Kitjesen/orix/training/runtime/README.md

# SmallDog V67 / MoE-CTS 仿真接入

本目录固定采用 V67 外观、原机架和 12 关节、电池。V67 头部和耳朵在本轮作为固定组件。

## 当前资产与训练（2026-10-14）

当前运动资产为 `v67_sim_r3`：大腿位置范围包含零位，calf 最大绝对角度扩到 2.10 rad；默认站姿与高度沿用 r2。几何采样、真实 Isaac 站立/扩展动作、平地/多地形接触和 80 环境热启动测试已通过。参数来源为 `joint_motion_config.json`；当前范围、证据和启动记录见 [TRAINING_R3_20261014.md](TRAINING_R3_20261014.md)。r2 历史记录见 [JOINT_WINDOW_R2_20261013.md](JOINT_WINDOW_R2_20261013.md)。

FlatGait 600 次迭代和后续 RoughGait 1800 次追加迭代均已完成，最终模型 `model_2398.pt`。速度课程已解锁到 1.0 m/s，平均地形等级 3.64。独立测试：1.0 m/s 平地实际均速 0.922、16 环境 10 秒 0 次终止；80 环境多地形实际均速 0.892、7 次终止，全部在台阶组。结果与剩余问题见 [R3_RESULTS_20261014.md](R3_RESULTS_20261014.md)。下文早期批次记录为历史。

## 数据和假设

- 壳体及安装件来自 `design/v67_continuous_head_tail/assembly.json` 对应实际闭合网格，按记录的 PETG / 铝 / 钢密度计算体积、质量、质心、惯量；没有使用旧 V3 外壳惯量。
- 电池继续采用 1.6 kg 占位；头部电子件预留 0.2 kg，计算板预留 0.15 kg。两项电子质量未实测。
- 总质量估算 13.902960 kg；基础机械零件惯量保留原记录。
- 计算板占位从 z=126 mm 下移至 110 mm，避免穿出 V67 上盖。这是仿真布置提案，安装结构尚未设计。
- 用户在 2026-10-12 确认 calf 按总等效 2∶1 接入。RS02 模组输出轴之后的速比乘一次，不重复乘内部 7.75。
- 仿真名义条件 48 V。hip/thigh 力矩限幅 7 N·m；calf 为 14 N·m。速度上限分别 42.9351 / 21.4675 rad/s。DCMotor 线性饱和包络采用 17 / 34 N·m 截距，是保守近似，不是官方完整 T-N 曲线或热模型。
- 输出轴旋转惯量 hip/thigh 0.0042 kg·m²，calf 按速比平方折算为 0.0168 kg·m²。
- 初始 PD：hip/thigh Kp=40、Kd=0.8；calf Kp=60、Kd=1.5，均为关节端仿真整定值。
- 位置限位采用本轮基于模型采样并经过 Isaac 验证的仿真窗口，详见当前资产报告；不是实测硬止挡。动作目标裁剪到各区间中间 90% 的软窗口。
- 上盖、头部和耳朵使用分离凸包，侧板和腹部采用简单碰撞体；保留原腿部碰撞和四个独立足端。碰撞代理不能替代 CAD 干涉检验。

以上配置支持仿真开发，不是实机控制参数确认。

## 文件

- `joint_motion_config.json`：当前运动窗口、默认站姿、root 高度、软限位和动作缩放的来源。
- `build_asset.py`：从 V67 源文件、运动参数和已保存的外观预览重新生成质量、碰撞和完整资产。
- `assets/smalldog_v67/urdf/smalldog_v67.urdf`：新的仿真 URDF。
- `assets/smalldog_v67/config/model_contract.json`：质量明细、初始角度和假设。
- `overlay/`：合入 Go2 RL RobotLab 源码的 SmallDog 专用配置和验证脚本。

环境 ID：`RobotLab-SmallDog-V67-Flat-v0`。
算法：上游 `OnPolicyRunnerCTS` / `ActorCriticMoECTS`，8 专家，teacher 环境比例 75%。
首轮任务：低速平地；前后速度 -0.15～0.35 m/s、横移 ±0.10 m/s、转速 ±0.3 rad/s。

## 服务器命令

工程：`/root/autodl-tmp/workspace/smalldog_cts_moe`。
此服务器 Isaac 的无显示 GPU 启动使用现有 EGL Vulkan ICD：

```bash
cd /root/autodl-tmp/workspace/smalldog_cts_moe
export VK_ICD_FILENAMES=/root/autodl-tmp/vulkan/nvidia_egl_icd.json
./python.sh scripts/smalldog/check_import.py --headless --device cuda:0
./python.sh scripts/rsl_rl/train.py --task RobotLab-SmallDog-V67-Flat-v0 --headless --device cuda:0 --num_envs 128 --max_iterations 200
```

先检查 `validation/v67_import/report.json`，通过质量、关节、足端和静止支撑检查后启动训练。CPU 网络测试、URDF 静态检查和真实 Isaac rollout 是不同的证据。

## 本轮结果与 R2

- 真实 Isaac 导入和 5 秒静止支撑检查通过，报告在 `validation/isaac_import_report.json`。
- R1：128 环境、200 次迭代已完成，614400 个环境步；保存 `model_199.pt`。
- R1 学生策略测试：16 环境、10 秒、0.2 m/s 前进指令，0 次终止，平均速度约 -0.000388 m/s，平均绝对误差 0.200388 m/s。说明只学到了支撑，尚未学会跟随前进指令。
- R2：线速度奖励核 std 从 0.5 改为 0.2，角速度 std 从 0.5 改为 0.35，增加权重 0.25 的足端离地时间奖励（阈值 0.12 s）。机器人、限位和 2∶1 传动不变。
- `continue_v67_r2.sh` 从指定 R1 checkpoint 继续，512 环境、1800 次额外迭代。RSL-RL 恢复时计数从 199 开始，因此迭代编号可能重叠一轮。
- 尚未证明稳定行走。训练结果必须再次使用学生策略测试实际速度和姿态。
- 启用相机时 RTX 插件仍出现原生崩溃；无相机模式的物理仿真和训练已运行。没有提供虚构的 Isaac 渲染图。

## R2 完成与独立评估（2026-10-12）

- 北京时间约 15:44:57 保存最终模型 `model_1998.pt`，训练进程已退出。
- 512 个并行环境，从 R1 恢复后额外运行 1800 次迭代，22,118,400 个环境步，耗时 42 分 57 秒。
- 最终学生策略独立测试：16 个环境、10 秒、前进指令 0.2 m/s；第 2 秒后平均前进速度 -0.00016824 m/s，平均绝对速度误差 0.20016822 m/s。
- 测试终止次数 0，平均直立余弦 0.98998。能维持姿态，但尚未学会有效前进，不能判定训练成功。
- 本地保存：`training/v67_cts/checkpoints/model_1998.pt`、`training/v67_cts/validation/student_eval_r2.json`、`training/v67_cts/validation/v67_r2.log`。
- 后续应检查动作裁剪、足端抬起与接触、关节力矩及奖励贡献；目前这些只是待排查方向，尚未确定失败原因。未自动启动第三轮训练。

## R3：4096 环境续训（2026-10-12）

用户要求将并行环境增至 4096，已从 R2 `model_1998.pt` 启动 `v67_rs02_2to1_r3_4096`，追加 1800 次迭代，奖励、机器人资产及执行器参数沿用 R2。启动脚本：`overlay/continue_v67_r3_4096.sh`；远程日志：`validation/v67_r3_4096.log`。进程 PID 819348。启动检查已看到 iteration 2015/3798，约 55,852 环境步/秒，整卡显存约 19.5 GB（含其他任务），无启动失败。该记录仅证明已开始迭代，不证明已学会行走。

## R3 中期评估：model_3100.pt（2026-10-12 16:42 左右，北京时间）

- 对照本地渲染源与服务器训练 URDF，文件内容完全相同。
- 4096 环境续训仍在运行；16:41 日志为 iteration 3159/3798。
- 独立学生策略评估：16 环境，10 秒，前进指令 0.2 m/s。第 2 秒后平均前进速度 0.0943302 m/s，平均绝对速度误差 0.1056705 m/s，终止次数 0，平均直立余弦 0.9973658。
- 相比 R2 近零前进速度有进展，但该短时平地测试未证明稳定步态、足端无滑动、复杂地形或实机能力。
- 评估报告：validation/student_eval_r3_3100.json。

## R3 最终模型与 1.0 m/s 指令测试（2026-10-12）

- 4096 环境续训结束，最终 model_3797.pt，日志耗时 51:07；最终模型已下载至 checkpoints/。
- 使用最终学生策略，16 环境、平地、固定前进指令 1.0 m/s，10 秒。
- 第 2 秒后平均速度 0.0145102 m/s，平均绝对速度误差 0.9854898 m/s，累计终止重置 11 次，平均直立余弦 0.9816115。统计包含重置后的轨迹，不能把 11 次解释为 11 个不同环境跌倒，未细分原因。
- 1.0 m/s 超出训练命令上限 0.35 m/s；本次结果不支持 1 m/s 行走能力，也不能推出机器人硬件速度上限。
- 报告：validation/student_eval_r3_3797_vx1.json。evaluate.py 新增 --command-vx，默认仍为 0.2，仅更改评估入口。

## R4 多地形与速度课程已接入（2026-10-12）

正式任务 `RobotLab-SmallDog-V67-Rough-v0`，4096 环境，8 类地形，从最低等级开始；前进命令上限按表现从 0.35 增至 1.0 m/s。完整配置见 ROUGH_TRAINING.md。

当前运行：`2026-10-12_17-35-59_v67_rough_speed_r4`，由 R3 model_3797.pt 继续，追加 3000 次迭代。早期启动版本因首回合计时影响课程评分被主动停止，当前版本已排除该问题。验证报告 validation/rough_import_report.json；实际运行配置 validation/r4_config/。验证通过表示接入可运行，不表示已学会复杂地形或 1 m/s。

## R4 中期效果（2026-10-12 17:56 后）

17:56 训练日志 iteration 4177/6797，运行 20 分钟，速度课程上限仍为 0.35 m/s，平均地形等级 0.1296。

model_4100.pt 学生策略独立测试：80 环境，8 类第 0 级地形，固定前进命令 0.2 m/s，10 秒。平均前进速度 0.182663 m/s，平均绝对速度误差 0.071250 m/s，累计终止 0。平地 0.193479 m/s；stairs_down 配置场景 0.114690 m/s，其他场景详见 validation/student_eval_r4_4100_rough.json。

测试关闭观测噪声和域随机化；只证明低等级地形上的短时低速表现，不证明完整地形穿越、高等级障碍、标准步态或实机能力。平均速度接近指令不代表瞬时速度误差很小。

## R5 续训（2026-10-12）

从 R4 最终 model_6796.pt 继续 3000 次迭代，4096 环境，多地形和速度课程保持不变。补充 SMALLDOG_SPEED_GATE 日志，记录每批合格前进回合数、通过率、超时完成率及平均归一化速度误差，便于定位 0.35 m/s 停滞。已验证该函数在模拟失败/成功/提前终止数据下的升级条件及 1 m/s 封顶。合成测试不作为学习能力证据。

运行：`2026-10-12_20-59-41_v67_rough_speed_r5`；实际配置 validation/r5_config/；启动脚本 overlay/start_v67_rough_r5.sh。课程状态重新从 0.35 m/s 和地形第 0 级初始化，策略及优化器从最终模型恢复。R4 最终 checkpoint 已下载至 checkpoints/model_6796.pt。

R5 初始两批真实课程评分：128 回合中分别 28、22 个达标，通过率 21.875%、17.1875%，低于 70%；两批均仅 55/128 正常超时结束。说明当前续训样本确实未达升级条件，不能从总体平均速度误差推出课程达标。该数据来自 R5 初期，不可冒充 R4 历史通过率。证据 validation/r5_initial_speed_gate.json。

## 当前运动录像（2026-10-12，model_7500.pt）

从 R5 最新保存学生策略采集 10 秒实际 Isaac 平地物理轨迹，固定前进指令 0.3 m/s。16 环境测试无终止，平均 vx=0.223008 m/s、平均绝对误差=0.101747 m/s。录像固定使用环境 0，不挑选最佳回合；该环境第 2 秒后平均 vx≈0.255976 m/s，10 秒世界 XY 位移约 (2.3324,0.4699) m。

源记录 validation/motion_latest.json，每 2 个控制步采集全部 19 个实际刚体 link 世界位姿，25 fps。视频使用同一 URDF 外观网格回放这些位姿，无自编步态或轨迹平滑；它是实际物理轨迹回放，不是 Isaac RTX 相机直录。录制脚本 overlay/scripts/smalldog/record_motion.py。
