Kitjesen/orix/docs/model.md

# 当前模型参数

版本：`v67_sim_r5_headless`。以下为当前仿真资产配置，角度单位为 rad，长度为 m。

## 默认站姿和关节窗口

| 关节 | 默认角度 | 下限 | 上限 |
| --- | ---: | ---: | ---: |
| `fr_hip_joint` | 0.000000000 | -1.050000000 | 1.050000000 |
| `fr_thigh_joint` | -0.671553434 | -3.140796327 | 1.919203673 |
| `fr_calf_joint` | 1.100000000 | 0.400000000 | 2.100000000 |
| `fl_hip_joint` | 0.000000000 | -1.050000000 | 1.050000000 |
| `fl_thigh_joint` | 0.671553434 | -1.919203673 | 3.140796327 |
| `fl_calf_joint` | -1.100000000 | -2.100000000 | -0.400000000 |
| `rr_hip_joint` | 0.000000000 | -1.050000000 | 1.050000000 |
| `rr_thigh_joint` | -0.671553434 | -3.140796327 | 1.919203673 |
| `rr_calf_joint` | 1.100000000 | 0.400000000 | 2.100000000 |
| `rl_hip_joint` | 0.000000000 | -1.050000000 | 1.050000000 |
| `rl_thigh_joint` | 0.671553434 | -1.919203673 | 3.140796327 |
| `rl_calf_joint` | -1.100000000 | -2.100000000 | -0.400000000 |

用户确认的大腿范围 [-1.57, 3.49] rad 以大腿竖直向下为零位、向后摆为正方向。保留当前 URDF 零位和关节轴后，右腿使用 q_URDF = q_参考 − π/2，左腿使用 q_URDF = π/2 − q_参考；上表是换算后的实际 URDF 限位，不能直接把参考范围填到四个关节。`fr/fl/rr/rl` 分别表示右前、左前、右后、左后。

默认根高度为 **0.2674918209 m**，总质量估计 **13.333465 kg**。关节目标使用硬范围中间 90% 的软窗口，hip / thigh / calf 原始任务动作缩放为 0.15 / 0.20 / 0.20 rad；当前 FR-Net 恢复任务覆盖为 0.20 / 0.50 / 0.50。

## 执行器

| 关节 | 力矩限幅 | 速度限幅 | Kp | Kd | armature |
| --- | ---: | ---: | ---: | ---: | ---: |
| hip / thigh | 17 N·m | 42.93510 rad/s | 40 | 0.8 | 0.0042 kg·m² |
| calf | 17 N·m | 21.46755 rad/s | 60 | 1.5 | 0.0168 kg·m² |

calf 按总等效 2∶1 接入，不重复乘电机内部减速比。本次恢复任务的 DCMotor 输出上限、物理引擎限幅与饱和截距全部为 17 N·m；小腿的力矩上限不再乘 2。速度和惯量继续使用既有传动配置；这不是经实机验证的完整热模型。

## 外观与质量假设

- 2026-11-12 按用户要求移除整个头部、耳朵、头部支架、紧固件和装饰，头部碰撞体也已移除。
- 电池 1.6 kg、计算板 0.15 kg 为估计；头部电子件原有 0.2 kg 已随头部扣除。整机减少约 0.569495 kg，躯干重心和惯量同步重算。
- 裸主板包络为 220×120×2 mm，仿真布置中心 Z=110 mm；完整器件、接口、安装、线束和散热尚未定型。
- 碰撞使用原腿部碰撞、机身简单几何以及上壳凸包代理。
- 髋和大腿窗口按 2026-11-12 用户要求扩展，小腿保留原窗口；这些范围不等于已完成 CAD 干涉扫掠或实测机械止挡验证。
- README 图片采用默认角度作静态 FK；视觉足底离地与真实接触需在物理仿真中分别核对。

参数来源：[model_contract.json](../training/v67_cts/assets/smalldog_v67/config/model_contract.json) 与 [joint_motion_config.json](../training/v67_cts/joint_motion_config.json)。
