Kitjesen/orix/training/v67_cts/TRAINING_R3_20261014.md

# SmallDog V67：R3 扩展运动窗口与多地形续训

日期：2026-10-14（Asia/Shanghai）。资产版本 `v67_sim_r3`。

完成更新：1800 次追加训练已经正常结束，最终 `model_2398.pt`。固定命令平地和多地形测试见 [R3_RESULTS_20261014.md](R3_RESULTS_20261014.md)，台阶组仍有异常终止。本文件下面保留启动时的配置和验证记录。

用户授权开启新的训练。新一轮使用 V67 外壳、电池和 12 关节，扩展经过模型采样和 Isaac 检查的仿真运动窗口，恢复多地形课程，并从同一相位观测网络的 `model_599.pt` 续训。网页自由查看的 ±180°不是本轮训练范围。

## 新训练的运动范围

| 关节组 | URDF 位置范围 rad | 90% 动作目标软窗口 rad |
|---|---|---|
| 四腿 hip | [-0.30,+0.30] | [-0.27,+0.27] |
| FR/RR thigh | [-1.25,+0.15] | [-1.18,+0.08] |
| FL/RL thigh | [-0.15,+1.25] | [-0.08,+1.18] |
| FR/RR calf | [+0.40,+2.10] | [+0.485,+2.015] |
| FL/RL calf | [-2.10,-0.40] | [-2.015,-0.485] |

大腿总跨度从 r2 的 1.0 rad 扩到 1.4 rad（约 80.21°），并让 0 rad 落在动作软窗口内部。硬上界只扩到 0 会被中央 90% 软窗口再次排除，因此给零位另一侧留了 0.15 rad。

小腿总跨度从 r2 的 0.97 rad 扩到 1.70 rad（约 97.40°）。0.40 rad 下界保留，以避开此前采样发现的后腿完全内摆加完全折叠时脚端与机身干涉。

默认姿态仍为 hip=0，右 thigh=-0.6715534336、calf=+1.10，左腿反号。初始化 root 高度 0.2674918209 m，高度奖励目标 0.2561583500 m。动作缩放仍为 hip=0.15、thigh/calf=0.20 rad；执行器力矩、速度、PD、2:1 折算及 13.9029595979 kg 总质量沿用前一版。

这是实验仿真运动窗口。实体齿轮啮合、闭环连杆行程、机械止挡和编码器零位尚未校准，本轮没有声称完成硬件全行程认证。

## 启动前验证

### 运动几何

- 主网格四腿各 147 点，共 588 点：0 个碰撞样本。
- thigh=0 的 84 点专项：0 个碰撞样本。
- canonical thigh=-0.15 的 84 点专项：0 个碰撞样本。
- 同端左右腿 18 组、同侧前后腿 14 组代表组合：均无碰撞样本。
- 使用现有 URDF 包络，排除直接连接关节的预期重叠；这不是连续全空间碰撞认证。

证据：`validation/joint_window_r3_review/README.md`、`joint_window_r3_review.json`。

### Isaac 物理导入与受控动作

- 8 环境、5 秒零动作站立：0 次异常终止。
- 直接读取 PhysX 的 12 个位置上下限，确认使用新窗口和新版本 USD。
- 默认姿态下 24 个 raw action=±1 测试均不被目标裁剪。
- 4 个固定 base 环境分别检查四腿：大腿实测越过零位约 0.0284 rad；小腿绝对角度实测达到约 1.9951 rad，超过原 1.37 rad 上界。
- 受控轨迹在新动作软窗口内执行。该结果证明受控动作，不是学习策略的行走效果。

证据：`validation/joint_window_r3_static_report.json`、`joint_window_r3_expanded_report.json`。

### 平地与多地形接触数据

FlatGait 和 RoughGait 各 8 环境、120 步验证通过：地面接触点覆盖率 100%，零动作异常终止 0，policy/critic/single_obs 维度 470/277/47，观测有限。

RoughGait 首次检查发现接触过滤器指向 `/World/ground/terrain` 父 Xform。虽然能读取脚力，但过滤后的 contact points 全为 NaN，覆盖率为 0。已修成实际碰撞 Mesh `/World/ground/terrain/mesh` 并复测通过。FlatGait 保留其实际 CollisionPlane 路径。

Isaac 在该次 Python AssertionError 后返回了进程退出码 0，因此启动判定以报告文件存在且 `pass=true` 为准。初次失败日志保存在远程 `validation/r3_preflight_gait_rough_initial_filter_failure.log`。

证据：`validation/gait_import_r3_flat_report.json`、`gait_import_r3_rough_report.json`。

## 上一轮与热启动评估

R2 平地试训完成 600 次迭代，保存 `model_599.pt`，累计 58,982,400 环境步。

| 独立学生策略测试 | r2 资产、16 环境 | r3 资产、80 环境 |
|---|---:|---:|
| 指令 vx | 0.30 m/s | 0.30 m/s |
| 时长 | 10 s | 10 s |
| 异常终止 | 0 | 0 |
| 第 2 秒后平均 vx | 0.325981 m/s | 0.321081 m/s |
| 平均绝对 vx 误差 | 0.028092 m/s | 0.024361 m/s |
| 平均直立余弦 | 0.996301 | 0.996270 |
| 四脚 foot link 垂直运动范围 | 35.6～47.8 mm | 37.7～47.1 mm |

r3 热启动时两种单一对角支撑各占约 32.0%、36.0%，四脚接触约 23.1%。这些是短时平地测试，不代表多地形或实机能力。前 hip 的动作目标仍有约 21%～33% 裁剪，前 thigh 约 14%～15%，仍需在新训练中跟踪；四个 calf 的目标裁剪率均为 0。

证据：`validation/gait_r2_599_eval.json`、`gait_r3_warm_start_80_eval.json`。评估脚本 `overlay/scripts/smalldog/evaluate_gait.py` 使用相位任务，避免把旧 Flat-v0 的 450 维配置用于当前 470 维策略。

## 新训练启动

- 服务器：`connect.weste.seetacloud.com:33015`。
- 工程：`/root/autodl-tmp/workspace/smalldog_cts_moe`。
- 启动时间：2026-10-14 01:44:08 +08:00。
- PID：886107。
- 任务：`RobotLab-SmallDog-V67-RoughGait-v0`。
- 并行环境：4096。
- 网络：同一套 8 专家 MoE-CTS；teacher 75%、student 25%，32 维 latent，12 维动作。
- 从 `2026-10-13_20-54-56_v67_joint_window_r2_gait_pilot/model_599.pt` 恢复。
- 追加 1800 次迭代。远程 runner 的循环是 `start_it + num_learning_iterations`，所以从 599 开始，预计最后编号 2398。
- 运行名：`v67_joint_window_r3_rough_gait`。
- 日志：`validation/v67_joint_r3_rough_training.log`。
- 元数据：`validation/v67_joint_r3_rough_training_run.json`；最终启动检查状态以其中记录为准。
- 启动检查已观察到全局 iteration 615/2399（599 起累计 17 次新迭代），新运行累计 1,671,168 环境步，进程存活。日志地形等级 0、速度上限 0.35 m/s；GPU 占用约 11.4 GiB。该记录证明已实际开始训练，尚未对新 checkpoint 做独立多地形性能评估。

### 地形和命令

| 地形 | 比例 |
|---|---:|
| 平地 | 30% |
| 随机粗糙地面 | 15% |
| 上坡 / 下坡 | 各 10% |
| 上台阶 / 下台阶 | 各 10% |
| 离散障碍 | 10% |
| 波浪地形 | 5% |

初始地形等级为 0，按课程提高难度。初始前后速度 -0.15～+0.35 m/s，横移 ±0.10 m/s，转向 ±0.30 rad/s，10% 站立命令。表现满足课程门槛后，前进上限每次增加 0.10 m/s，最高 1.0 m/s。本次没有直接跳到 1.0 m/s。

## 保存与同步

旧 r2 URDF、契约、站姿、运动参数和验证报告已备份至 `validation/joint_window_r2_baseline/`，旧 checkpoint 保留。参数来源继续为 `joint_motion_config.json`，构建脚本同步生成 URDF、站姿和契约。USD 使用独立 `v67_sim_r3.usd`，避免复用旧限位。

手动 HTML 已同步到 r3。在训练范围模式下，大腿 0 rad 现在也能直接操作；自由几何模式 ±180°继续用于观察。制作和离线浏览器验证记录保存在 `joint_control/`。

本轮后续评估须检查各地形重置/速度误差、四足接触与净空、关节目标裁剪和力矩饱和。训练进程进入迭代只证明训练已开始，不能直接声称新策略已学会全部地形。
