Kitjesen/orix/design/v67_continuous_head_tail/comparison.html

# V67 · 连续背壳与加宽后脑

针对 V66 红圈位置的实体调整 · 同材质 / 同视角比较

原生 CAD 造型评审

## 01 / 本轮三视图

尾部横条并入背盖；后脑截面加宽，前肩过渡向机身中部延伸。头部保持固定可拆，脸部、耳轴、安装孔及电机位置保持。

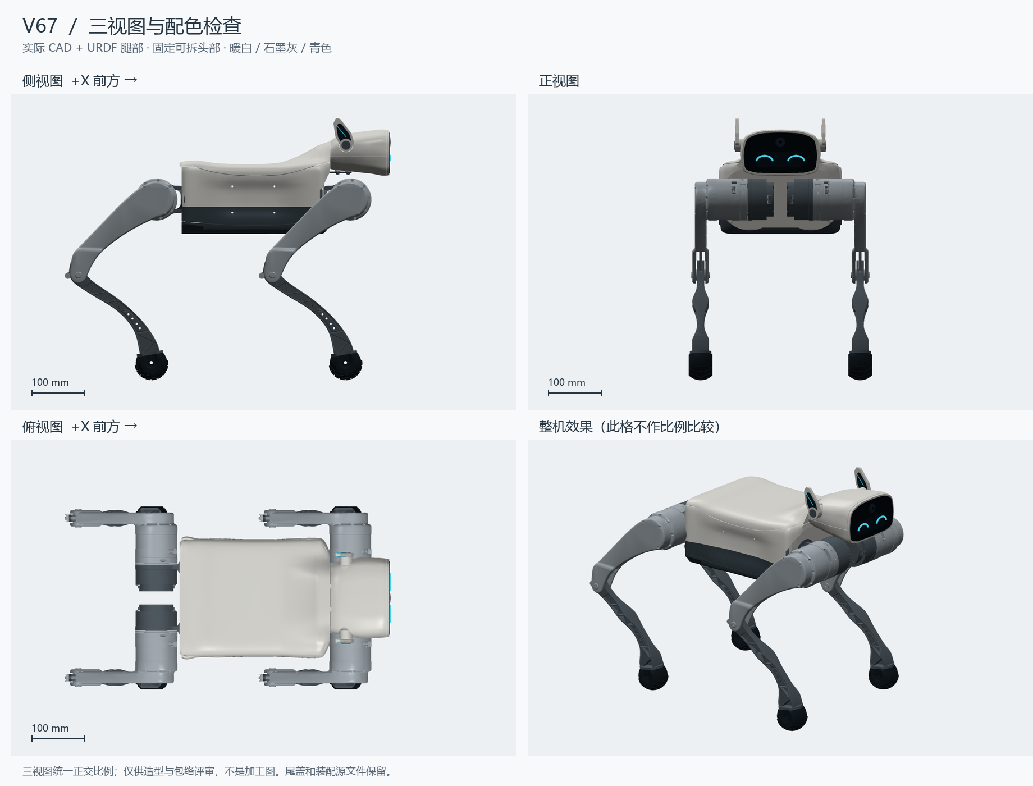
[picture p4: design/v67_continuous_head_tail/previews/00-three-views.png]


## 02 / 对比你圈出的断裂位置

V67 本轮 V66 上一轮

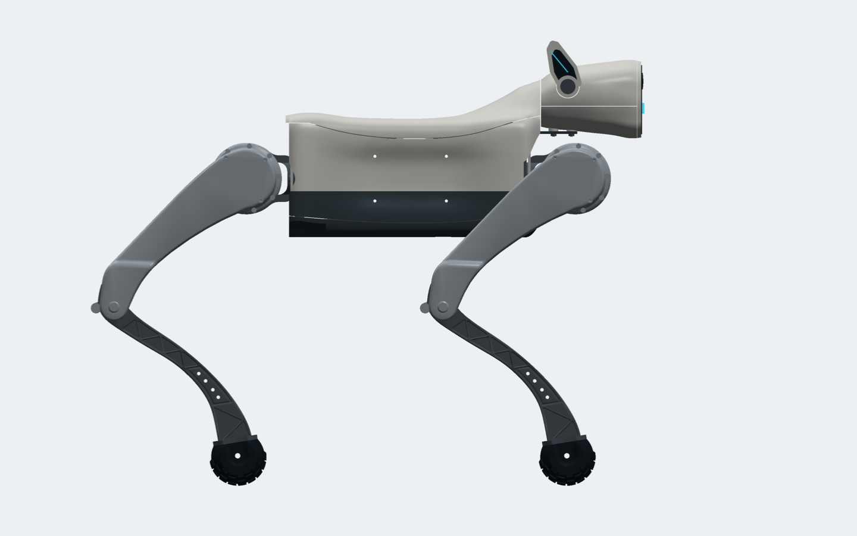
[picture p5: design/v67_continuous_head_tail/previews/02-side.png]


侧视：后端不再单独翘出横条，前肩抬升拉长

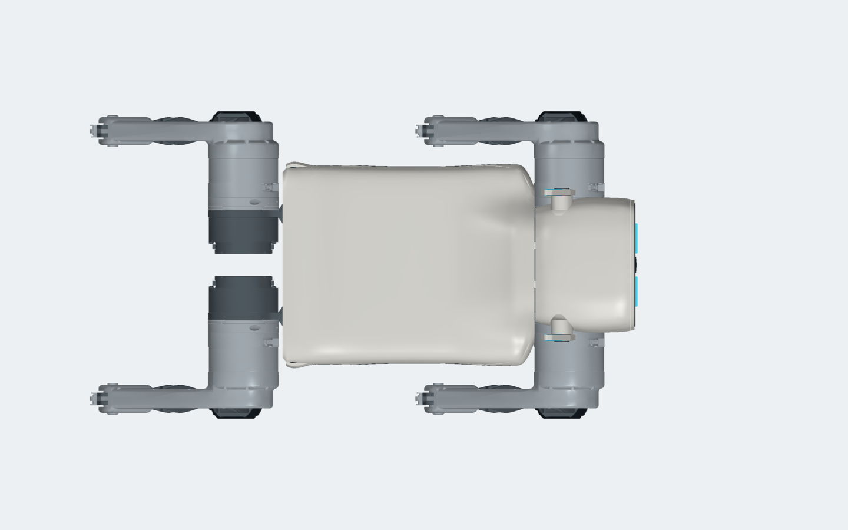
[picture p6: design/v67_continuous_head_tail/previews/02-top.png]


俯视：取消尾盖横向分缝，加宽后脑连接处

## 03 / 头身连接近景

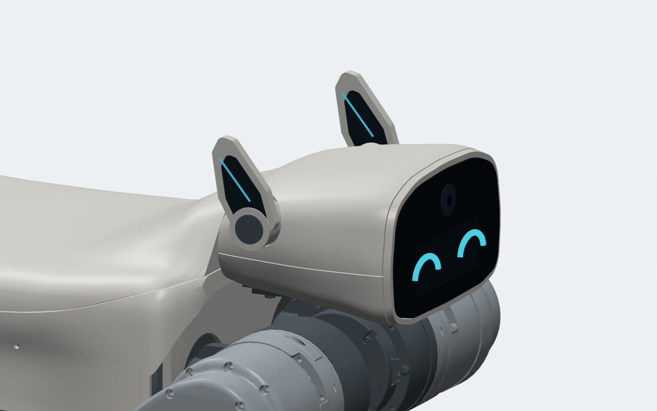
[picture p7: design/v67_continuous_head_tail/previews/03-head-neck.png]


后脑轮廓控制半宽从 48/42 mm 调整为 66/60 mm（上/下）。头部仍是独立零件；保留 1 mm 轴向拆装缝。这里追求外轮廓连续，但尚未取得严格的相切/曲率连续性认证。

## 04 / 尾部与整机

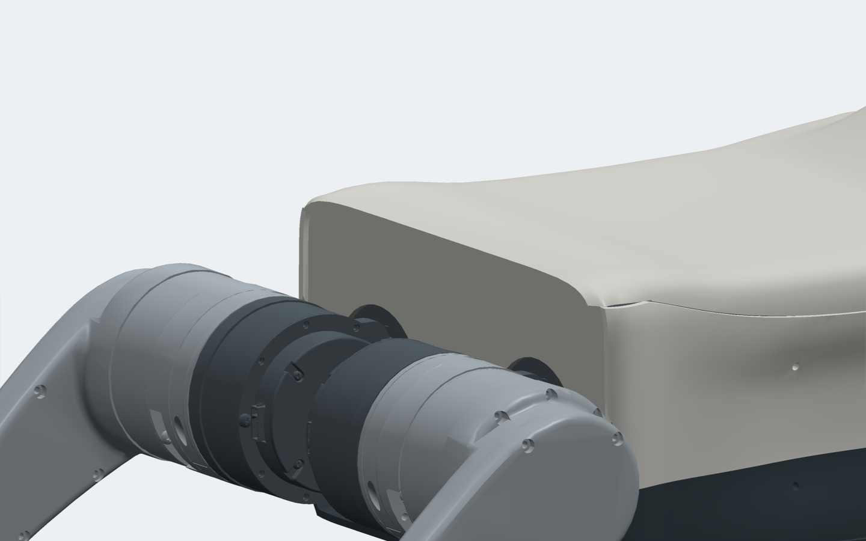
[picture p8: design/v67_continuous_head_tail/previews/04-tail-after.png]


尾部和上盖同体成形，后板仍可拆

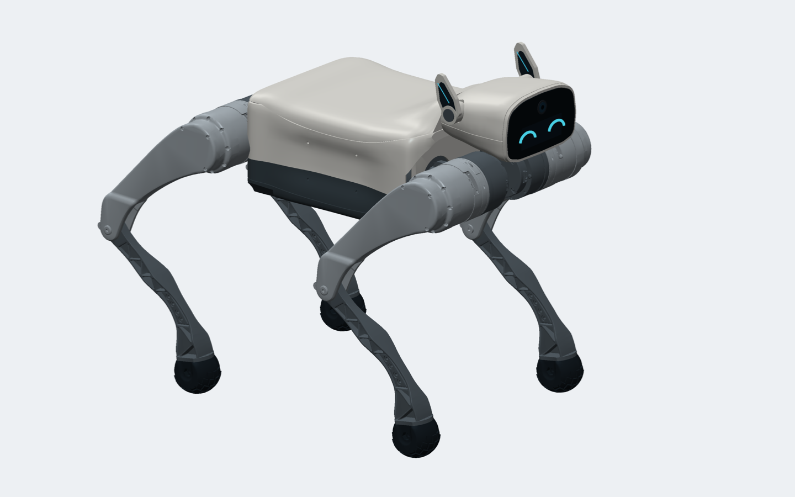
[picture p9: design/v67_continuous_head_tail/previews/01-assembled.png]


暖白 / 石墨 / 冷灰配色保持，便于判断形状变化

## 05 / 装配和过程

SolidWorks 装配 · STEP 装配 · 背壳曲面母体 · 头壳曲面母体 · 版本记录

网格及离散腿姿检查 · 安装处原生实体求交 · 完整 V66 页面

回看最初参考图

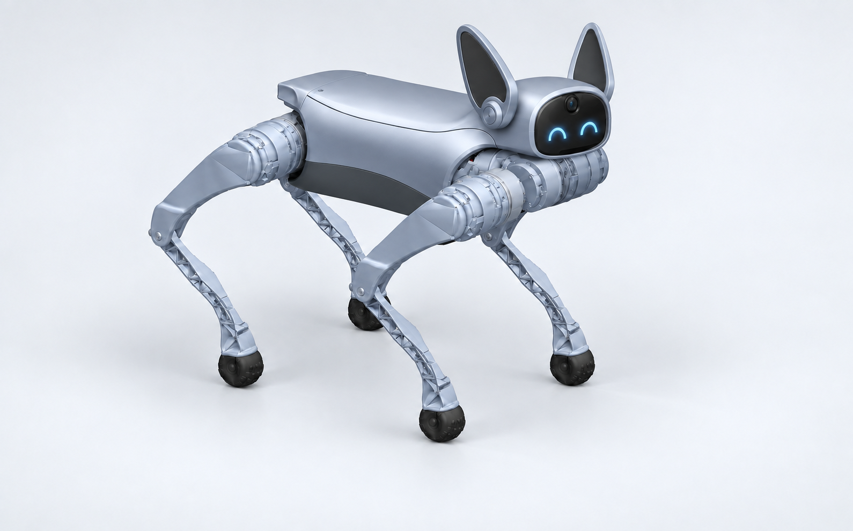
[picture p10: design/v67_continuous_head_tail/reference/user-reference.png]


这是可追溯的原生造型与试装版。局部头身接缝、上盖固定、密封、最小壁厚和完整电子器件包络仍需落实；离散检查不能替代连续运动或实物验证。原生装配包括机架、外壳、安装件；渲染腿部来自 URDF。本轮本地保存，未推送 GitHub。
