Kitjesen/orix/training/v67_cts/ROUGH_TRAINING.md

# SmallDog V67 / R4 多地形与速度课程

## 任务与网络

正式多地形入口：`RobotLab-SmallDog-V67-Rough-v0`。
启动脚本：`overlay/start_v67_rough_r4.sh`。
从 R3 `model_3797.pt` 恢复参数及优化器，4096 环境，追加 3000 次迭代。
算法仍为 MoE-CTS，学生编码器 8 专家，32 维潜变量；教师/学生环境比例 75%/25%。观测维度 policy=450、single_obs=45、critic=275。
现有 17 项奖励、机器人资产、关节限位、动作缩放和执行器保持原配置。

## 地形

8 行难度、20 列，单块 6×6 m，从第 0 级开始。基础机身高度按局部地面计算。地形生成配置上限不等于机器人已能通过的障碍高度。

| 类型 | 权重 | 生成参数范围 |
|---|---:|---|
| 平地 | 30% | 平面 |
| 随机粗糙 | 15% | noise_range 0.005～0.025 m |
| 上坡 | 10% | 坡度比 0～0.22，最大约 12.4° |
| 下坡 | 10% | 同上 |
| 上台阶 | 10% | 高度 0.01～0.10 m，踏面 0.25 m |
| 下台阶 | 10% | 同上 |
| 离散障碍 | 10% | 高 0.01～0.10 m，宽 0.3～0.8 m，20 个 |
| 波浪 | 5% | 幅度参数 0.01～0.08 m，3 个波 |

使用兼容 UniformVelocityCommand 的 Isaac Lab 距离课程：回合结束时距环境原点超过 3 m 升级；小于命令平面速度×15 s×0.5 且不满足升级时降级。第一次初始化重置跳过评分，避免把未初始化世界坐标当作运动距离。最高等级通过后的分配遵循 Isaac Lab TerrainImporter 的既有逻辑。

## 速度课程

初始 vx=[-0.15,0.35] m/s，vy=±0.1 m/s，yaw=±0.3 rad/s。站立比例 10%。每条命令保持完整 15 秒回合。

升级使用符合条件的前进回合：vx ≥ 当前上限×0.6，|vy|<0.06，|yaw|<0.15。
训练器会随机设置首回合计时，因此首次 750 个控制步（15 秒）不计入速度升级评分，避免不完整启动回合造成低误差假象。

累计 128 个符合条件的回合后，至少 70% 同时满足正常超时结束、平均平面速度误差小于 max(0.08 m/s, vx×0.25)，才将前进上限增加 0.1 m/s；最大 1.0 m/s。
不达标保持原上限，重新累计。Curriculum/forward_speed 日志记录实际命令上限。

这是按表现解锁速度，不保证本轮一定升到 1 m/s。负向、横向、偏航范围当前固定。课程累计状态没有写入模型 checkpoint；重启该任务会从 0.35 m/s 和最低初始地形等级重新开始。

## 验证说明

check_rough.py 使用 80 个环境覆盖 20 列，载入已有学生策略运行 800 个控制步（16 秒），检查有限观测、状态、地形射线和重置；该检查不等于已经学会多地形运动。
另用合成回合结果检查速度失败保持、成功递增、1 m/s 封顶及提前终止不升级，合成测试不作为学习效果证据。
