Kitjesen/orix/training/v67_cts/TRAINING_R6_PLUS10000_20261015.md

# R6：0～10 级多地形与追加 10000 轮

记录时间：2026-10-15；以下运行快照核验于北京时间 20:40:15。

## 本次修正

早期 SmallDog 自定义地形配置使用 `num_rows=8`，因此有效地形索引为 0～7。这是配置选择，不是算法、机器人或课程的能力上限。本次续训最初沿用了该设置，未与用户要求同步，现已在独立 R6 任务中修正。

服务器已安装的 Isaac Lab 标准 rough 模板使用 10 行，其索引实际为 0～9。用户要求最高编号为 10，因此本次明确使用 **11 行、有效索引 0～10**，而不是把 10 行误称为 0～10。

R6 同步了以下内容：

- 生成器：11 行 × 20 列，保留 8 类地形。
- 训练初始分布：4096 环境在 0～10 全范围随机初始化。
- 地形课程：使用实际生成器的行数计算有效索引及升级、降级。
- 训练完成后的独立评估：220 环境，对每一列分配全部 11 个等级。
- checkpoint：保存、恢复每个环境的地形等级和列、速度命令范围及速度课程计数。
- 前进速度课程：从 1.0 m/s 开始，按合格回合表现每次增加 0.1 m/s，本阶段上限 1.5 m/s。
- 步频：保留原 0.3～1.0 m/s 对应 1.5～2.5 Hz 的设置，R6 在 1.0～1.5 m/s 继续增加至 3.0 Hz。

原任务和历史训练记录保留；正式续训入口现在使用 `RobotLab-SmallDog-V67-RoughR6-v0`。

## 等级与物理难度

等级数量控制难度分档，不单独决定台阶高度或坡度。增加行数不会自动扩大各类地形的物理尺寸范围。R6 沿用下列配置范围：

| 地形 | 配置范围 |
| --- | --- |
| flat | 平地 |
| rough | 起伏噪声 0.005～0.025 m |
| slope_up / slope_down | 坡度参数 0～0.22 |
| stairs_up / stairs_down | 台阶高度 0.01～0.10 m，踏面宽度 0.25 m |
| obstacles | 障碍高度 0.01～0.10 m |
| wave | 波形振幅 0.01～0.08 m |

上述是生成器配置范围，不是逐行实测几何尺寸，也不是机器人已通过的能力范围。

日志中的 `Curriculum/terrain_levels` 是环境等级的平均值。旧 R5 的 3.8919 不是上限。当前 Isaac Lab 课程在超过最高有效等级后会将该环境随机分配回有效等级，因此平均值也不会必然单调上升至最高等级。

## 恢复边界

源 `model_12796.pt` 的 `infos=None`，没有逐环境地形状态，不能精确恢复旧运行平均等级 3.8919 对应的环境分布。本次恢复策略及 teacher/student 优化器，在新的 11 行地形中全范围混合起步；`terrain_state_restored=false` 已写入运行清单。

新训练初始等级均值为 4.9541，最低 0、最高 10。这是初始化分布，不表示机器人已经学会第 5 级。后续 checkpoint 已实际保存地形与速度课程状态。

## 实际运行

| 项目 | 值 |
| --- | --- |
| 任务 | `RobotLab-SmallDog-V67-RoughR6-v0` |
| 运行目录后缀 | `2026-10-15_20-22-45_v67_r6_terrain_speed_1p5_plus10000` |
| 工程 | `/root/autodl-tmp/workspace/smalldog_cts_moe` |
| 资产 | `v67_sim_r3`，V67 外壳、电池、12 个运动关节 |
| 算法 | 原 8 专家 MoE-CTS，teacher/student 环境比例 75%/25% |
| 并行环境 | 4096 |
| 源 checkpoint | `2026-10-15_13-05-49_v67_r5_sampling_cache/model_12796.pt` |
| 新增迭代 | 12797～22796，共 10000 次更新 |
| 预期最终 checkpoint | `model_22796.pt` |
| 包装进程 PID | 969264 |
| 训练进程 PID | 969696 |
| 快照状态 | running / training |
| 快照最新迭代 | 13092，已新增 296 次，剩余 9704 次 |
| 快照地形平均等级 | 5.7349 |
| 快照前进速度命令上限 | 1.5 m/s |
| 最近 20 轮平均耗时 | 3.4415 s/轮 |

快照只是上述时间的进展，不能作为之后时刻的实时状态。R5 采样索引缓存修正继续生效；没有再次改动 URDF、运动限位或电机参数。

## 已完成的验证

本次检查针对：地形最高等级未接通、逐列等级遗漏、恢复时地形与速度课程丢失、提速后步频不同步，以及原策略/优化器无法继续训练。

1. 10 项张量及课程状态测试通过；修改文件的 Ruff E4/E7/E9/F 检查通过。
2. 真实 Isaac Lab 预检查使用 220 环境，0～10 每级各 20 个环境，覆盖 20 列的全部 11 级。
3. 加载源 checkpoint 的策略与两个优化器，运行 120 个物理控制步；观测、动作、奖励均为有限值。该检查出现 3 次环境终止，不用作高难地形通过率证明。
4. 保存后故意改变地形和速度课程状态，再重载，逐环境等级、列、命令范围及课程计数恢复一致。
5. 正式训练已保存 `model_12800.pt`，实际读取确认含 4096 个环境的地形状态，地形尺寸 `[11,20]`，并包含两个优化器状态。

预检查过程发现 Isaac 推理张量在普通上下文中重置的异常，已将课程恢复和环境重置放入 `torch.inference_mode()`；通过预检查后才启动正式 4096 环境训练。早期失败尝试没有完成正式续训更新。

## 完成后的评估

包装脚本在最终 checkpoint 保存后，依次使用学生策略测试 0.3、0.6、1.0、1.5 m/s，使用 220 个环境分层覆盖全部 11 级及 20 列地形。结果将分别写入 `validation/r6_final_0p3.json`、`r6_final_0p6.json`、`r6_final_1p0.json`、`r6_final_1p5.json`。

当前仅证明训练与课程接通并开始继续优化；尚未证明 1.5 m/s 或第 10 级地形上的稳定通过能力。

## 证据与入口

- [运行状态快照](validation/r6_training_status_latest.json)
- [预检查结果](validation/r6_preflight.json)
- [实际 checkpoint 状态读取](validation/r6_checkpoint_state_check.json)
- [实际导出的环境配置](validation/r6_config/env.yaml)
- [R6 配置](overlay/source/robot_lab/robot_lab/tasks/smalldog/terrain_r6_cfg.py)
- [课程状态保存和恢复](overlay/source/robot_lab/robot_lab/tasks/smalldog/terrain_state.py)
- [顺序启动与评估脚本](overlay/scripts/smalldog/run_terrain_r6.py)
- [训练入口](overlay/scripts/smalldog/train_terrain_r6.py)
- [已安装 Isaac Lab 标准 rough 模板副本](validation/upstream_standard_rough.py)

服务器运行状态文件为 `validation/r6_training_state.json`，训练日志为 `validation/r6_training.log`，包装日志为 `validation/r6_driver.log`。旧 R5 状态文件保留其完成状态。
