Kitjesen/orix/design/v67_continuous_head_tail/previews/02-front.png

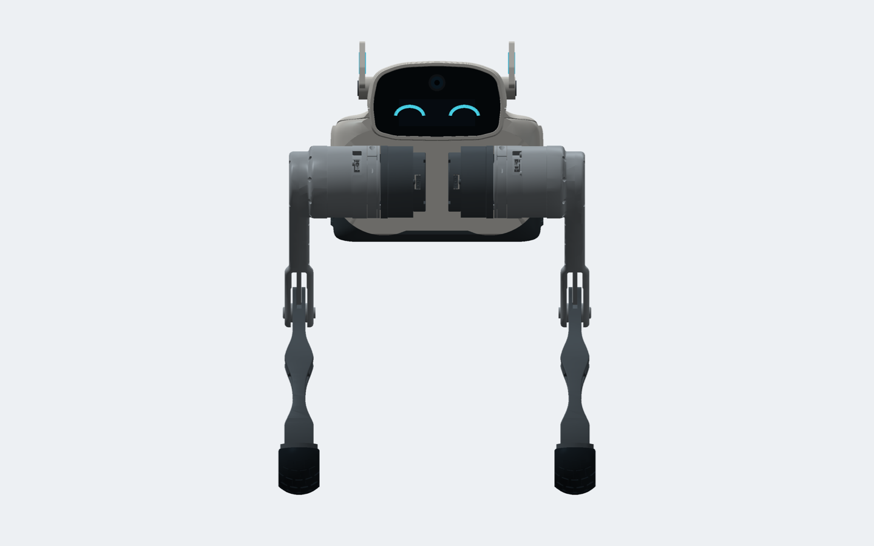
design/v67_continuous_head_tail/previews/02-front.png
