Kitjesen/orix/design/v67_continuous_head_tail/previews/03-rear.png

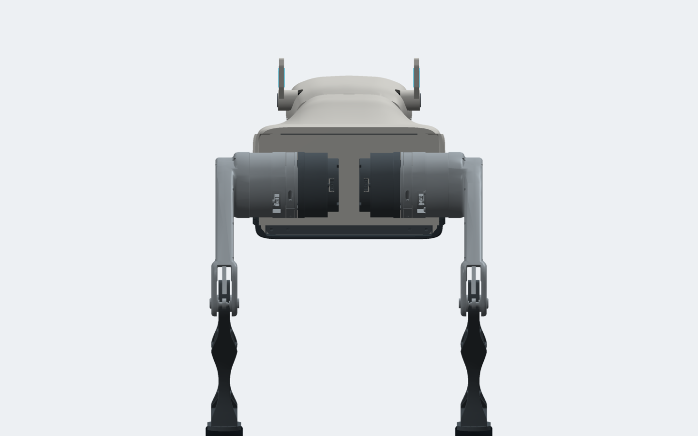
design/v67_continuous_head_tail/previews/03-rear.png
