Kitjesen/orix/docs/images/appearance.png

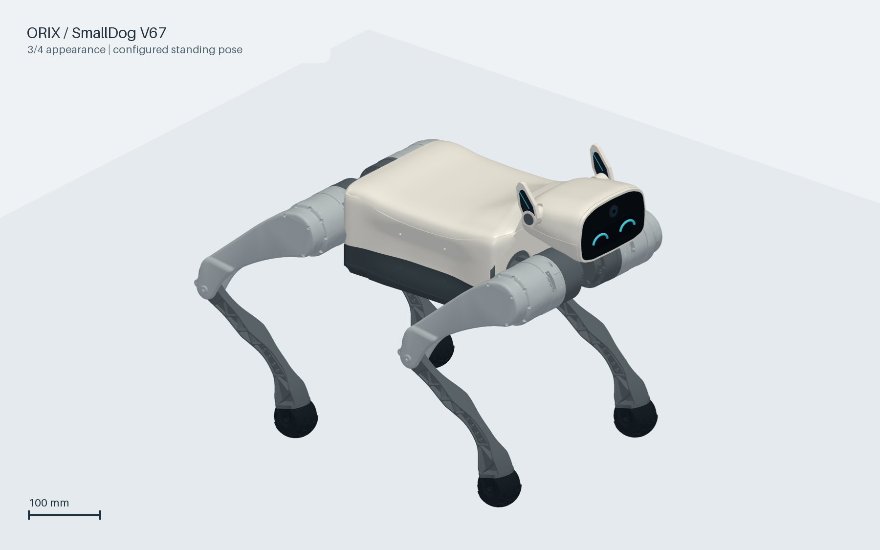
docs/images/appearance.png
