Kitjesen/orix/docs/images/front.png

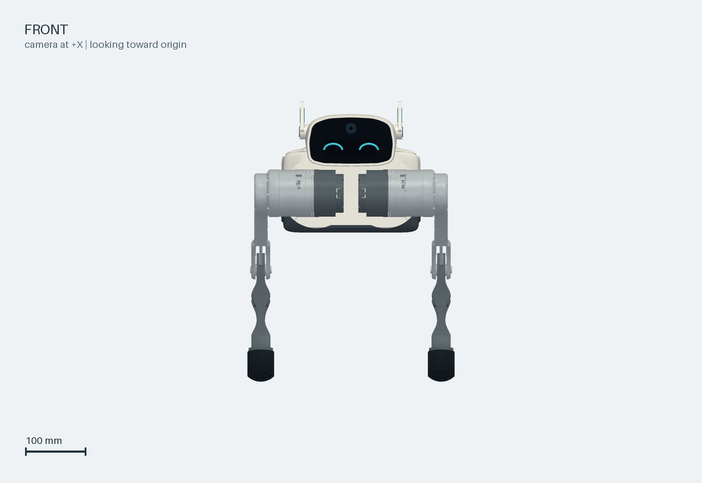
docs/images/front.png
