Kitjesen/orix/docs/images/side.png

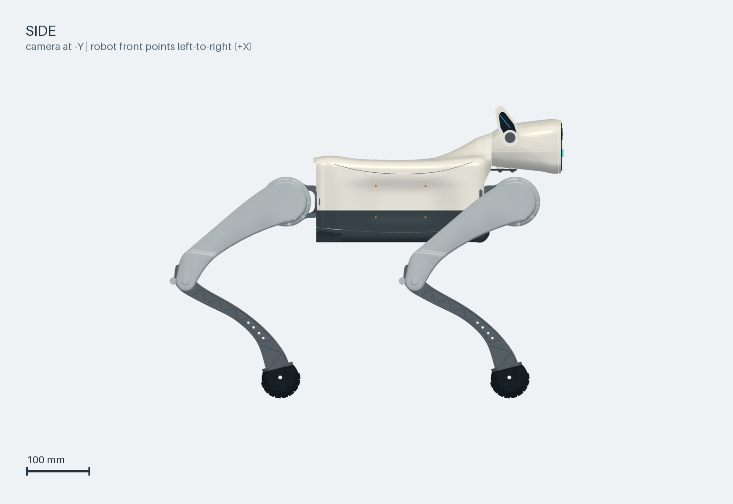
docs/images/side.png
