Kitjesen/orix/docs/images/three_views.png

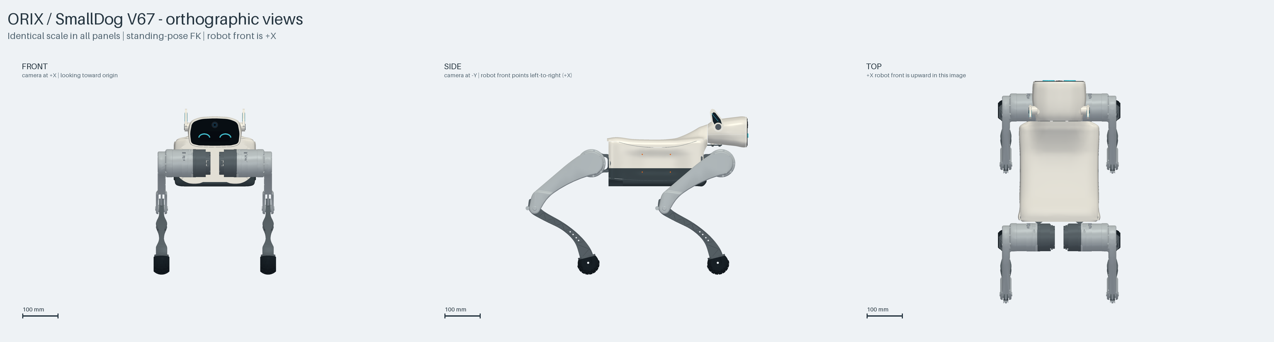
docs/images/three_views.png
