Kitjesen/orix/docs/images/top.png

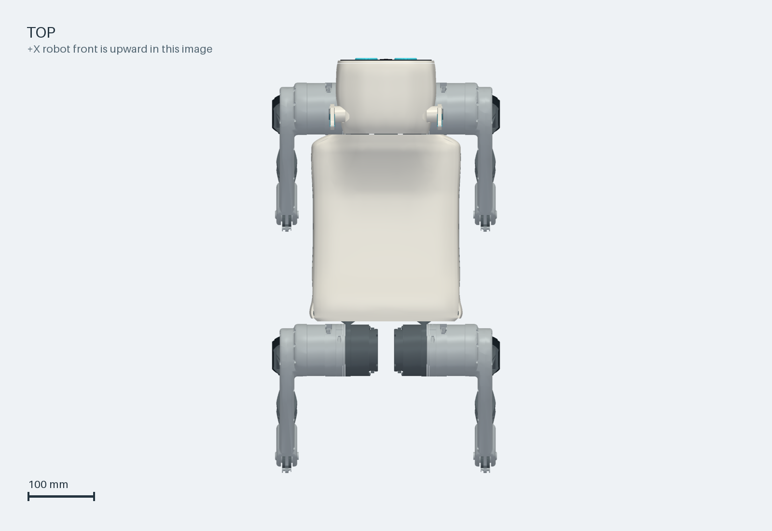
docs/images/top.png
