Kitjesen/orix/design/v67_continuous_head_tail/cad/mount_R_front_upper.step

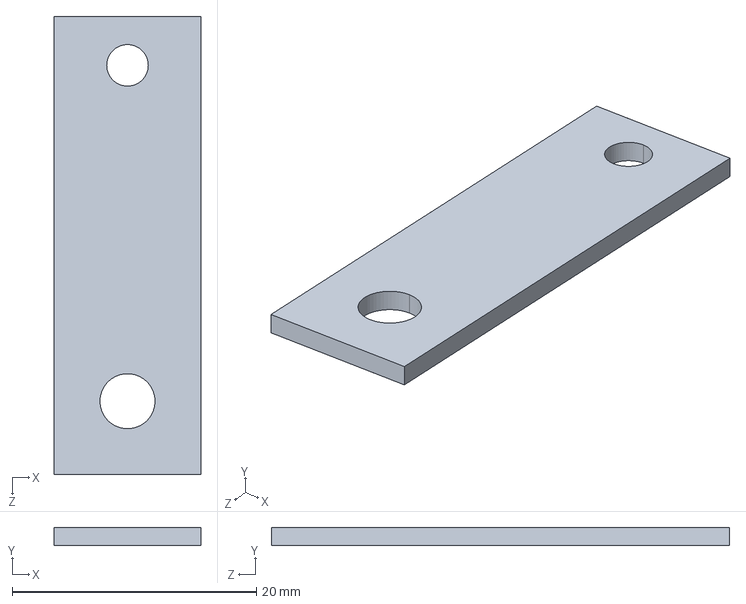
[picture p18: CAD file, 2026-10-15]
design/v67_continuous_head_tail/cad/mount_R_front_upper.step
12.0 x 1.50 x 37.5 mm
