Kitjesen/orix/design/v67_continuous_head_tail/process/upper_split.SLDPRT

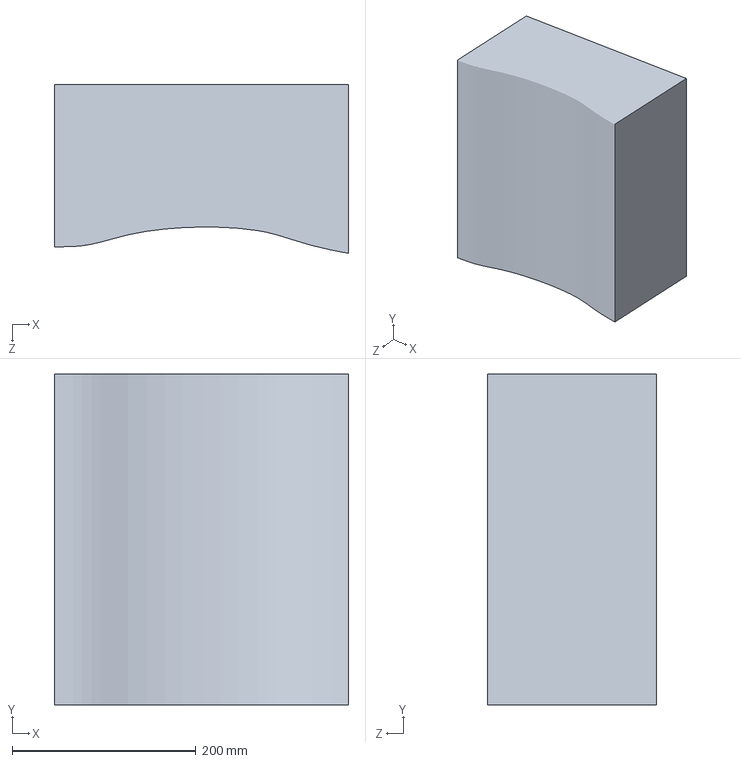
[picture p19: CAD file, 2026-10-15]
design/v67_continuous_head_tail/process/upper_split.SLDPRT
320.0 x 360.0 x 183.6 mm
