Kitjesen/orix/training/v67_cts/assets/smalldog_v67/meshes/collision_ear_right.stl

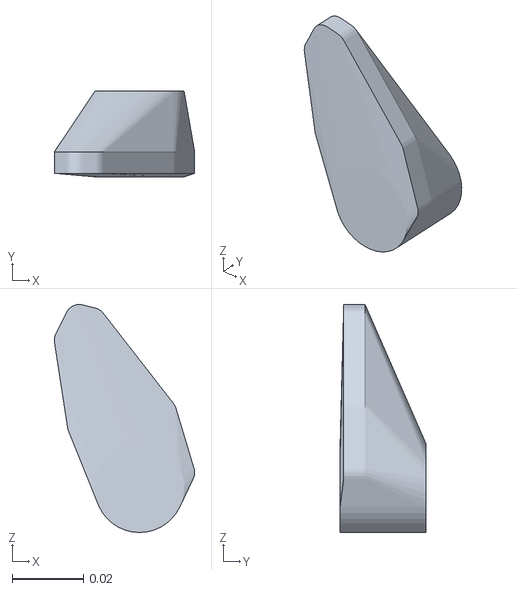
[picture p20: CAD file, 2026-10-15]
training/v67_cts/assets/smalldog_v67/meshes/collision_ear_right.stl
0.0393 x 0.024 x 0.0638
