Kitjesen/orix/training/v67_cts/assets/smalldog_v67/meshes/v67_visual_preview/body_upper.stl

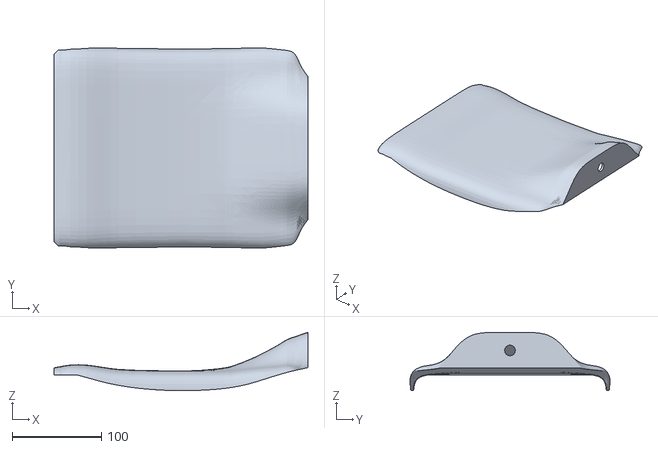
[picture p21: CAD file, 2026-10-15]
training/v67_cts/assets/smalldog_v67/meshes/v67_visual_preview/body_upper.stl
285.0 x 224.6 x 65.4
