Kitjesen/orix/design/v67_continuous_head_tail/meshes/ear_right.stl

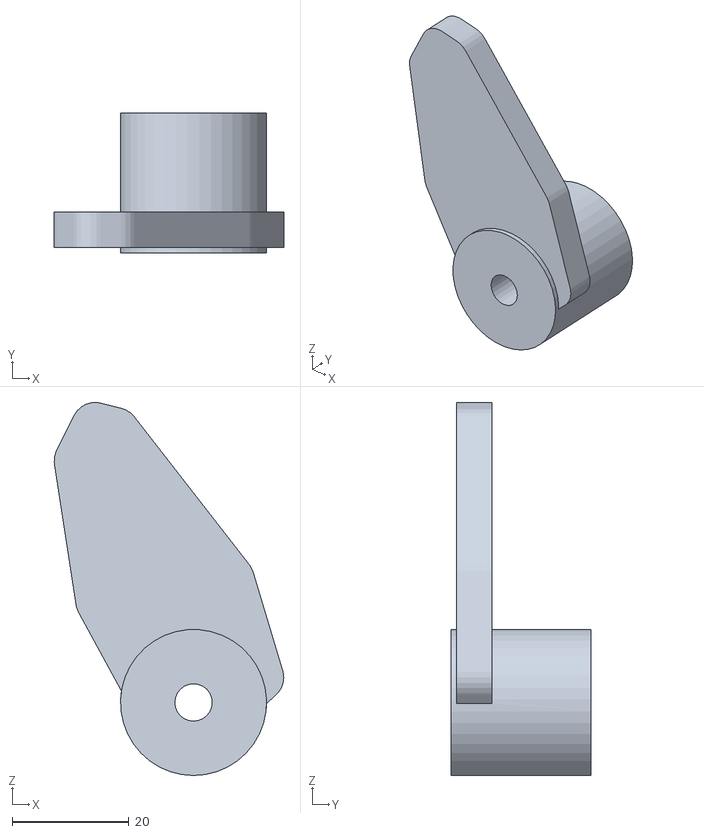
[picture p22: CAD file, 2026-10-15]
design/v67_continuous_head_tail/meshes/ear_right.stl
39.3 x 24.0 x 63.8
