Kitjesen/orix/design/v67_continuous_head_tail/process/head_editable_master.SLDPRT

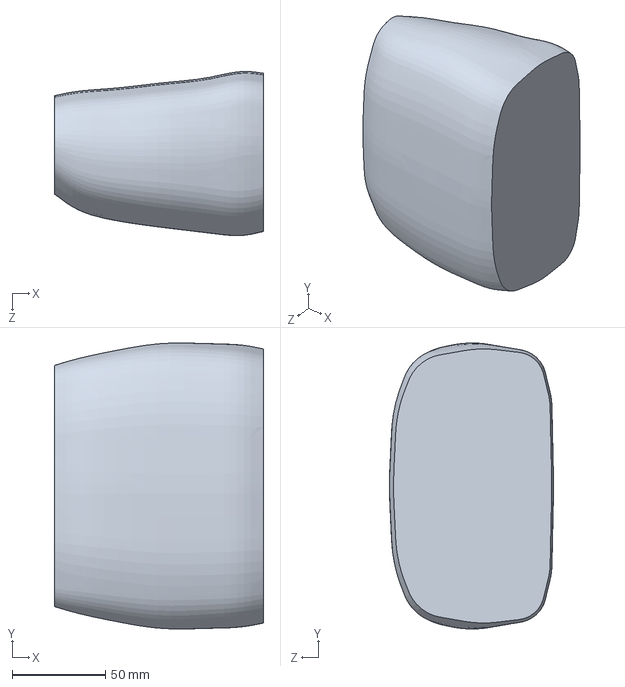
[picture p23: CAD file, 2026-10-15]
design/v67_continuous_head_tail/process/head_editable_master.SLDPRT
112.0 x 153.2 x 87.9 mm
