Kitjesen/orix/training/v67_cts/assets/smalldog_v67/meshes/fr_calf_Link.STL

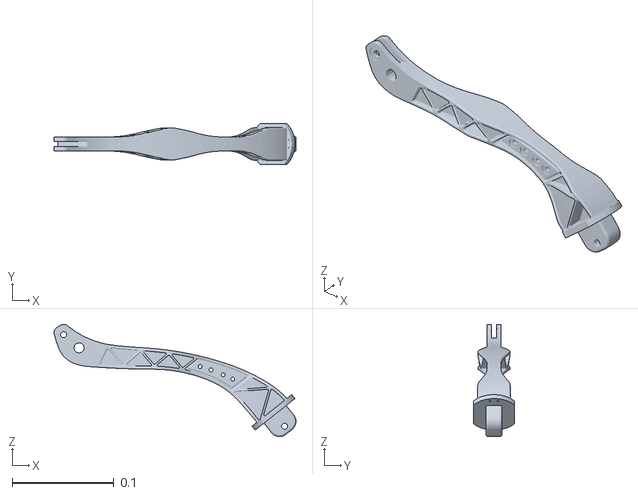
[picture p24: CAD file, 2026-10-15]
training/v67_cts/assets/smalldog_v67/meshes/fr_calf_Link.STL
0.238 x 0.0408 x 0.11
