Kitjesen/orix/training/v67_cts/assets/smalldog_v67/meshes/v67_visual_preview/body_right_paint_lower.stl

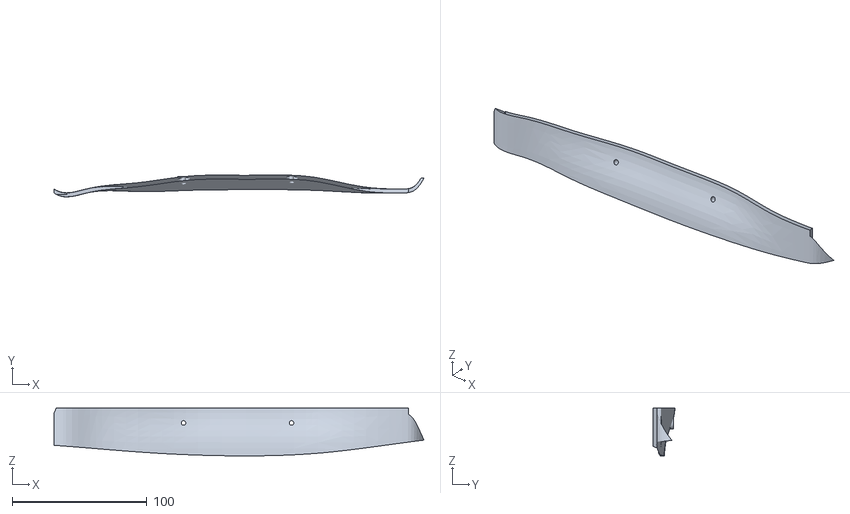
[picture p25: CAD file, 2026-10-15]
training/v67_cts/assets/smalldog_v67/meshes/v67_visual_preview/body_right_paint_lower.stl
274.1 x 16.3 x 35.4
