Kitjesen/orix/design/v67_continuous_head_tail/process/body_editable_master.SLDPRT

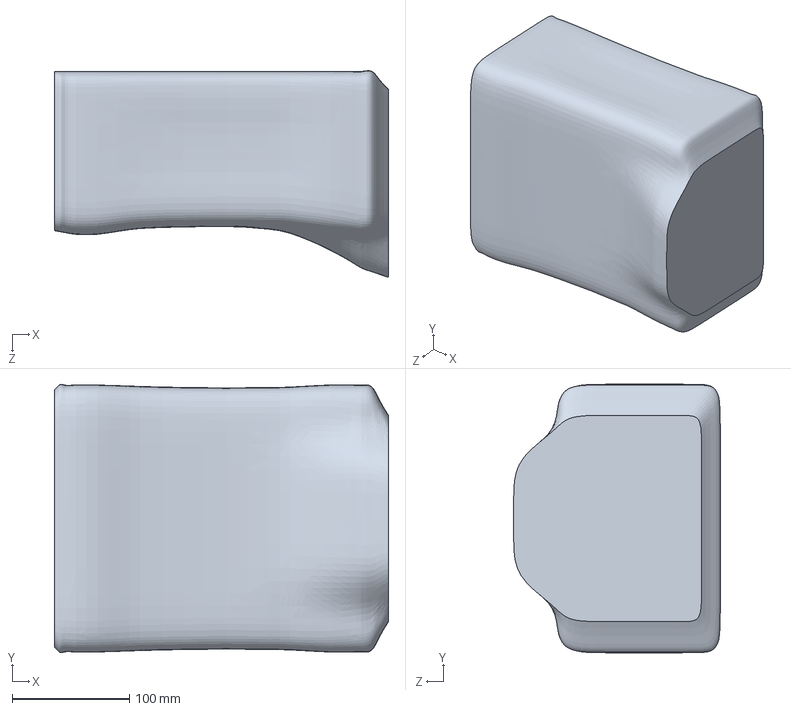
[picture p26: CAD file, 2026-10-15]
design/v67_continuous_head_tail/process/body_editable_master.SLDPRT
285.0 x 229.1 x 176.3 mm
