Kitjesen/orix/training/v67_cts/assets/smalldog_v67/meshes/battery_guide_trial.STL

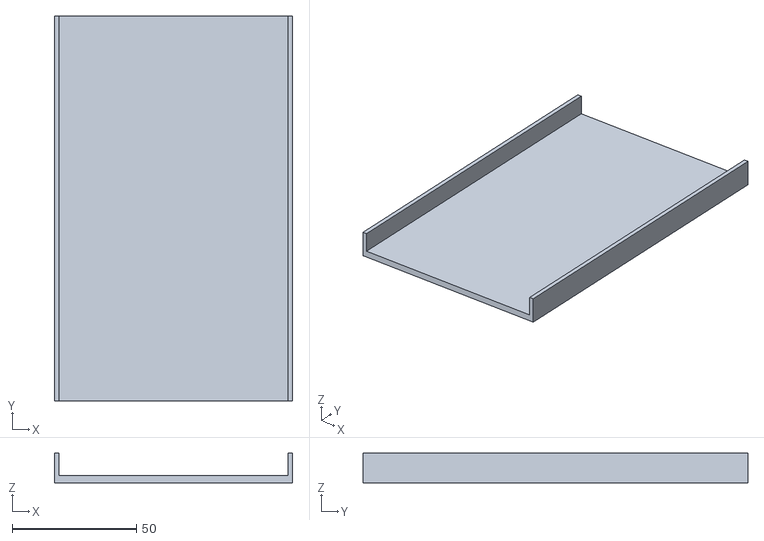
[picture p27: CAD file, 2026-10-15]
training/v67_cts/assets/smalldog_v67/meshes/battery_guide_trial.STL
96.0 x 155.0 x 12.0
