Kitjesen/orix/training/v67_cts/assets/smalldog_v67/meshes/v67_visual_preview/head_face.stl

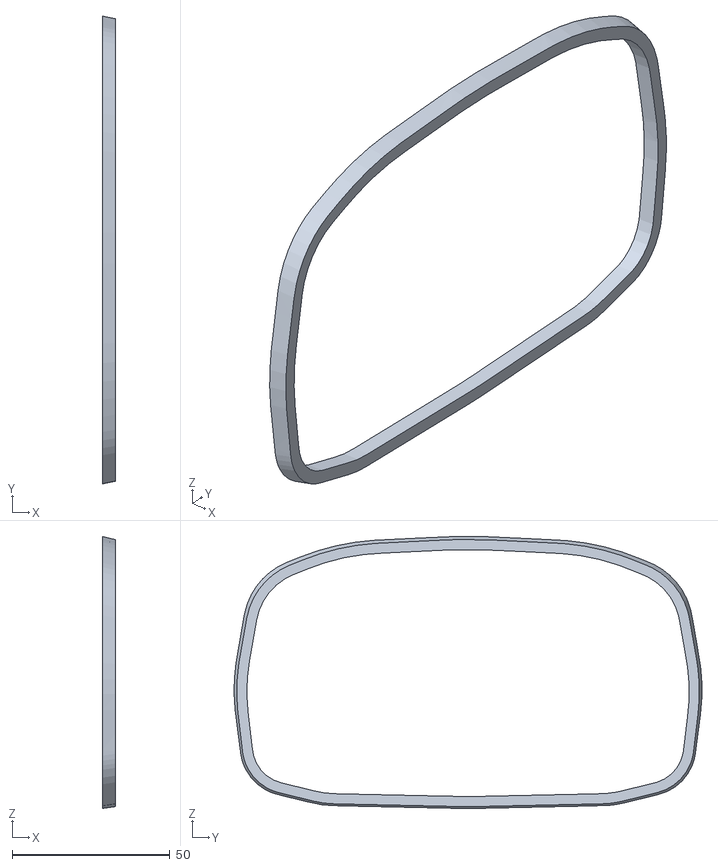
[picture p28: CAD file, 2026-10-15]
training/v67_cts/assets/smalldog_v67/meshes/v67_visual_preview/head_face.stl
4.20 x 148.5 x 86.3
