Kitjesen/orix/design/v67_continuous_head_tail/cad/head_frame_bridge.step

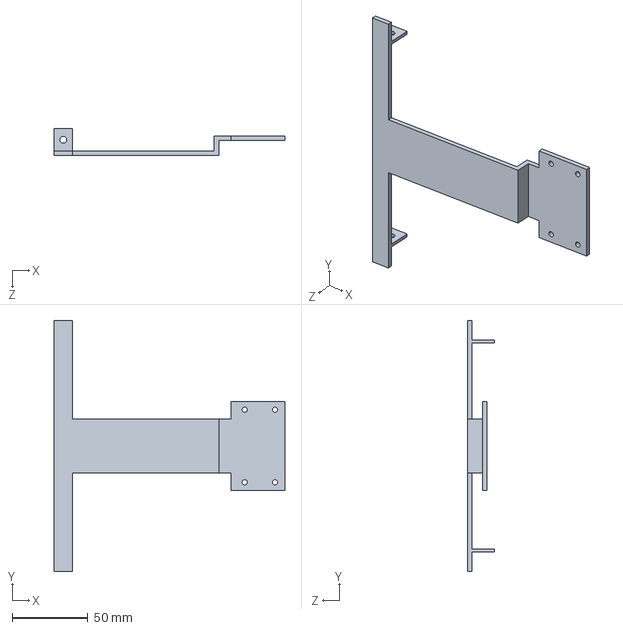
[picture p29: CAD file, 2026-10-15]
design/v67_continuous_head_tail/cad/head_frame_bridge.step
152.5 x 166.0 x 18.0 mm
