Kitjesen/orix/design/v67_continuous_head_tail/meshes/mount_L_rear_upper.stl

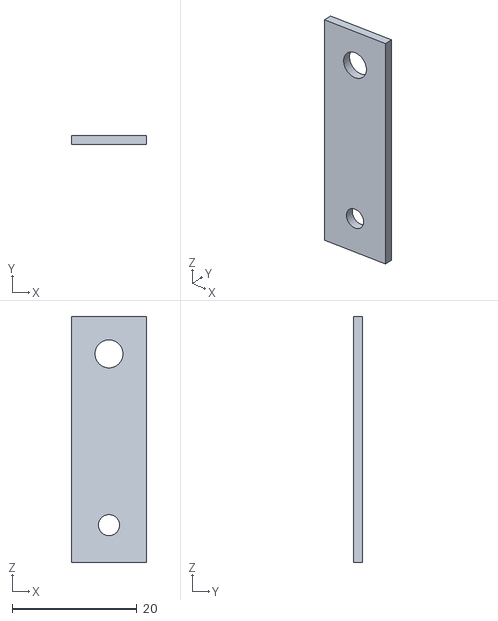
[picture p30: CAD file, 2026-10-15]
design/v67_continuous_head_tail/meshes/mount_L_rear_upper.stl
12.0 x 1.50 x 39.5
