Kitjesen/orix/design/v67_continuous_head_tail/process/head_outer.stl

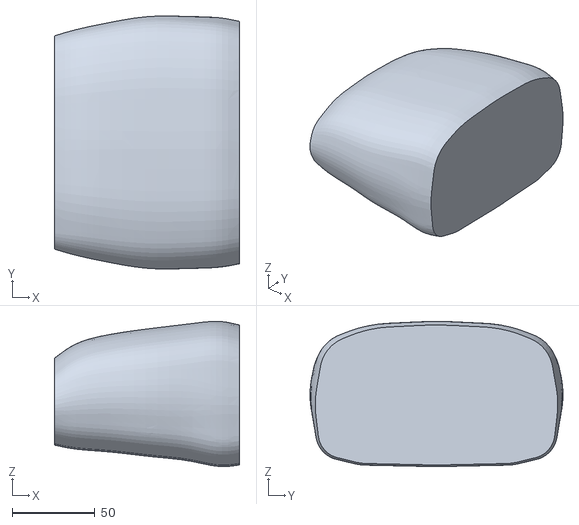
[picture p31: CAD file, 2026-10-15]
design/v67_continuous_head_tail/process/head_outer.stl
112.0 x 153.2 x 87.9
