Kitjesen/orix/training/v67_cts/assets/smalldog_v67/meshes/collision_head.stl

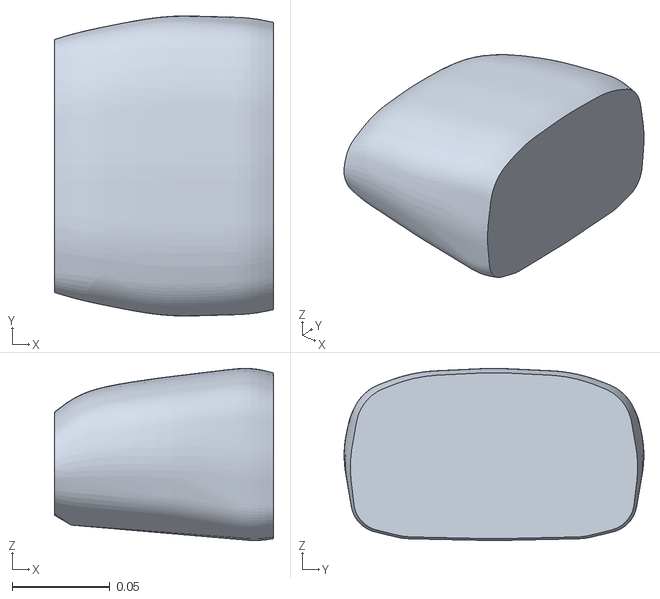
[picture p32: CAD file, 2026-10-15]
training/v67_cts/assets/smalldog_v67/meshes/collision_head.stl
0.112 x 0.153 x 0.0879
