Kitjesen/orix/design/v67_continuous_head_tail/cad/mount_L_rear_lower.step

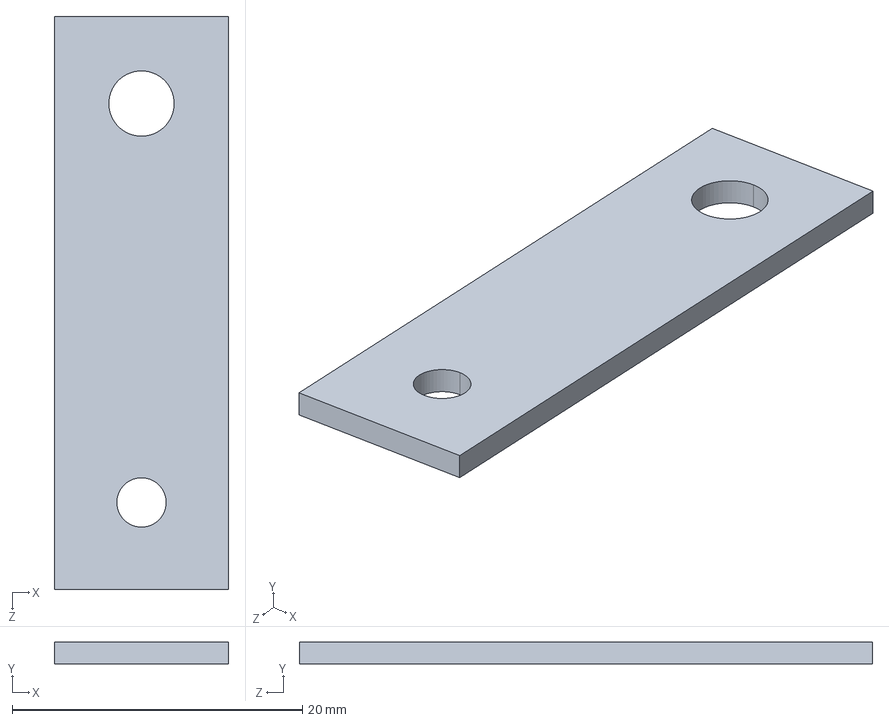
[picture p33: CAD file, 2026-10-15]
design/v67_continuous_head_tail/cad/mount_L_rear_lower.step
12.0 x 1.50 x 39.5 mm
