Kitjesen/orix/training/v67_cts/assets/smalldog_v67/meshes/fl_hip_Link.STL

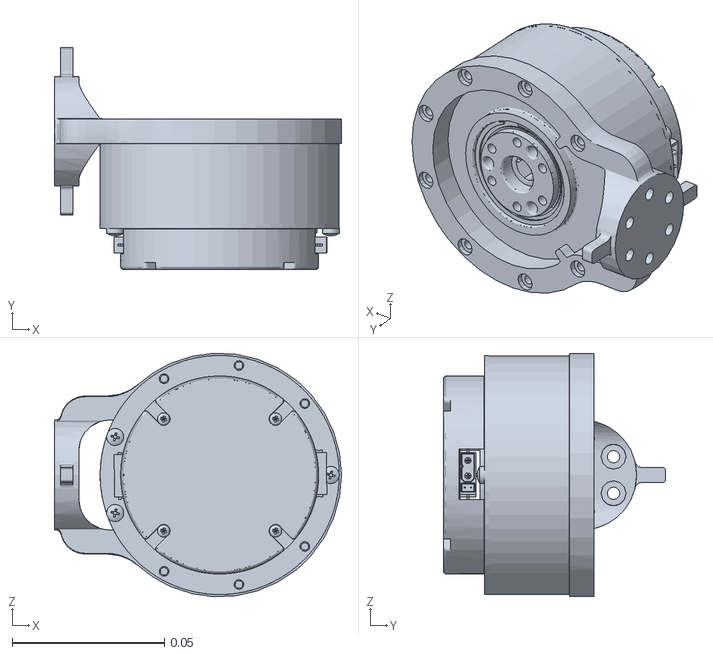
[picture p34: CAD file, 2026-10-15]
training/v67_cts/assets/smalldog_v67/meshes/fl_hip_Link.STL
0.0942 x 0.073 x 0.0799
