Kitjesen/orix/training/v67_cts/assets/smalldog_v67/meshes/v67_visual_preview/graphic_39.stl

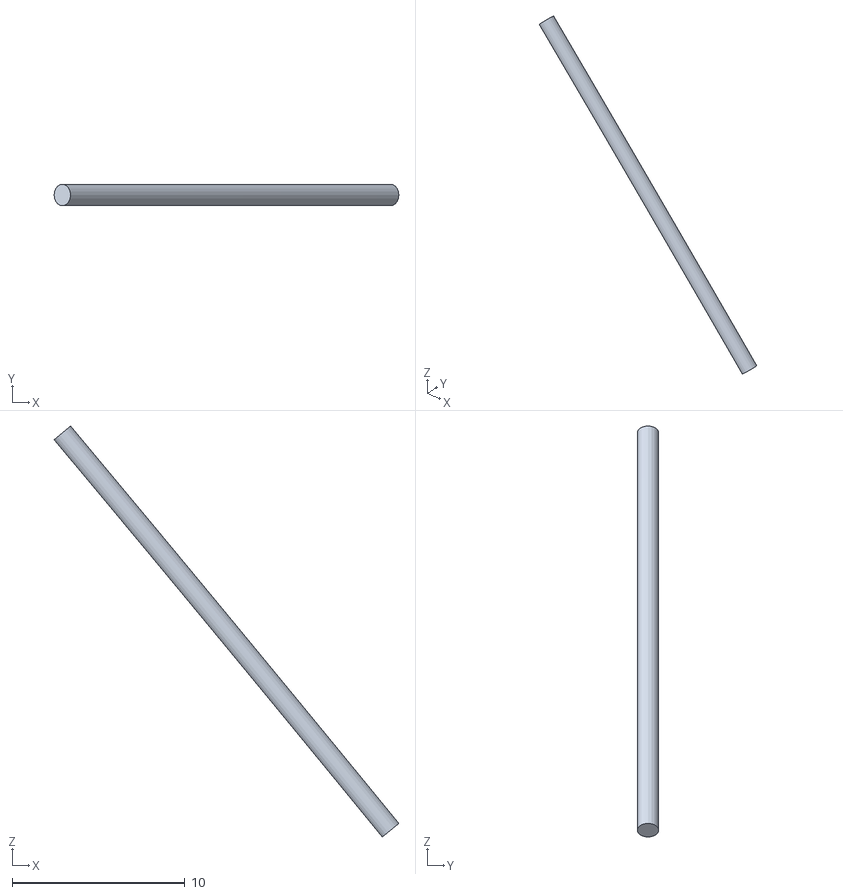
[picture p35: CAD file, 2026-10-15]
training/v67_cts/assets/smalldog_v67/meshes/v67_visual_preview/graphic_39.stl
20.0 x 1.24 x 23.8
