Kitjesen/orix/design/v67_continuous_head_tail/cad/head_upper.step

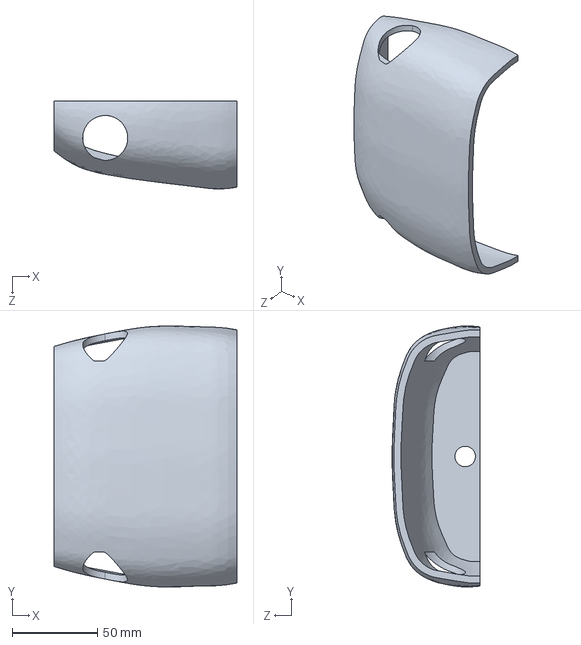
[picture p36: CAD file, 2026-10-15]
design/v67_continuous_head_tail/cad/head_upper.step
107.3 x 153.2 x 51.7 mm
