Kitjesen/orix/training/v67_cts/assets/smalldog_v67/meshes/rr_foot_Link.STL

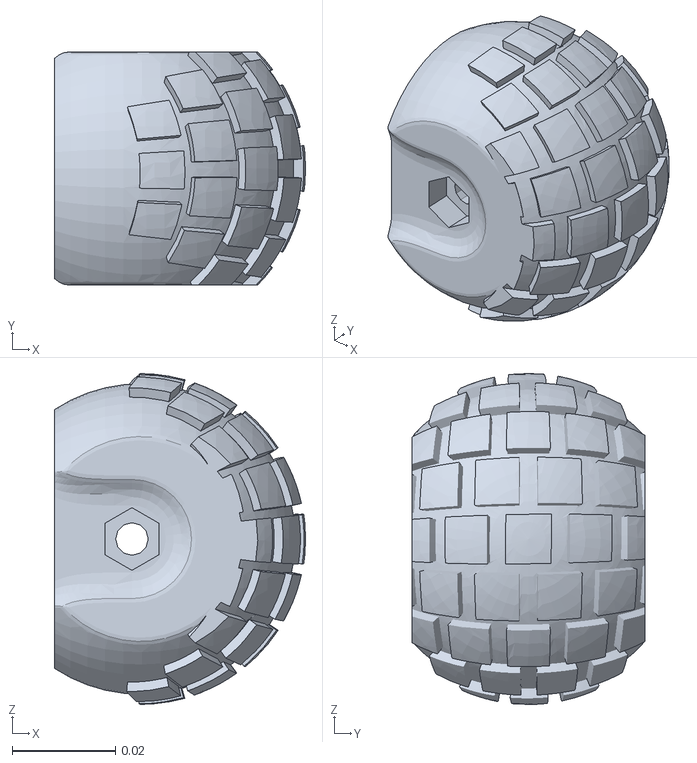
[picture p37: CAD file, 2026-10-15]
training/v67_cts/assets/smalldog_v67/meshes/rr_foot_Link.STL
0.0486 x 0.045 x 0.064
