Kitjesen/orix/training/v67_cts/assets/smalldog_v67/meshes/v67_visual_preview/graphic_45.stl

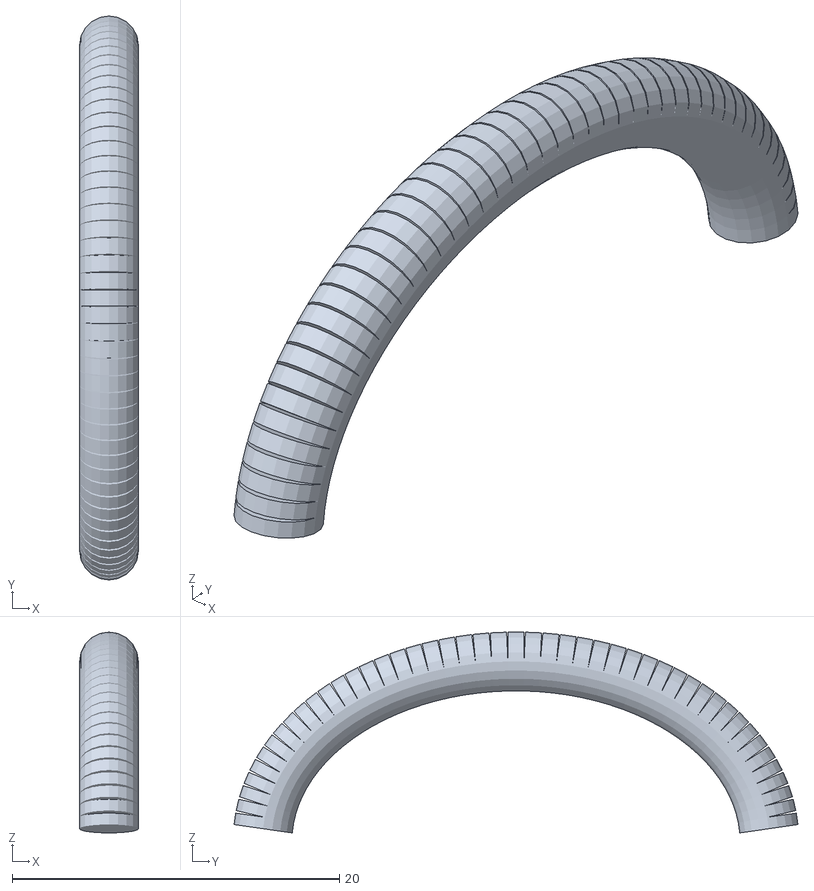
[picture p38: CAD file, 2026-10-15]
training/v67_cts/assets/smalldog_v67/meshes/v67_visual_preview/graphic_45.stl
3.60 x 34.5 x 12.3
