Kitjesen/orix/design/v67_continuous_head_tail/cad/body_front_panel.step

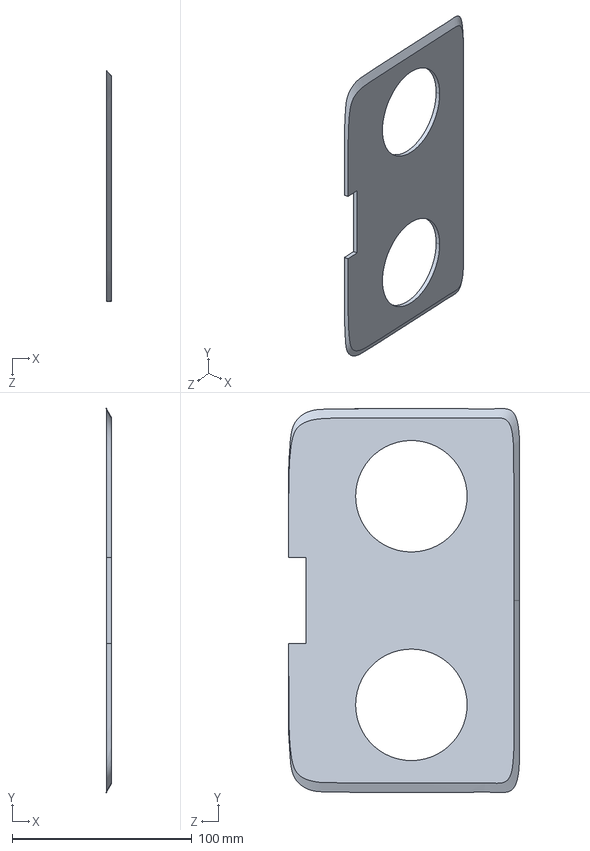
[picture p39: CAD file, 2026-10-15]
design/v67_continuous_head_tail/cad/body_front_panel.step
3.00 x 213.5 x 128.7 mm
