Kitjesen/orix/design/v67_continuous_head_tail/meshes/camera_glass.stl

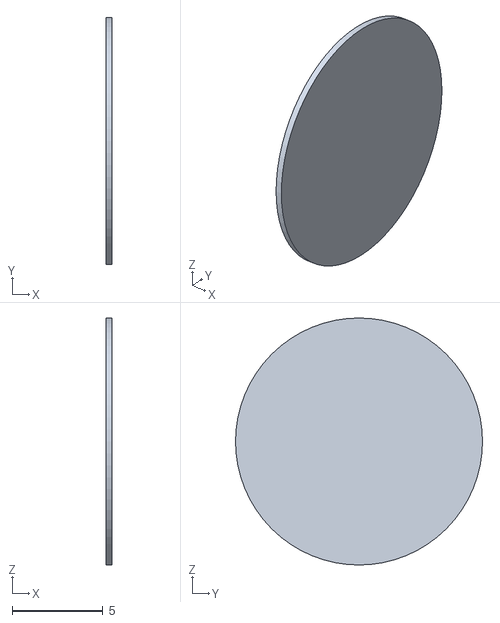
[picture p40: CAD file, 2026-10-15]
design/v67_continuous_head_tail/meshes/camera_glass.stl
0.35 x 13.6 x 13.6
