Kitjesen/orix/training/v67_cts/assets/smalldog_v67/meshes/v67_visual_preview/graphic_41.stl

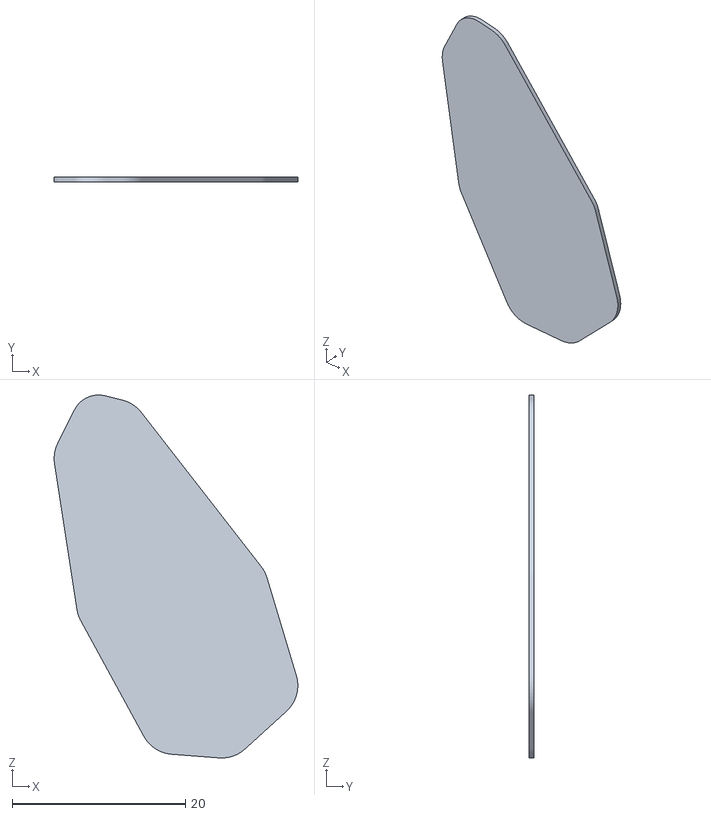
[picture p41: CAD file, 2026-10-15]
training/v67_cts/assets/smalldog_v67/meshes/v67_visual_preview/graphic_41.stl
28.1 x 0.6 x 41.8
