Kitjesen/orix/design/v67_continuous_head_tail/cad/SD-V67_continuous_head_tail.step

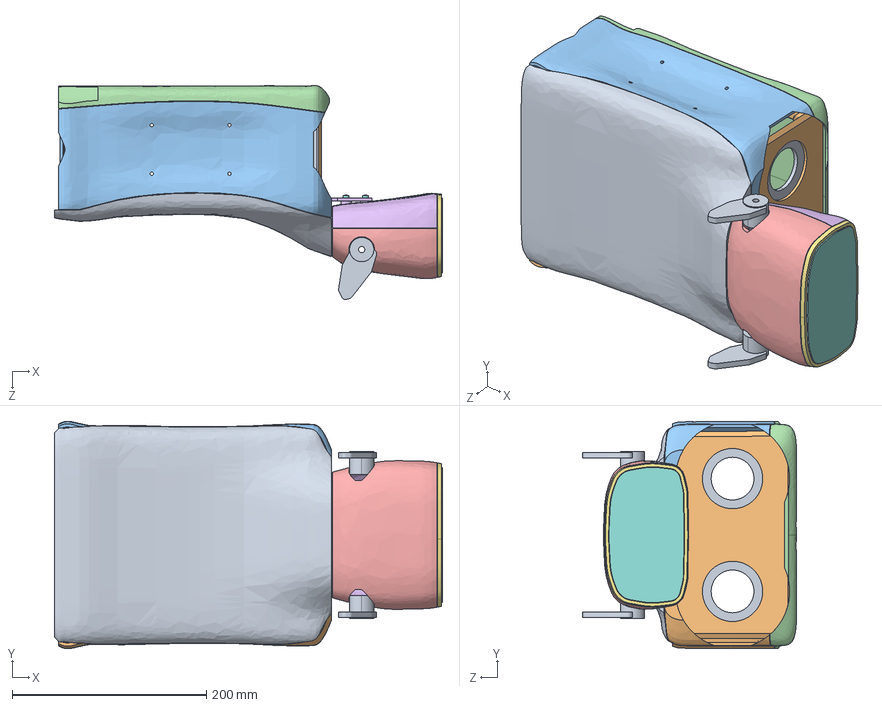
[picture p42: CAD file, 2026-10-15]
design/v67_continuous_head_tail/cad/SD-V67_continuous_head_tail.step
399.1 x 233.8 x 220.1 mm
body_upper
body_right
body_left
body_lower
head_upper
head_lower
head_face
black_visor
ear_right
ear_left
body_front_panel
body_rear_panel
mount_L_rear_lower
mount_L_rear_upper
mount_L_front_lower
mount_L_front_upper
mount_R_rear_lower
mount_R_rear_upper
mount_R_front_lower
mount_R_front_upper
head_frame_bridge
head_screw_M3x20_1
head_nut_M3_envelope_1
head_screw_M3x20_2
head_nut_M3_envelope_2
head_screw_M3x20_3
head_nut_M3_envelope_3
head_screw_M3x20_4
head_nut_M3_envelope_4
frame_reference
