Kitjesen/orix/design/v67_continuous_head_tail/meshes/head_lower.stl

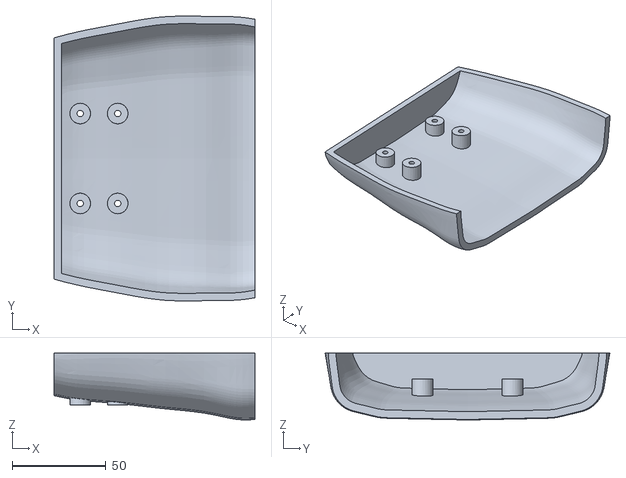
[picture p43: CAD file, 2026-10-15]
design/v67_continuous_head_tail/meshes/head_lower.stl
107.3 x 152.1 x 35.7
