Kitjesen/orix/design/v67_continuous_head_tail/meshes/body_rear_panel.stl

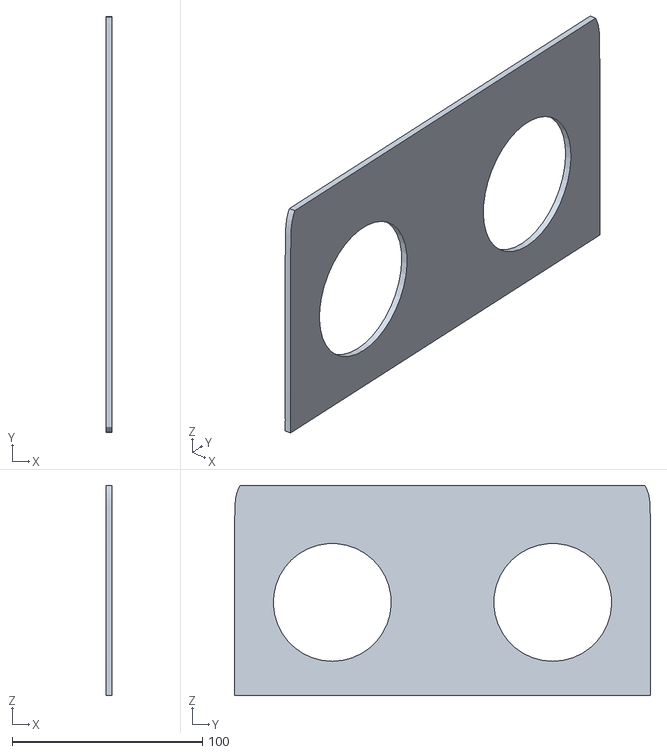
[picture p44: CAD file, 2026-10-15]
design/v67_continuous_head_tail/meshes/body_rear_panel.stl
3.00 x 219.0 x 110.5
