Kitjesen/orix/training/v67_cts/assets/smalldog_v67/meshes/fr_thigh_Link.STL

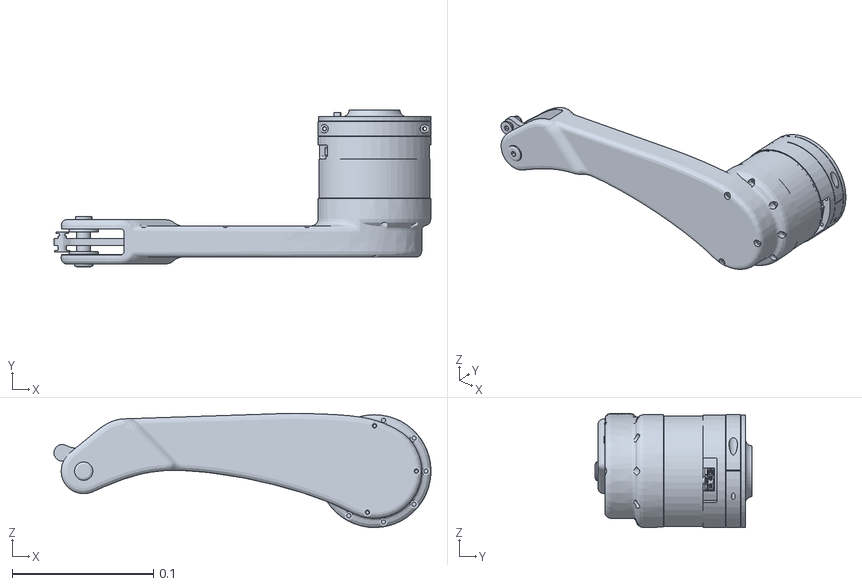
[picture p45: CAD file, 2026-10-15]
training/v67_cts/assets/smalldog_v67/meshes/fr_thigh_Link.STL
0.267 x 0.111 x 0.0809
