Kitjesen/orix/design/v67_continuous_head_tail/cad/body_left.step

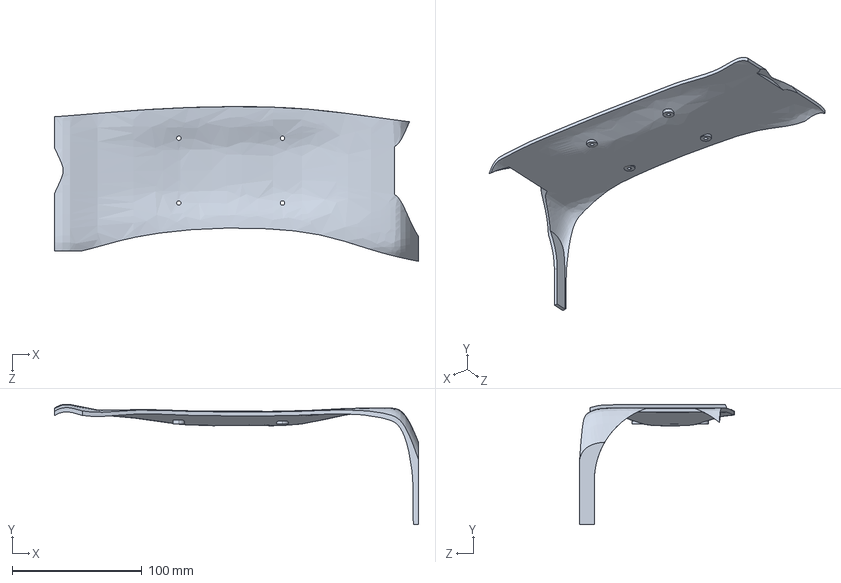
[picture p46: CAD file, 2026-10-15]
design/v67_continuous_head_tail/cad/body_left.step
281.0 x 92.8 x 119.5 mm
