Kitjesen/orix/design/v67_continuous_head_tail/cad/body_upper.step

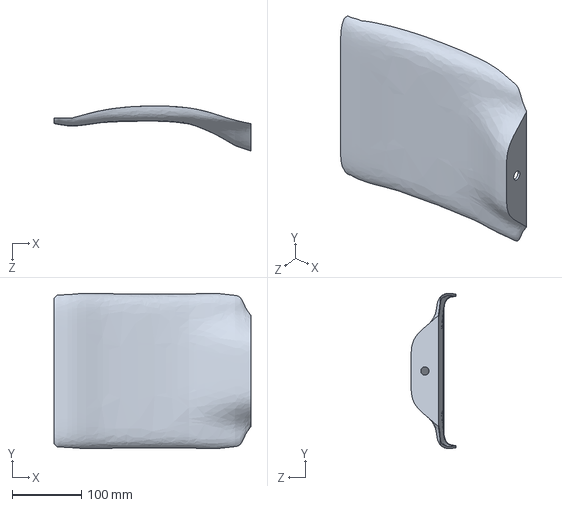
[picture p47: CAD file, 2026-10-15]
design/v67_continuous_head_tail/cad/body_upper.step
285.0 x 224.6 x 65.4 mm
