Kitjesen/orix/design/v67_continuous_head_tail/cad/frame_reference.SLDPRT

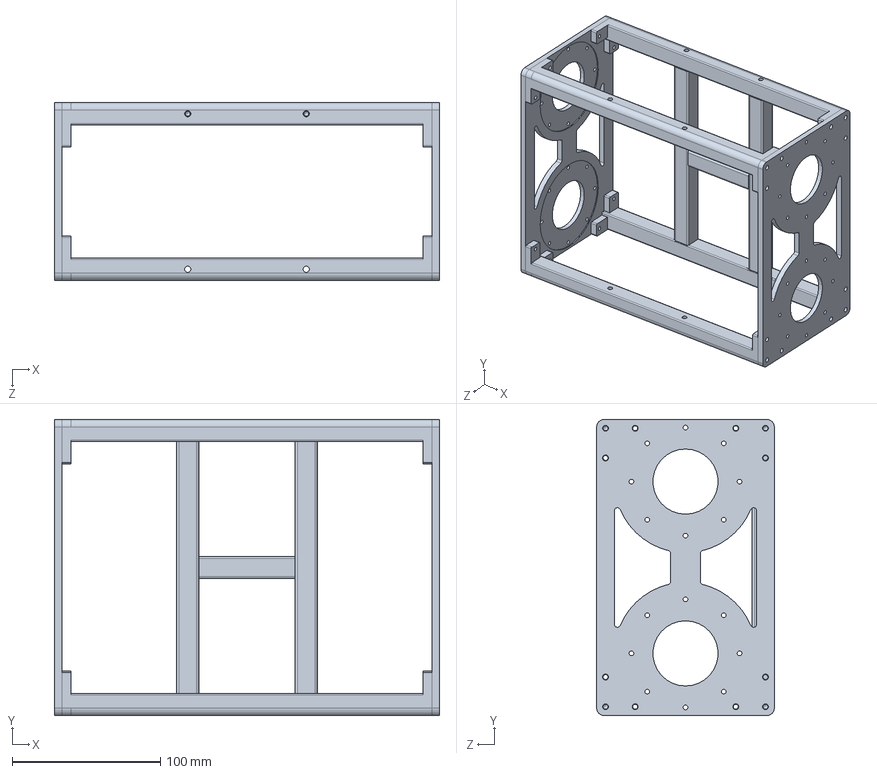
[picture p48: CAD file, 2026-10-15]
design/v67_continuous_head_tail/cad/frame_reference.SLDPRT
260.0 x 200.0 x 120.0 mm
