Kitjesen/orix/design/v67_continuous_head_tail/meshes/black_visor.stl

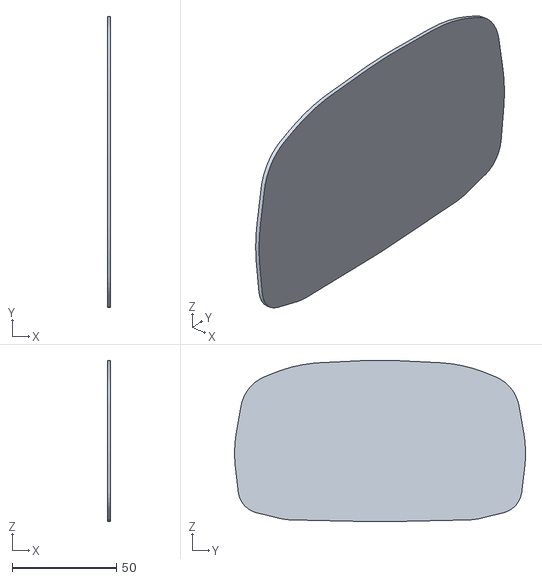
[picture p49: CAD file, 2026-10-15]
design/v67_continuous_head_tail/meshes/black_visor.stl
1.50 x 139.3 x 77.3
