Kitjesen/orix/design/v67_continuous_head_tail/cad/body_lower.step

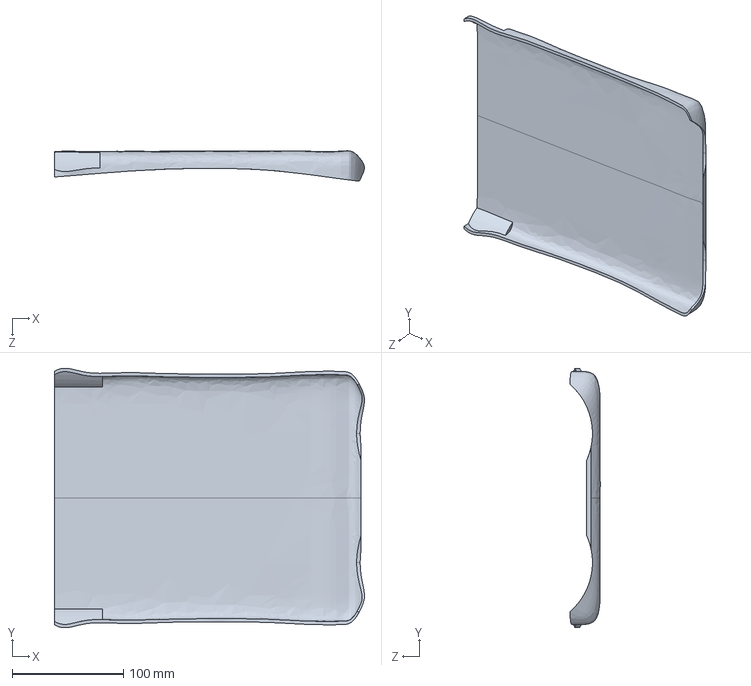
[picture p50: CAD file, 2026-10-15]
design/v67_continuous_head_tail/cad/body_lower.step
279.0 x 233.6 x 27.5 mm
