Kitjesen/orix/training/v67_cts/assets/smalldog_v67/meshes/base_link.STL

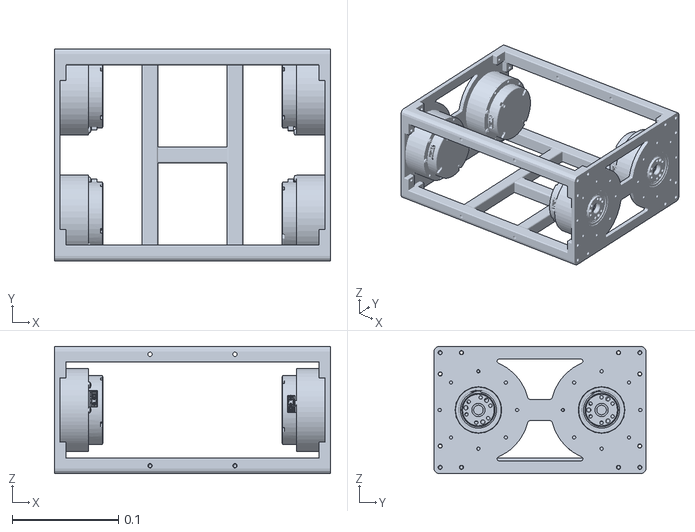
[picture p51: CAD file, 2026-10-15]
training/v67_cts/assets/smalldog_v67/meshes/base_link.STL
0.26 x 0.2 x 0.12
