Kitjesen/orix/design/v67_continuous_head_tail/meshes/camera_bezel.stl

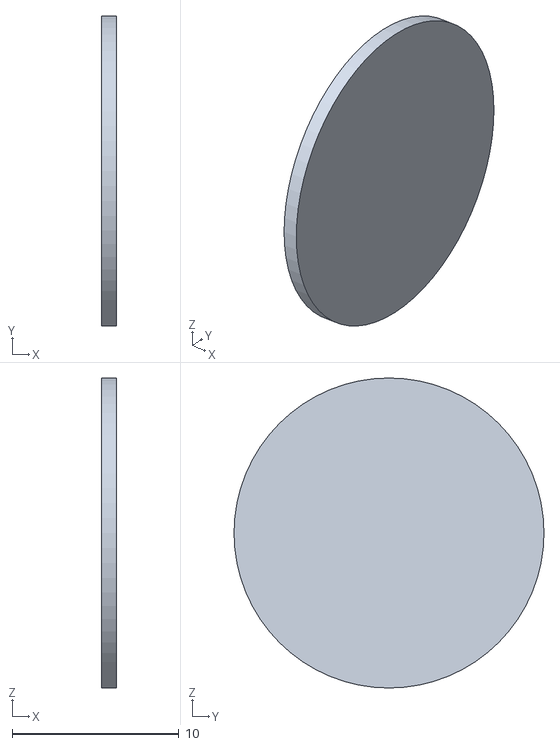
[picture p52: CAD file, 2026-10-15]
design/v67_continuous_head_tail/meshes/camera_bezel.stl
0.9 x 18.6 x 18.6
