Kitjesen/orix/training/v67_cts/assets/smalldog_v67/meshes/collision_upper.stl

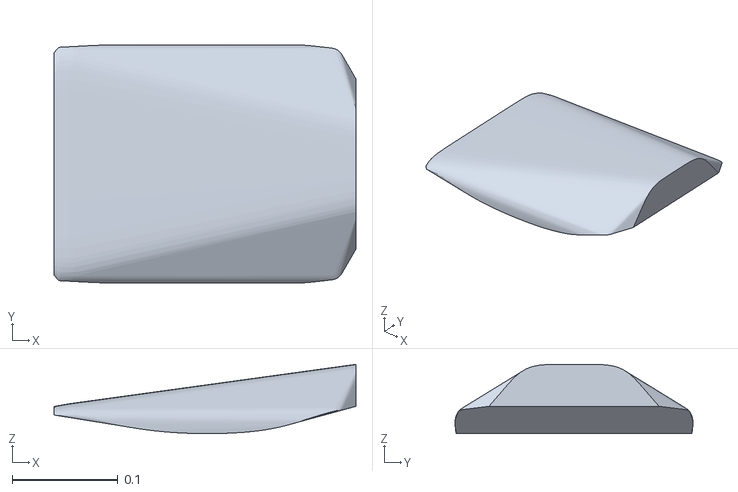
[picture p53: CAD file, 2026-10-15]
training/v67_cts/assets/smalldog_v67/meshes/collision_upper.stl
0.285 x 0.225 x 0.0654
