Kitjesen/orix/training/v67_cts/assets/smalldog_v67/meshes/v67_visual_preview/camera_pupil.stl

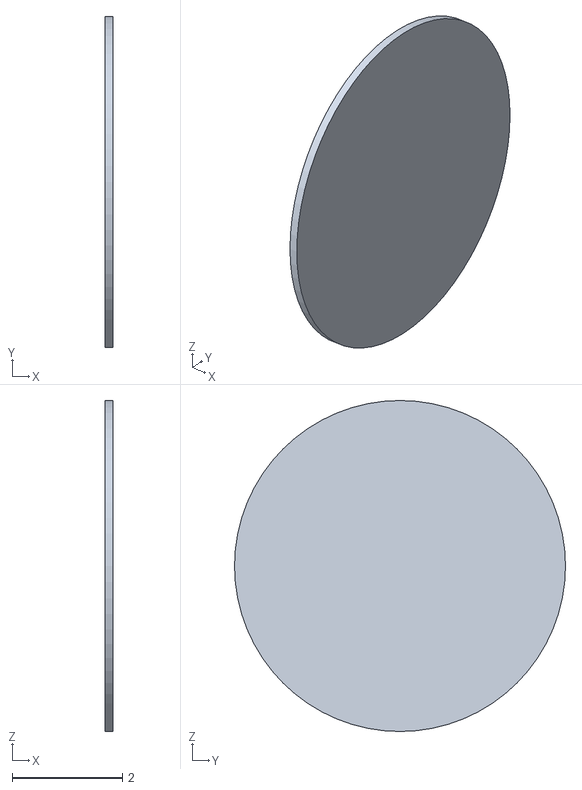
[picture p54: CAD file, 2026-10-15]
training/v67_cts/assets/smalldog_v67/meshes/v67_visual_preview/camera_pupil.stl
0.15 x 6.00 x 6.00
