Kitjesen/orix/training/v67_cts/assets/smalldog_v67/meshes/v67_visual_preview/ear_hub_cap_left.stl

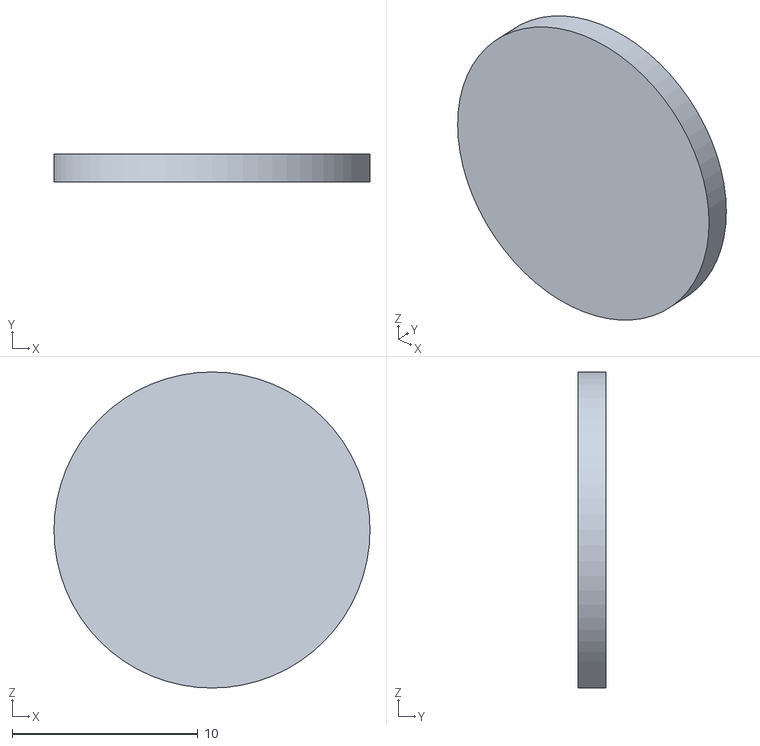
[picture p55: CAD file, 2026-10-15]
training/v67_cts/assets/smalldog_v67/meshes/v67_visual_preview/ear_hub_cap_left.stl
17.0 x 1.50 x 17.0
