Kitjesen/orix/training/v67_cts/assets/smalldog_v67/meshes/v67_visual_preview/graphic_46.stl

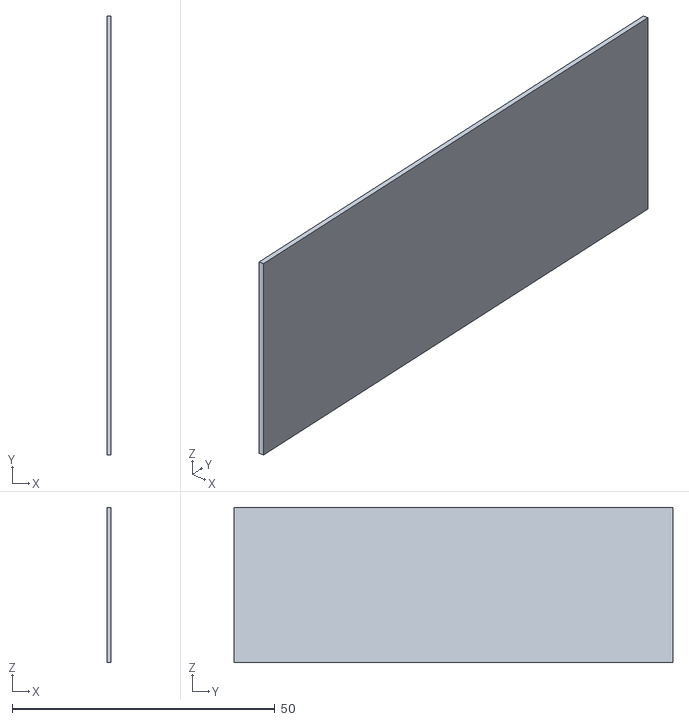
[picture p56: CAD file, 2026-10-15]
training/v67_cts/assets/smalldog_v67/meshes/v67_visual_preview/graphic_46.stl
0.75 x 83.6 x 29.6
