Kitjesen/orix/training/v67_cts/assets/smalldog_v67/meshes/v67_visual_preview/body_left_paint_upper.stl

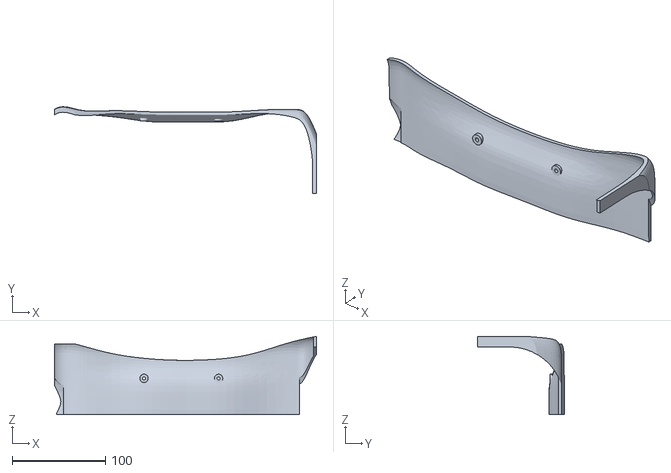
[picture p57: CAD file, 2026-10-15]
training/v67_cts/assets/smalldog_v67/meshes/v67_visual_preview/body_left_paint_upper.stl
281.0 x 92.9 x 84.1
