Kitjesen/orix/(list of files, cad)

Other CAD files:
design/v67_continuous_head_tail/meshes/mount_R_rear_upper.stl
training/v67_cts/assets/smalldog_v67/meshes/rl_calf_Link.STL
training/v67_cts/assets/smalldog_v67/meshes/v67_visual_preview/mount_R_rear_lower.stl
design/v67_continuous_head_tail/cad/mount_L_front_lower.step
design/v67_continuous_head_tail/meshes/ear_left.stl
design/v67_continuous_head_tail/meshes/mount_L_rear_lower.stl
training/v67_cts/assets/smalldog_v67/meshes/fr_foot_Link.STL
training/v67_cts/assets/smalldog_v67/meshes/fl_foot_Link.STL
design/v67_continuous_head_tail/cad/head_lower.step
design/v67_continuous_head_tail/meshes/mount_L_front_upper.stl
training/v67_cts/assets/smalldog_v67/meshes/rr_hip_Link.STL
training/v67_cts/assets/smalldog_v67/meshes/v67_visual_preview/mount_R_front_lower.stl
training/v67_cts/assets/smalldog_v67/meshes/rl_hip_Link.STL
design/v67_continuous_head_tail/meshes/body_right.stl
training/v67_cts/assets/smalldog_v67/meshes/rr_thigh_Link.STL
training/v67_cts/assets/smalldog_v67/meshes/v67_visual_preview/graphic_40.stl
design/v67_continuous_head_tail/cad/mount_R_rear_lower.step
training/v67_cts/assets/smalldog_v67/meshes/rl_thigh_Link.STL
training/v67_cts/assets/smalldog_v67/meshes/v67_visual_preview/graphic_36.stl
design/v67_continuous_head_tail/meshes/body_left.stl
training/v67_cts/assets/smalldog_v67/meshes/rr_calf_Link.STL
training/v67_cts/assets/smalldog_v67/meshes/v67_visual_preview/graphic_43.stl
design/v67_continuous_head_tail/cad/mount_L_rear_upper.step
training/v67_cts/assets/smalldog_v67/meshes/v67_visual_preview/body_left_paint_lower.stl
design/v67_continuous_head_tail/cad/ear_right.step
training/v67_cts/assets/smalldog_v67/meshes/collision_ear_left.stl
training/v67_cts/assets/smalldog_v67/meshes/v67_visual_preview/mount_L_front_upper.stl
training/v67_cts/assets/smalldog_v67/meshes/rl_foot_Link.STL
training/v67_cts/assets/smalldog_v67/meshes/v67_visual_preview/graphic_42.stl
design/v67_continuous_head_tail/cad/body_right.step
design/v67_continuous_head_tail/meshes/body_lower.stl
training/v67_cts/assets/smalldog_v67/meshes/fl_thigh_Link.STL
training/v67_cts/assets/smalldog_v67/meshes/v67_visual_preview/mount_L_front_lower.stl
design/v67_continuous_head_tail/cad/black_visor.step
design/v67_continuous_head_tail/meshes/mount_L_front_lower.stl
training/v67_cts/assets/smalldog_v67/meshes/fl_calf_Link.STL
design/v67_continuous_head_tail/cad/head_face.step
training/v67_cts/assets/smalldog_v67/meshes/fr_hip_Link.STL
training/v67_cts/assets/smalldog_v67/meshes/v67_visual_preview/ear_left.stl
design/v67_continuous_head_tail/cad/mount_R_rear_upper.step
design/v67_continuous_head_tail/meshes/mount_R_front_lower.stl
design/v67_continuous_head_tail/cad/mount_R_front_lower.step
design/v67_continuous_head_tail/meshes/head_upper.stl
design/v67_continuous_head_tail/cad/ear_left.step
design/v67_continuous_head_tail/meshes/mount_R_front_upper.stl
design/v67_continuous_head_tail/cad/mount_L_front_upper.step
training/v67_cts/assets/smalldog_v67/meshes/v67_visual_preview/ear_hub_cap_right.stl
design/v67_continuous_head_tail/cad/body_rear_panel.step
design/v67_continuous_head_tail/meshes/body_front_panel.stl
training/v67_cts/assets/smalldog_v67/meshes/v67_visual_preview/mount_R_rear_upper.stl
design/v67_continuous_head_tail/meshes/head_frame_bridge.stl
training/v67_cts/assets/smalldog_v67/meshes/v67_visual_preview/mount_L_rear_lower.stl
design/v67_continuous_head_tail/meshes/mount_R_rear_lower.stl
training/v67_cts/assets/smalldog_v67/meshes/v67_visual_preview/head_upper.stl
training/v67_cts/assets/smalldog_v67/meshes/v67_visual_preview/body_front_panel.stl
design/v67_continuous_head_tail/meshes/ear_hub_cap_right.stl
training/v67_cts/assets/smalldog_v67/meshes/v67_visual_preview/graphic_38.stl
training/v67_cts/assets/smalldog_v67/meshes/v67_visual_preview/body_lower.stl
training/v67_cts/assets/smalldog_v67/meshes/v67_visual_preview/head_frame_bridge.stl
training/v67_cts/assets/smalldog_v67/meshes/v67_visual_preview/body_right_paint_upper.stl
training/v67_cts/assets/smalldog_v67/meshes/v67_visual_preview/mount_R_front_upper.stl
training/v67_cts/assets/smalldog_v67/meshes/v67_visual_preview/graphic_37.stl
training/v67_cts/assets/smalldog_v67/meshes/v67_visual_preview/graphic_44.stl
design/v67_continuous_head_tail/cad/SD-V67_continuous_head_tail.SLDASM
design/v67_continuous_head_tail/cad/black_visor.SLDPRT
design/v67_continuous_head_tail/cad/body_front_panel.SLDPRT
design/v67_continuous_head_tail/cad/body_left.SLDPRT
design/v67_continuous_head_tail/cad/body_lower.SLDPRT
design/v67_continuous_head_tail/cad/body_rear_panel.SLDPRT
design/v67_continuous_head_tail/cad/body_right.SLDPRT
design/v67_continuous_head_tail/cad/body_upper.SLDPRT
design/v67_continuous_head_tail/cad/ear_left.SLDPRT
design/v67_continuous_head_tail/cad/ear_right.SLDPRT
design/v67_continuous_head_tail/cad/head_face.SLDPRT
design/v67_continuous_head_tail/cad/head_frame_bridge.SLDPRT
design/v67_continuous_head_tail/cad/head_lower.SLDPRT
design/v67_continuous_head_tail/cad/head_nut_M3_envelope_1.SLDPRT
design/v67_continuous_head_tail/cad/head_nut_M3_envelope_1.step
design/v67_continuous_head_tail/cad/head_nut_M3_envelope_2.SLDPRT
design/v67_continuous_head_tail/cad/head_nut_M3_envelope_2.step
design/v67_continuous_head_tail/cad/head_nut_M3_envelope_3.SLDPRT
design/v67_continuous_head_tail/cad/head_nut_M3_envelope_3.step
design/v67_continuous_head_tail/cad/head_nut_M3_envelope_4.SLDPRT
design/v67_continuous_head_tail/cad/head_nut_M3_envelope_4.step
design/v67_continuous_head_tail/cad/head_screw_M3x20_1.SLDPRT
design/v67_continuous_head_tail/cad/head_screw_M3x20_1.step
design/v67_continuous_head_tail/cad/head_screw_M3x20_2.SLDPRT
design/v67_continuous_head_tail/cad/head_screw_M3x20_2.step
design/v67_continuous_head_tail/cad/head_screw_M3x20_3.SLDPRT
design/v67_continuous_head_tail/cad/head_screw_M3x20_3.step
design/v67_continuous_head_tail/cad/head_screw_M3x20_4.SLDPRT
design/v67_continuous_head_tail/cad/head_screw_M3x20_4.step
design/v67_continuous_head_tail/cad/head_upper.SLDPRT
design/v67_continuous_head_tail/cad/mount_L_front_lower.SLDPRT
design/v67_continuous_head_tail/cad/mount_L_front_upper.SLDPRT
design/v67_continuous_head_tail/cad/mount_L_rear_lower.SLDPRT
design/v67_continuous_head_tail/cad/mount_L_rear_upper.SLDPRT
design/v67_continuous_head_tail/cad/mount_R_front_lower.SLDPRT
design/v67_continuous_head_tail/cad/mount_R_front_upper.SLDPRT
design/v67_continuous_head_tail/cad/mount_R_rear_lower.SLDPRT
design/v67_continuous_head_tail/cad/mount_R_rear_upper.SLDPRT
design/v67_continuous_head_tail/meshes/head_nut_M3_envelope_1.stl
design/v67_continuous_head_tail/meshes/head_nut_M3_envelope_2.stl
design/v67_continuous_head_tail/meshes/head_nut_M3_envelope_3.stl
design/v67_continuous_head_tail/meshes/head_nut_M3_envelope_4.stl
design/v67_continuous_head_tail/meshes/head_screw_M3x20_1.stl
design/v67_continuous_head_tail/meshes/head_screw_M3x20_2.stl
design/v67_continuous_head_tail/meshes/head_screw_M3x20_3.stl
design/v67_continuous_head_tail/meshes/head_screw_M3x20_4.stl
training/v67_cts/assets/smalldog_v67/meshes/v67_visual_preview/head_nut_M3_envelope_1.stl
training/v67_cts/assets/smalldog_v67/meshes/v67_visual_preview/head_nut_M3_envelope_2.stl
training/v67_cts/assets/smalldog_v67/meshes/v67_visual_preview/head_nut_M3_envelope_3.stl
training/v67_cts/assets/smalldog_v67/meshes/v67_visual_preview/head_nut_M3_envelope_4.stl
training/v67_cts/assets/smalldog_v67/meshes/v67_visual_preview/head_screw_M3x20_1.stl
training/v67_cts/assets/smalldog_v67/meshes/v67_visual_preview/head_screw_M3x20_2.stl
training/v67_cts/assets/smalldog_v67/meshes/v67_visual_preview/head_screw_M3x20_3.stl
training/v67_cts/assets/smalldog_v67/meshes/v67_visual_preview/head_screw_M3x20_4.stl
