Kitjesen/orix/training/v67_cts/R5_TERRAIN_RESULTS_20261015.md

# SmallDog R5 多地形训练完成记录

核验时间：2026-10-15 19:09，北京时间。

## 完成状态

- 最终模型 `model_12796.pt`，全局迭代编号 12796。
- 性能修复后从 model_10100 恢复，追加 2697 次学习更新，训练日志累计 02:27:25。
- 驱动于北京时间 15:36:23 完成三个速度的独立评估后退出，当前状态 complete，无训练进程继续运行。
- 4096 环境，RoughRefinedGait 八类地形，8 专家 MoE-CTS。
- 训练最终平均 terrain level 3.8919，速度课程上限 1.0 m/s。
- 最后 20 轮平均每轮 3.1965 秒，采样 3.0146 秒、网络更新 0.1829 秒。
- 1.5 / 2.0 m/s 提速为已确认的后续安排，尚未启动该阶段。

## 独立学生策略评估

每档 80 环境、10 秒，初始地形等级 0～3，八类地形；速度与姿态统计排除前 2 秒。三个测试均无终止，因此姿态统计包含全部 80 环境。

| 命令 m/s | 实测均速 m/s | 平均绝对速度误差 m/s | 终止次数 | 俯仰 RMS ° |
|---:|---:|---:|---:|---:|
| 0.3 | 0.29602 | 0.01387 | 0 | 1.475 |
| 0.6 | 0.58837 | 0.02204 | 0 | 2.015 |
| 1.0 | 0.99140 | 0.03332 | 0 | 1.726 |

这组短时采样不代表最高地形等级全部通过。训练日志中 3.8919 是并行环境的平均等级，不是独立评估的初始等级。

1.0 m/s 下上台阶组均速 0.96616 m/s、平均绝对误差 0.06672 m/s，为当前速度跟踪较弱的地形组。俯仰 RMS 1.726°、横滚 RMS 1.355°，存在较大瞬时角度。目标裁剪最高约 0.79%；thigh 扭矩限幅比例最高约 23.1%，提速前需要继续评估执行器余量。

## 性能修正原因

`gait_mdp._foot_ids()` 原来在两个奖励中每步重复读取 ContactSensor.body_names；该属性会读取整批 prim_paths。相同 4096 环境、24 步 cProfile 中，该查询共 192 次、耗时 10.752 秒。缓存静态脚部索引后，24 步从 14.234 秒降至 3.417 秒，接触数据与受影响奖励逐值完全一致。正式训练末段仍保持约 3.20 秒/轮，说明优化持续生效。

证据：`validation/r5_sampling_cache_training_status.json`、`validation/r5_sampling_cache_comparison.json`、`validation/r5_terrain_final_0p3.json`、`validation/r5_terrain_final_0p6.json`、`validation/r5_terrain_final_1p0.json`。
