Kitjesen/orix/training/v67_cts/source_assets/smalldog_v67_visual_preview.urdf

<?xml version='1.0' encoding='utf-8'?>
<robot name="smalldog_v67_visual_preview_NOT_TRAINING_READY">
  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
  <link name="base_link">
    <inertial>
      <origin xyz="-1.387778780781446e-16 -3.943925121600545e-16 0.05566961806950656" rpy="0 0 0" />
      <mass value="2.917753487891567" />
      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
    </inertial>
    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
  </link>
  <link name="battery_guide_link">
    <inertial>
      <origin xyz="0 0 0.0191666666667" rpy="0 0 0" />
      <mass value="0.0637794" />
      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
    </inertial>
    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
  </link>
  <joint name="battery_guide_mount_trial" type="fixed">
    <origin xyz="0 0 0" rpy="0 0 0" />
    <parent link="base_link" />
    <child link="battery_guide_link" />
  </joint>
  <link name="battery_pack_trial_link">
    <inertial>
      <origin xyz="0 0 0" rpy="0 0 0" />
      <mass value="1.6" />
      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
    </inertial>
    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
  </link>
  <joint name="battery_pack_mount_trial" type="fixed">
    <origin xyz="0 0 0.057" rpy="0 0 0" />
    <parent link="base_link" />
    <child link="battery_pack_trial_link" />
  </joint>
  <link name="fr_hip_Link">
    <inertial>
      <origin xyz="0.05183718184706129 0.01981398347800543 -2.861355660680695e-09" rpy="0 0 0" />
      <mass value="0.4651299408768717" />
      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
    </inertial>
    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
  </link>
  <joint name="fr_hip_joint" type="revolute">
    <origin xyz="0.13 -0.058 0.06" rpy="0 0 0" />
    <parent link="base_link" />
    <child link="fr_hip_Link" />
    <axis xyz="-1 0 0" />
    <limit lower="-0.524" upper="0.524" effort="0" velocity="0" />
  </joint>
  <link name="fr_thigh_Link">
    <inertial>
      <origin xyz="-0.02922473945967433 -0.05615068558734709 0.003274210928084048" rpy="0 0 0" />
      <mass value="1.127515571031291" />
      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
    </inertial>
    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
  </link>
  <joint name="fr_thigh_joint" type="revolute">
    <origin xyz="0.054221 0 0" rpy="0 0 0" />
    <parent link="fr_hip_Link" />
    <child link="fr_thigh_Link" />
    <axis xyz="0 1 0" />
    <limit lower="-0.86" upper="0.09" effort="0" velocity="0" />
  </joint>
  <link name="fr_calf_Link">
    <inertial>
      <origin xyz="0.1147775506624876 -3.925585585984326e-06 -0.03026169673877835" rpy="0 0 0" />
      <mass value="0.2302904588983836" />
      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
    </inertial>
    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
  </link>
  <joint name="fr_calf_joint" type="revolute">
    <origin xyz="-0.20622 -0.09345 0" rpy="0 0 0" />
    <parent link="fr_thigh_Link" />
    <child link="fr_calf_Link" />
    <axis xyz="0 1 0" />
    <limit lower="0" upper="1.37" effort="0" velocity="0" />
  </joint>
  <link name="fr_foot_Link">
    <inertial>
      <origin xyz="0.02256745139073893 -1.675570542258864e-05 -4.459926176973023e-05" rpy="0 0 0" />
      <mass value="0.09867470155176498" />
      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
    </inertial>
    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
  </link>
  <joint name="fr_foot_joint" type="fixed">
    <origin xyz="0.193 0 -0.065485" rpy="0 0.89994 0" />
    <parent link="fr_calf_Link" />
    <child link="fr_foot_Link" />
    <axis xyz="0 0 0" />
  </joint>
  <link name="fl_hip_Link">
    <inertial>
      <origin xyz="0.05183718184706129 -0.01981398347800539 2.861355693959747e-09" rpy="0 0 0" />
      <mass value="0.4651299408768717" />
      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
    </inertial>
    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
  </link>
  <joint name="fl_hip_joint" type="revolute">
    <origin xyz="0.13 0.058 0.06" rpy="0 0 0" />
    <parent link="base_link" />
    <child link="fl_hip_Link" />
    <axis xyz="-1 0 0" />
    <limit lower="-0.524" upper="0.524" effort="0" velocity="0" />
  </joint>
  <link name="fl_thigh_Link">
    <inertial>
      <origin xyz="-0.02922475406877481 0.0561506352532667 0.003274187516260913" rpy="0 0 0" />
      <mass value="1.127513998286581" />
      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
    </inertial>
    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
  </link>
  <joint name="fl_thigh_joint" type="revolute">
    <origin xyz="0.054221 0 0" rpy="0 0 0" />
    <parent link="fl_hip_Link" />
    <child link="fl_thigh_Link" />
    <axis xyz="0 -1 0" />
    <limit lower="-0.09" upper="0.86" effort="0" velocity="0" />
  </joint>
  <link name="fl_calf_Link">
    <inertial>
      <origin xyz="0.1147775508571532 -3.925585585873304e-06 -0.03026169600044362" rpy="0 0 0" />
      <mass value="0.2302904588983836" />
      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
    </inertial>
    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
  </link>
  <joint name="fl_calf_joint" type="revolute">
    <origin xyz="-0.20622 0.09345 0" rpy="0 0 0" />
    <parent link="fl_thigh_Link" />
    <child link="fl_calf_Link" />
    <axis xyz="0 -1 0" />
    <limit lower="-1.37" upper="0" effort="0" velocity="0" />
  </joint>
  <link name="fl_foot_Link">
    <inertial>
      <origin xyz="0.022567451390739 -1.675570542264415e-05 -4.459926176979961e-05" rpy="0 0 0" />
      <mass value="0.09867470155176498" />
      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
    </inertial>
    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
  </link>
  <joint name="fl_foot_joint" type="fixed">
    <origin xyz="0.193 0 -0.065485" rpy="0 0.89994 0" />
    <parent link="fl_calf_Link" />
    <child link="fl_foot_Link" />
    <axis xyz="0 0 0" />
  </joint>
  <link name="rr_hip_Link">
    <inertial>
      <origin xyz="-0.05183718184706126 0.0198139834780054 2.861355633907928e-09" rpy="0 0 0" />
      <mass value="0.4651299408768717" />
      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
    </inertial>
    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
  </link>
  <joint name="rr_hip_joint" type="revolute">
    <origin xyz="-0.13 -0.058 0.06" rpy="0 0 0" />
    <parent link="base_link" />
    <child link="rr_hip_Link" />
    <axis xyz="1 0 0" />
    <limit lower="-0.524" upper="0.524" effort="0" velocity="0" />
  </joint>
  <link name="rr_thigh_Link">
    <inertial>
      <origin xyz="-0.02922473936667003 -0.05615068558734702 0.003274211758214837" rpy="0 0 0" />
      <mass value="1.127515571031291" />
      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
    </inertial>
    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
  </link>
  <joint name="rr_thigh_joint" type="revolute">
    <origin xyz="-0.054221 0 0" rpy="0 0 0" />
    <parent link="rr_hip_Link" />
    <child link="rr_thigh_Link" />
    <axis xyz="0 1 0" />
    <limit lower="-0.86" upper="0.09" effort="0" velocity="0" />
  </joint>
  <link name="rr_calf_Link">
    <inertial>
      <origin xyz="0.1147775498029019 -3.925585586012081e-06 -0.03026169999904235" rpy="0 0 0" />
      <mass value="0.2302904588983837" />
      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
    </inertial>
    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
  </link>
  <joint name="rr_calf_joint" type="revolute">
    <origin xyz="-0.20622 -0.09345 0" rpy="0 0 0" />
    <parent link="rr_thigh_Link" />
    <child link="rr_calf_Link" />
    <axis xyz="0 1 0" />
    <limit lower="0" upper="1.37" effort="0" velocity="0" />
  </joint>
  <link name="rr_foot_Link">
    <inertial>
      <origin xyz="0.02256745139073885 -1.675570542616911e-05 -4.293009799316572e-05" rpy="0 0 0" />
      <mass value="0.09867470155176496" />
      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
    </inertial>
    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
  </link>
  <joint name="rr_foot_joint" type="fixed">
    <origin xyz="0.193 0 -0.065485" rpy="0 0.89994 0" />
    <parent link="rr_calf_Link" />
    <child link="rr_foot_Link" />
    <axis xyz="0 0 0" />
  </joint>
  <link name="rl_hip_Link">
    <inertial>
      <origin xyz="-0.05183718184706126 -0.01981398347800539 -2.861355642360205e-09" rpy="0 0 0" />
      <mass value="0.4651299408768716" />
      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
    </inertial>
    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
  </link>
  <joint name="rl_hip_joint" type="revolute">
    <origin xyz="-0.13 0.058 0.06" rpy="0 0 0" />
    <parent link="base_link" />
    <child link="rl_hip_Link" />
    <axis xyz="1 0 0" />
    <limit lower="-0.524" upper="0.524" effort="0" velocity="0" />
  </joint>
  <link name="rl_thigh_Link">
    <inertial>
      <origin xyz="-0.02922475395578633 0.05615063525326673 0.003274188524770802" rpy="0 0 0" />
      <mass value="1.127513998286581" />
      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
    </inertial>
    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
  </link>
  <joint name="rl_thigh_joint" type="revolute">
    <origin xyz="-0.054221 0 0" rpy="0 0 0" />
    <parent link="rl_hip_Link" />
    <child link="rl_thigh_Link" />
    <axis xyz="0 -1 0" />
    <limit lower="-0.09" upper="0.86" effort="0" velocity="0" />
  </joint>
  <link name="rl_calf_Link">
    <inertial>
      <origin xyz="0.1147775498128596 -3.925585585901059e-06 -0.0302616999612763" rpy="0 0 0" />
      <mass value="0.2302904588983836" />
      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
    </inertial>
    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
  </link>
  <joint name="rl_calf_joint" type="revolute">
    <origin xyz="-0.20622 0.09345 0" rpy="0 0 0" />
    <parent link="rl_thigh_Link" />
    <child link="rl_calf_Link" />
    <axis xyz="0 -1 0" />
    <limit lower="-1.37" upper="0" effort="0" velocity="0" />
  </joint>
  <link name="rl_foot_Link">
    <inertial>
      <origin xyz="0.02256745139073885 -1.675570542541971e-05 -4.293009799344327e-05" rpy="0 0 0" />
      <mass value="0.09867470155176497" />
      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
    </inertial>
    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
  </link>
  <joint name="rl_foot_joint" type="fixed">
    <origin xyz="0.193 0 -0.065485" rpy="0 0.89994 0" />
    <parent link="rl_calf_Link" />
    <child link="rl_foot_Link" />
    <axis xyz="0 0 0" />
  </joint>
  <link name="body_shell_upper_link">
    <inertial>
      <origin xyz="0.019925892591 -4.35140521151e-14 0.144447024498" rpy="0 0 0" />
      <mass value="0.347286856541" />
      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
    </inertial>
  </link>
  <joint name="body_shell_upper_link_fixed" type="fixed">
    <parent link="base_link" />
    <child link="body_shell_upper_link" />
    <origin xyz="0 0 0" rpy="0 0 0" />
  </joint>
  <link name="body_shell_lower_link">
    <inertial>
      <origin xyz="0.000591589719742 -2.07840154337e-14 0.000979163955163" rpy="0 0 0" />
      <mass value="0.294044361791" />
      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
    </inertial>
  </link>
  <joint name="body_shell_lower_link_fixed" type="fixed">
    <parent link="base_link" />
    <child link="body_shell_lower_link" />
    <origin xyz="0 0 0" rpy="0 0 0" />
  </joint>
  <link name="body_shell_right_link">
    <inertial>
      <origin xyz="3.50436709784e-18 -0.109923101824 0.0639697829604" rpy="0 0 0" />
      <mass value="0.112505305213" />
      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
    </inertial>
  </link>
  <joint name="body_shell_right_link_fixed" type="fixed">
    <parent link="base_link" />
    <child link="body_shell_right_link" />
    <origin xyz="0 0 0" rpy="0 0 0" />
  </joint>
  <link name="body_shell_left_link">
    <inertial>
      <origin xyz="0 0.109923101824 0.0639697829604" rpy="0 0 0" />
      <mass value="0.112505305213" />
      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
    </inertial>
  </link>
  <joint name="body_shell_left_link_fixed" type="fixed">
    <parent link="base_link" />
    <child link="body_shell_left_link" />
    <origin xyz="0 0 0" rpy="0 0 0" />
  </joint>
  <link name="mount_R_carrier_frame">
    <inertial>
      <origin xyz="-5.63789854363e-18 -0.1035 0.0599999998915" rpy="0 0 0" />
      <mass value="0.0743353494806" />
      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
    </inertial>
  </link>
  <joint name="mount_R_carrier_frame_fixed" type="fixed">
    <parent link="base_link" />
    <child link="mount_R_carrier_frame" />
    <origin xyz="0 0 0" rpy="0 0 0" />
  </joint>
  <link name="mount_R_rear_upper_bracket">
    <inertial>
      <origin xyz="-0.0400000000125 -0.0949216728847 0.120296506707" rpy="0 0 0" />
      <mass value="0.00362502481646" />
      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
    </inertial>
  </link>
  <joint name="mount_R_rear_upper_bracket_fixed" type="fixed">
    <parent link="base_link" />
    <child link="mount_R_rear_upper_bracket" />
    <origin xyz="0 0 0" rpy="0 0 0" />
  </joint>
  <link name="mount_R_rear_upper_spacer">
    <inertial>
      <origin xyz="-0.04 -0.085 0.131" rpy="0 0 0" />
      <mass value="0.00122266580847" />
      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
    </inertial>
  </link>
  <joint name="mount_R_rear_upper_spacer_fixed" type="fixed">
    <parent link="base_link" />
    <child link="mount_R_rear_upper_spacer" />
    <origin xyz="0 0 0" rpy="0 0 0" />
  </joint>
  <link name="mount_R_rear_lower_bracket">
    <inertial>
      <origin xyz="-0.0400000000128 -0.0947732628941 0.000354003788286" rpy="0 0 0" />
      <mass value="0.0035386248465" />
      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
    </inertial>
  </link>
  <joint name="mount_R_rear_lower_bracket_fixed" type="fixed">
    <parent link="base_link" />
    <child link="mount_R_rear_lower_bracket" />
    <origin xyz="0 0 0" rpy="0 0 0" />
  </joint>
  <link name="mount_R_front_upper_bracket">
    <inertial>
      <origin xyz="0.0400000000125 -0.0949216728847 0.120296506707" rpy="0 0 0" />
      <mass value="0.00362502481646" />
      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
    </inertial>
  </link>
  <joint name="mount_R_front_upper_bracket_fixed" type="fixed">
    <parent link="base_link" />
    <child link="mount_R_front_upper_bracket" />
    <origin xyz="0 0 0" rpy="0 0 0" />
  </joint>
  <link name="mount_R_front_upper_spacer">
    <inertial>
      <origin xyz="0.04 -0.085 0.131" rpy="0 0 0" />
      <mass value="0.00122266580847" />
      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
    </inertial>
  </link>
  <joint name="mount_R_front_upper_spacer_fixed" type="fixed">
    <parent link="base_link" />
    <child link="mount_R_front_upper_spacer" />
    <origin xyz="0 0 0" rpy="0 0 0" />
  </joint>
  <link name="mount_R_front_lower_bracket">
    <inertial>
      <origin xyz="0.0400000000128 -0.0947732628941 0.000354003788286" rpy="0 0 0" />
      <mass value="0.0035386248465" />
      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
    </inertial>
  </link>
  <joint name="mount_R_front_lower_bracket_fixed" type="fixed">
    <parent link="base_link" />
    <child link="mount_R_front_lower_bracket" />
    <origin xyz="0 0 0" rpy="0 0 0" />
  </joint>
  <link name="mount_L_carrier_frame">
    <inertial>
      <origin xyz="-5.63789854363e-18 0.1035 0.0599999998915" rpy="0 0 0" />
      <mass value="0.0743353494806" />
      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
    </inertial>
  </link>
  <joint name="mount_L_carrier_frame_fixed" type="fixed">
    <parent link="base_link" />
    <child link="mount_L_carrier_frame" />
    <origin xyz="0 0 0" rpy="0 0 0" />
  </joint>
  <link name="mount_L_rear_upper_bracket">
    <inertial>
      <origin xyz="-0.0400000000125 0.0949216728847 0.120296506707" rpy="0 0 0" />
      <mass value="0.00362502481646" />
      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
    </inertial>
  </link>
  <joint name="mount_L_rear_upper_bracket_fixed" type="fixed">
    <parent link="base_link" />
    <child link="mount_L_rear_upper_bracket" />
    <origin xyz="0 0 0" rpy="0 0 0" />
  </joint>
  <link name="mount_L_rear_upper_spacer">
    <inertial>
      <origin xyz="-0.04 0.085 0.131" rpy="0 0 0" />
      <mass value="0.00122266580847" />
      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
    </inertial>
  </link>
  <joint name="mount_L_rear_upper_spacer_fixed" type="fixed">
    <parent link="base_link" />
    <child link="mount_L_rear_upper_spacer" />
    <origin xyz="0 0 0" rpy="0 0 0" />
  </joint>
  <link name="mount_L_rear_lower_bracket">
    <inertial>
      <origin xyz="-0.0400000000128 0.0947732628941 0.000354003788286" rpy="0 0 0" />
      <mass value="0.0035386248465" />
      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
    </inertial>
  </link>
  <joint name="mount_L_rear_lower_bracket_fixed" type="fixed">
    <parent link="base_link" />
    <child link="mount_L_rear_lower_bracket" />
    <origin xyz="0 0 0" rpy="0 0 0" />
  </joint>
  <link name="mount_L_front_upper_bracket">
    <inertial>
      <origin xyz="0.0400000000125 0.0949216728847 0.120296506707" rpy="0 0 0" />
      <mass value="0.00362502481646" />
      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
    </inertial>
  </link>
  <joint name="mount_L_front_upper_bracket_fixed" type="fixed">
    <parent link="base_link" />
    <child link="mount_L_front_upper_bracket" />
    <origin xyz="0 0 0" rpy="0 0 0" />
  </joint>
  <link name="mount_L_front_upper_spacer">
    <inertial>
      <origin xyz="0.04 0.085 0.131" rpy="0 0 0" />
      <mass value="0.00122266580847" />
      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
    </inertial>
  </link>
  <joint name="mount_L_front_upper_spacer_fixed" type="fixed">
    <parent link="base_link" />
    <child link="mount_L_front_upper_spacer" />
    <origin xyz="0 0 0" rpy="0 0 0" />
  </joint>
  <link name="mount_L_front_lower_bracket">
    <inertial>
      <origin xyz="0.0400000000128 0.0947732628941 0.000354003788286" rpy="0 0 0" />
      <mass value="0.0035386248465" />
      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
    </inertial>
  </link>
  <joint name="mount_L_front_lower_bracket_fixed" type="fixed">
    <parent link="base_link" />
    <child link="mount_L_front_lower_bracket" />
    <origin xyz="0 0 0" rpy="0 0 0" />
  </joint>
  <link name="mount_R_rear_upper_pad">
    <inertial>
      <origin xyz="-0.04 -0.085 0.1414" rpy="0 0 0" />
      <mass value="0.000598182454207" />
      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
    </inertial>
  </link>
  <joint name="mount_R_rear_upper_pad_fixed" type="fixed">
    <parent link="base_link" />
    <child link="mount_R_rear_upper_pad" />
    <origin xyz="0 0 0" rpy="0 0 0" />
  </joint>
  <link name="mount_R_rear_upper_cap_pad">
    <inertial>
      <origin xyz="-0.04 -0.085 0.147949996948" rpy="0 0 0" />
      <mass value="0.00019783633873" />
      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
    </inertial>
  </link>
  <joint name="mount_R_rear_upper_cap_pad_fixed" type="fixed">
    <parent link="base_link" />
    <child link="mount_R_rear_upper_cap_pad" />
    <origin xyz="0 0 0" rpy="0 0 0" />
  </joint>
  <link name="mount_R_rear_lower_pad">
    <inertial>
      <origin xyz="-0.04 -0.085 -0.00590000009537" rpy="0 0 0" />
      <mass value="0.000224318392093" />
      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
    </inertial>
  </link>
  <joint name="mount_R_rear_lower_pad_fixed" type="fixed">
    <parent link="base_link" />
    <child link="mount_R_rear_lower_pad" />
    <origin xyz="0 0 0" rpy="0 0 0" />
  </joint>
  <link name="mount_R_rear_lower_cap_pad">
    <inertial>
      <origin xyz="-0.04 -0.085 -0.0109499998093" rpy="0 0 0" />
      <mass value="0.00019783633873" />
      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
    </inertial>
  </link>
  <joint name="mount_R_rear_lower_cap_pad_fixed" type="fixed">
    <parent link="base_link" />
    <child link="mount_R_rear_lower_cap_pad" />
    <origin xyz="0 0 0" rpy="0 0 0" />
  </joint>
  <link name="mount_R_front_upper_pad">
    <inertial>
      <origin xyz="0.04 -0.085 0.1414" rpy="0 0 0" />
      <mass value="0.000598182454207" />
      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
    </inertial>
  </link>
  <joint name="mount_R_front_upper_pad_fixed" type="fixed">
    <parent link="base_link" />
    <child link="mount_R_front_upper_pad" />
    <origin xyz="0 0 0" rpy="0 0 0" />
  </joint>
  <link name="mount_R_front_upper_cap_pad">
    <inertial>
      <origin xyz="0.04 -0.085 0.147949996948" rpy="0 0 0" />
      <mass value="0.00019783633873" />
      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
    </inertial>
  </link>
  <joint name="mount_R_front_upper_cap_pad_fixed" type="fixed">
    <parent link="base_link" />
    <child link="mount_R_front_upper_cap_pad" />
    <origin xyz="0 0 0" rpy="0 0 0" />
  </joint>
  <link name="mount_R_front_lower_pad">
    <inertial>
      <origin xyz="0.04 -0.085 -0.00590000009537" rpy="0 0 0" />
      <mass value="0.000224318392093" />
      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
    </inertial>
  </link>
  <joint name="mount_R_front_lower_pad_fixed" type="fixed">
    <parent link="base_link" />
    <child link="mount_R_front_lower_pad" />
    <origin xyz="0 0 0" rpy="0 0 0" />
  </joint>
  <link name="mount_R_front_lower_cap_pad">
    <inertial>
      <origin xyz="0.04 -0.085 -0.0109499998093" rpy="0 0 0" />
      <mass value="0.00019783633873" />
      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
    </inertial>
  </link>
  <joint name="mount_R_front_lower_cap_pad_fixed" type="fixed">
    <parent link="base_link" />
    <child link="mount_R_front_lower_cap_pad" />
    <origin xyz="0 0 0" rpy="0 0 0" />
  </joint>
  <link name="mount_R_door_support_-65_35">
    <inertial>
      <origin xyz="-0.0650000000709 -0.10675 0.03500000002" rpy="0 0 0" />
      <mass value="0.000182779124439" />
      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
    </inertial>
  </link>
  <joint name="mount_R_door_support_-65_35_fixed" type="fixed">
    <parent link="base_link" />
    <child link="mount_R_door_support_-65_35" />
    <origin xyz="0 0 0" rpy="0 0 0" />
  </joint>
  <link name="mount_R_door_support_-65_85">
    <inertial>
      <origin xyz="-0.0650000000709 -0.10675 0.085" rpy="0 0 0" />
      <mass value="0.000182779164939" />
      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
    </inertial>
  </link>
  <joint name="mount_R_door_support_-65_85_fixed" type="fixed">
    <parent link="base_link" />
    <child link="mount_R_door_support_-65_85" />
    <origin xyz="0 0 0" rpy="0 0 0" />
  </joint>
  <link name="mount_R_door_support_65_35">
    <inertial>
      <origin xyz="0.0650000000709 -0.10675 0.03500000002" rpy="0 0 0" />
      <mass value="0.000182779124439" />
      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
    </inertial>
  </link>
  <joint name="mount_R_door_support_65_35_fixed" type="fixed">
    <parent link="base_link" />
    <child link="mount_R_door_support_65_35" />
    <origin xyz="0 0 0" rpy="0 0 0" />
  </joint>
  <link name="mount_R_door_support_65_85">
    <inertial>
      <origin xyz="0.0650000000709 -0.10675 0.085" rpy="0 0 0" />
      <mass value="0.000182779164939" />
      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
    </inertial>
  </link>
  <joint name="mount_R_door_support_65_85_fixed" type="fixed">
    <parent link="base_link" />
    <child link="mount_R_door_support_65_85" />
    <origin xyz="0 0 0" rpy="0 0 0" />
  </joint>
  <link name="mount_L_rear_upper_pad">
    <inertial>
      <origin xyz="-0.04 0.085 0.1414" rpy="0 0 0" />
      <mass value="0.000598182454207" />
      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
    </inertial>
  </link>
  <joint name="mount_L_rear_upper_pad_fixed" type="fixed">
    <parent link="base_link" />
    <child link="mount_L_rear_upper_pad" />
    <origin xyz="0 0 0" rpy="0 0 0" />
  </joint>
  <link name="mount_L_rear_upper_cap_pad">
    <inertial>
      <origin xyz="-0.04 0.085 0.147949996948" rpy="0 0 0" />
      <mass value="0.00019783633873" />
      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
    </inertial>
  </link>
  <joint name="mount_L_rear_upper_cap_pad_fixed" type="fixed">
    <parent link="base_link" />
    <child link="mount_L_rear_upper_cap_pad" />
    <origin xyz="0 0 0" rpy="0 0 0" />
  </joint>
  <link name="mount_L_rear_lower_pad">
    <inertial>
      <origin xyz="-0.04 0.085 -0.00590000009537" rpy="0 0 0" />
      <mass value="0.000224318392093" />
      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
    </inertial>
  </link>
  <joint name="mount_L_rear_lower_pad_fixed" type="fixed">
    <parent link="base_link" />
    <child link="mount_L_rear_lower_pad" />
    <origin xyz="0 0 0" rpy="0 0 0" />
  </joint>
  <link name="mount_L_rear_lower_cap_pad">
    <inertial>
      <origin xyz="-0.04 0.085 -0.0109499998093" rpy="0 0 0" />
      <mass value="0.00019783633873" />
      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
    </inertial>
  </link>
  <joint name="mount_L_rear_lower_cap_pad_fixed" type="fixed">
    <parent link="base_link" />
    <child link="mount_L_rear_lower_cap_pad" />
    <origin xyz="0 0 0" rpy="0 0 0" />
  </joint>
  <link name="mount_L_front_upper_pad">
    <inertial>
      <origin xyz="0.04 0.085 0.1414" rpy="0 0 0" />
      <mass value="0.000598182454207" />
      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
    </inertial>
  </link>
  <joint name="mount_L_front_upper_pad_fixed" type="fixed">
    <parent link="base_link" />
    <child link="mount_L_front_upper_pad" />
    <origin xyz="0 0 0" rpy="0 0 0" />
  </joint>
  <link name="mount_L_front_upper_cap_pad">
    <inertial>
      <origin xyz="0.04 0.085 0.147949996948" rpy="0 0 0" />
      <mass value="0.00019783633873" />
      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
    </inertial>
  </link>
  <joint name="mount_L_front_upper_cap_pad_fixed" type="fixed">
    <parent link="base_link" />
    <child link="mount_L_front_upper_cap_pad" />
    <origin xyz="0 0 0" rpy="0 0 0" />
  </joint>
  <link name="mount_L_front_lower_pad">
    <inertial>
      <origin xyz="0.04 0.085 -0.00590000009537" rpy="0 0 0" />
      <mass value="0.000224318392093" />
      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
    </inertial>
  </link>
  <joint name="mount_L_front_lower_pad_fixed" type="fixed">
    <parent link="base_link" />
    <child link="mount_L_front_lower_pad" />
    <origin xyz="0 0 0" rpy="0 0 0" />
  </joint>
  <link name="mount_L_front_lower_cap_pad">
    <inertial>
      <origin xyz="0.04 0.085 -0.0109499998093" rpy="0 0 0" />
      <mass value="0.00019783633873" />
      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
    </inertial>
  </link>
  <joint name="mount_L_front_lower_cap_pad_fixed" type="fixed">
    <parent link="base_link" />
    <child link="mount_L_front_lower_cap_pad" />
    <origin xyz="0 0 0" rpy="0 0 0" />
  </joint>
  <link name="mount_L_door_support_-65_35">
    <inertial>
      <origin xyz="-0.0650000000709 0.10675 0.03500000002" rpy="0 0 0" />
      <mass value="0.000182779124439" />
      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
    </inertial>
  </link>
  <joint name="mount_L_door_support_-65_35_fixed" type="fixed">
    <parent link="base_link" />
    <child link="mount_L_door_support_-65_35" />
    <origin xyz="0 0 0" rpy="0 0 0" />
  </joint>
  <link name="mount_L_door_support_-65_85">
    <inertial>
      <origin xyz="-0.0650000000709 0.10675 0.085" rpy="0 0 0" />
      <mass value="0.000182779164939" />
      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
    </inertial>
  </link>
  <joint name="mount_L_door_support_-65_85_fixed" type="fixed">
    <parent link="base_link" />
    <child link="mount_L_door_support_-65_85" />
    <origin xyz="0 0 0" rpy="0 0 0" />
  </joint>
  <link name="mount_L_door_support_65_35">
    <inertial>
      <origin xyz="0.0650000000709 0.10675 0.03500000002" rpy="0 0 0" />
      <mass value="0.000182779124439" />
      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
    </inertial>
  </link>
  <joint name="mount_L_door_support_65_35_fixed" type="fixed">
    <parent link="base_link" />
    <child link="mount_L_door_support_65_35" />
    <origin xyz="0 0 0" rpy="0 0 0" />
  </joint>
  <link name="mount_L_door_support_65_85">
    <inertial>
      <origin xyz="0.0650000000709 0.10675 0.085" rpy="0 0 0" />
      <mass value="0.000182779164939" />
      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
    </inertial>
  </link>
  <joint name="mount_L_door_support_65_85_fixed" type="fixed">
    <parent link="base_link" />
    <child link="mount_L_door_support_65_85" />
    <origin xyz="0 0 0" rpy="0 0 0" />
  </joint>
  <link name="mount_camera_load_bridge">
    <inertial>
      <origin xyz="0.0512033811255 2.01711159013e-10 0.138938134195" rpy="0 0 0" />
      <mass value="0.128845197051" />
      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
    </inertial>
  </link>
  <joint name="mount_camera_load_bridge_fixed" type="fixed">
    <parent link="base_link" />
    <child link="mount_camera_load_bridge" />
    <origin xyz="0 0 0" rpy="0 0 0" />
  </joint>
  <link name="mount_camera_riser_x150_y-45">
    <inertial>
      <origin xyz="0.15 -0.045 0.16075" rpy="0 0 0" />
      <mass value="0.000916999009843" />
      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
    </inertial>
  </link>
  <joint name="mount_camera_riser_x150_y-45_fixed" type="fixed">
    <parent link="base_link" />
    <child link="mount_camera_riser_x150_y-45" />
    <origin xyz="0 0 0" rpy="0 0 0" />
  </joint>
  <link name="mount_camera_riser_x150_y+45">
    <inertial>
      <origin xyz="0.15 0.045 0.16075" rpy="0 0 0" />
      <mass value="0.000916999009843" />
      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
    </inertial>
  </link>
  <joint name="mount_camera_riser_x150_y+45_fixed" type="fixed">
    <parent link="base_link" />
    <child link="mount_camera_riser_x150_y+45" />
    <origin xyz="0 0 0" rpy="0 0 0" />
  </joint>
  <link name="mount_camera_riser_x186_y-45">
    <inertial>
      <origin xyz="0.186 -0.045 0.16075" rpy="0 0 0" />
      <mass value="0.000916999009843" />
      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
    </inertial>
  </link>
  <joint name="mount_camera_riser_x186_y-45_fixed" type="fixed">
    <parent link="base_link" />
    <child link="mount_camera_riser_x186_y-45" />
    <origin xyz="0 0 0" rpy="0 0 0" />
  </joint>
  <link name="mount_camera_riser_x186_y+45">
    <inertial>
      <origin xyz="0.186 0.045 0.16075" rpy="0 0 0" />
      <mass value="0.000916999009843" />
      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
    </inertial>
  </link>
  <joint name="mount_camera_riser_x186_y+45_fixed" type="fixed">
    <parent link="base_link" />
    <child link="mount_camera_riser_x186_y+45" />
    <origin xyz="0 0 0" rpy="0 0 0" />
  </joint>
  <link name="mount_camera_mount_plate">
    <inertial>
      <origin xyz="0.173022600207 -2.70167059635e-13 0.17" rpy="0 0 0" />
      <mass value="0.0649759572831" />
      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
    </inertial>
  </link>
  <joint name="mount_camera_mount_plate_fixed" type="fixed">
    <parent link="base_link" />
    <child link="mount_camera_mount_plate" />
    <origin xyz="0 0 0" rpy="0 0 0" />
  </joint>
  <link name="mount_camera_inner_pad_x150_y-45">
    <inertial>
      <origin xyz="0.15 -0.045 0.164650001526" rpy="0 0 0" />
      <mass value="3.73867843019e-05" />
      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
    </inertial>
  </link>
  <joint name="mount_camera_inner_pad_x150_y-45_fixed" type="fixed">
    <parent link="base_link" />
    <child link="mount_camera_inner_pad_x150_y-45" />
    <origin xyz="0 0 0" rpy="0 0 0" />
  </joint>
  <link name="mount_camera_outer_washer_x150_y-45">
    <inertial>
      <origin xyz="0.15 -0.045 0.16825" rpy="0 0 0" />
      <mass value="5.71181172035e-05" />
      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
    </inertial>
  </link>
  <joint name="mount_camera_outer_washer_x150_y-45_fixed" type="fixed">
    <parent link="base_link" />
    <child link="mount_camera_outer_washer_x150_y-45" />
    <origin xyz="0 0 0" rpy="0 0 0" />
  </joint>
  <link name="mount_camera_inner_pad_x150_y+45">
    <inertial>
      <origin xyz="0.15 0.045 0.164650001526" rpy="0 0 0" />
      <mass value="3.73867843019e-05" />
      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
    </inertial>
  </link>
  <joint name="mount_camera_inner_pad_x150_y+45_fixed" type="fixed">
    <parent link="base_link" />
    <child link="mount_camera_inner_pad_x150_y+45" />
    <origin xyz="0 0 0" rpy="0 0 0" />
  </joint>
  <link name="mount_camera_outer_washer_x150_y+45">
    <inertial>
      <origin xyz="0.15 0.045 0.16825" rpy="0 0 0" />
      <mass value="5.71181172035e-05" />
      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
    </inertial>
  </link>
  <joint name="mount_camera_outer_washer_x150_y+45_fixed" type="fixed">
    <parent link="base_link" />
    <child link="mount_camera_outer_washer_x150_y+45" />
    <origin xyz="0 0 0" rpy="0 0 0" />
  </joint>
  <link name="mount_camera_inner_pad_x186_y-45">
    <inertial>
      <origin xyz="0.186 -0.045 0.164650001526" rpy="0 0 0" />
      <mass value="3.73867843019e-05" />
      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
    </inertial>
  </link>
  <joint name="mount_camera_inner_pad_x186_y-45_fixed" type="fixed">
    <parent link="base_link" />
    <child link="mount_camera_inner_pad_x186_y-45" />
    <origin xyz="0 0 0" rpy="0 0 0" />
  </joint>
  <link name="mount_camera_outer_washer_x186_y-45">
    <inertial>
      <origin xyz="0.186 -0.045 0.16825" rpy="0 0 0" />
      <mass value="5.71181172035e-05" />
      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
    </inertial>
  </link>
  <joint name="mount_camera_outer_washer_x186_y-45_fixed" type="fixed">
    <parent link="base_link" />
    <child link="mount_camera_outer_washer_x186_y-45" />
    <origin xyz="0 0 0" rpy="0 0 0" />
  </joint>
  <link name="mount_camera_inner_pad_x186_y+45">
    <inertial>
      <origin xyz="0.186 0.045 0.164650001526" rpy="0 0 0" />
      <mass value="3.73867843019e-05" />
      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
    </inertial>
  </link>
  <joint name="mount_camera_inner_pad_x186_y+45_fixed" type="fixed">
    <parent link="base_link" />
    <child link="mount_camera_inner_pad_x186_y+45" />
    <origin xyz="0 0 0" rpy="0 0 0" />
  </joint>
  <link name="mount_camera_outer_washer_x186_y+45">
    <inertial>
      <origin xyz="0.186 0.045 0.16825" rpy="0 0 0" />
      <mass value="5.71181172035e-05" />
      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
    </inertial>
  </link>
  <joint name="mount_camera_outer_washer_x186_y+45_fixed" type="fixed">
    <parent link="base_link" />
    <child link="mount_camera_outer_washer_x186_y+45" />
    <origin xyz="0 0 0" rpy="0 0 0" />
  </joint>
  <link name="mount_camera_cable_grommet">
    <inertial>
      <origin xyz="0.136 0 0.1685" rpy="0 0 0" />
      <mass value="8.28048690327e-05" />
      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
    </inertial>
  </link>
  <joint name="mount_camera_cable_grommet_fixed" type="fixed">
    <parent link="base_link" />
    <child link="mount_camera_cable_grommet" />
    <origin xyz="0 0 0" rpy="0 0 0" />
  </joint>
  <link name="mount_camera_placeholder">
    <inertial>
      <origin xyz="0.173058844819 -2.87038429063e-19 0.189" rpy="0 0 0" />
      <mass value="0.2" />
      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
    </inertial>
  </link>
  <joint name="mount_camera_placeholder_fixed" type="fixed">
    <parent link="base_link" />
    <child link="mount_camera_placeholder" />
    <origin xyz="0 0 0" rpy="0 0 0" />
  </joint>
  <link name="mount_fastener_mass_allowance">
    <inertial>
      <origin xyz="0.02 0 0.065" rpy="0 0 0" />
      <mass value="0.08" />
      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
    </inertial>
  </link>
  <joint name="mount_fastener_mass_allowance_fixed" type="fixed">
    <parent link="base_link" />
    <child link="mount_fastener_mass_allowance" />
    <origin xyz="0 0 0" rpy="0 0 0" />
  </joint>
</robot>
