Kitjesen/orix/training/recovery_headless/params/env.yaml

viewer:
  eye: !!python/tuple
  - 7.5
  - 7.5
  - 7.5
  lookat: !!python/tuple
  - 0.0
  - 0.0
  - 0.0
  cam_prim_path: /OmniverseKit_Persp
  resolution: !!python/tuple
  - 1280
  - 720
  origin_type: world
  env_index: 0
  asset_name: null
  body_name: null
sim:
  physics_prim_path: /physicsScene
  device: cuda:0
  dt: 0.005
  render_interval: 4
  gravity: !!python/tuple
  - 0.0
  - 0.0
  - -9.81
  enable_scene_query_support: false
  use_fabric: true
  physx:
    solver_type: 1
    min_position_iteration_count: 1
    max_position_iteration_count: 255
    min_velocity_iteration_count: 0
    max_velocity_iteration_count: 255
    enable_ccd: false
    enable_stabilization: false
    enable_enhanced_determinism: false
    bounce_threshold_velocity: 0.5
    friction_offset_threshold: 0.04
    friction_correlation_distance: 0.025
    gpu_max_rigid_contact_count: 8388608
    gpu_max_rigid_patch_count: 327680
    gpu_found_lost_pairs_capacity: 2097152
    gpu_found_lost_aggregate_pairs_capacity: 33554432
    gpu_total_aggregate_pairs_capacity: 2097152
    gpu_collision_stack_size: 67108864
    gpu_heap_capacity: 67108864
    gpu_temp_buffer_capacity: 16777216
    gpu_max_num_partitions: 8
    gpu_max_soft_body_contacts: 1048576
    gpu_max_particle_contacts: 1048576
  physics_material:
    func: isaaclab.sim.spawners.materials.physics_materials:spawn_rigid_body_material
    static_friction: 1.0
    dynamic_friction: 1.0
    restitution: 1.0
    friction_combine_mode: multiply
    restitution_combine_mode: multiply
    compliant_contact_stiffness: 0.0
    compliant_contact_damping: 0.0
  render:
    enable_translucency: null
    enable_reflections: null
    enable_global_illumination: null
    antialiasing_mode: null
    enable_dlssg: null
    enable_dl_denoiser: null
    dlss_mode: null
    enable_direct_lighting: null
    samples_per_pixel: null
    enable_shadows: null
    enable_ambient_occlusion: null
    carb_settings: null
    rendering_mode: null
  create_stage_in_memory: false
ui_window_class_type: isaaclab.envs.ui.manager_based_rl_env_window:ManagerBasedRLEnvWindow
seed: 42
decimation: 4
scene:
  num_envs: 2048
  env_spacing: 3.0
  lazy_sensor_update: true
  replicate_physics: true
  filter_collisions: true
  clone_in_fabric: false
  robot:
    class_type: isaaclab.assets.articulation.articulation:Articulation
    prim_path: /World/envs/env_.*/Robot
    spawn:
      asset_path: training/v67_cts/assets/smalldog_v67/urdf/smalldog_v67.urdf
      usd_dir: training/v67_cts/assets/smalldog_v67/usd
      usd_file_name: v67_sim_r5_headless.usd
      force_usd_conversion: false
      make_instanceable: true
      fix_base: false
      root_link_name: null
      link_density: 0.0
      merge_fixed_joints: false
      convert_mimic_joints_to_normal_joints: false
      joint_drive:
        drive_type: force
        target_type: position
        gains:
          stiffness: 0
          damping: 0
      collider_type: convex_hull
      self_collision: true
      replace_cylinders_with_capsules: false
      collision_from_visuals: false
      func: isaaclab.sim.spawners.from_files.from_files:spawn_from_urdf
      visible: true
      semantic_tags: null
      copy_from_source: true
      mass_props: null
      deformable_props: null
      rigid_props:
        rigid_body_enabled: null
        kinematic_enabled: null
        disable_gravity: false
        linear_damping: 0
        angular_damping: 0
        max_linear_velocity: null
        max_angular_velocity: null
        max_depenetration_velocity: 1.0
        max_contact_impulse: null
        enable_gyroscopic_forces: null
        retain_accelerations: false
        solver_position_iteration_count: null
        solver_velocity_iteration_count: null
        sleep_threshold: null
        stabilization_threshold: null
      collision_props: null
      activate_contact_sensors: true
      scale: null
      articulation_props:
        articulation_enabled: null
        enabled_self_collisions: true
        solver_position_iteration_count: 8
        solver_velocity_iteration_count: 4
        sleep_threshold: null
        stabilization_threshold: null
        fix_root_link: null
      fixed_tendons_props: null
      spatial_tendons_props: null
      joint_drive_props: null
      visual_material_path: material
      visual_material: null
    init_state:
      pos: !!python/tuple
      - 0
      - 0
      - 0.2674918208774965
      rot: !!python/tuple
      - 1.0
      - 0.0
      - 0.0
      - 0.0
      lin_vel: !!python/tuple
      - 0.0
      - 0.0
      - 0.0
      ang_vel: !!python/tuple
      - 0.0
      - 0.0
      - 0.0
      joint_pos:
        fr_hip_joint: 0.0
        fr_thigh_joint: -0.6715534335840251
        fr_calf_joint: 1.1
        fl_hip_joint: 0.0
        fl_thigh_joint: 0.6715534335840251
        fl_calf_joint: -1.1
        rr_hip_joint: 0.0
        rr_thigh_joint: -0.6715534335840251
        rr_calf_joint: 1.1
        rl_hip_joint: 0.0
        rl_thigh_joint: 0.6715534335840251
        rl_calf_joint: -1.1
      joint_vel:
        .*: 0.0
    collision_group: 0
    debug_vis: false
    articulation_root_prim_path: null
    soft_joint_pos_limit_factor: 0.9
    actuators:
      hip_thigh_rs02:
        class_type: isaaclab.actuators.actuator_pd:DCMotor
        joint_names_expr:
        - .*_(hip|thigh)_joint
        effort_limit: 17.0
        velocity_limit: 42.9350995991
        effort_limit_sim: 17.0
        velocity_limit_sim: 42.9350995991
        stiffness: 40.0
        damping: 0.8
        armature: 0.0042
        friction: 0.0
        dynamic_friction: null
        viscous_friction: null
        saturation_effort: 17.0
      calf_rs02_2to1:
        class_type: isaaclab.actuators.actuator_pd:DCMotor
        joint_names_expr:
        - .*_calf_joint
        effort_limit: 17.0
        velocity_limit: 21.4675497995
        effort_limit_sim: 17.0
        velocity_limit_sim: 21.4675497995
        stiffness: 60.0
        damping: 1.5
        armature: 0.0168
        friction: 0.0
        dynamic_friction: null
        viscous_friction: null
        saturation_effort: 17.0
    actuator_value_resolution_debug_print: false
  terrain:
    class_type: isaaclab.terrains.terrain_importer:TerrainImporter
    collision_group: -1
    prim_path: /World/ground
    num_envs: 2048
    terrain_type: plane
    terrain_generator: null
    usd_path: null
    env_spacing: 3.0
    visual_material:
      func: isaaclab.sim.spawners.materials.visual_materials:spawn_from_mdl_file
      mdl_path: http://omniverse-content-production.s3-us-west-2.amazonaws.com/Assets/Isaac/4.5/Isaac/IsaacLab/Materials/TilesMarbleSpiderWhiteBrickBondHoned/TilesMarbleSpiderWhiteB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
      project_uvw: true
      albedo_brightness: null
      texture_scale: !!python/tuple
      - 0.25
      - 0.25
    physics_material:
      func: isaaclab.sim.spawners.materials.physics_materials:spawn_rigid_body_material
      static_friction: 1.0
      dynamic_friction: 1.0
      restitution: 1.0
      friction_combine_mode: multiply
      restitution_combine_mode: multiply
      compliant_contact_stiffness: 0.0
      compliant_contact_damping: 0.0
    max_init_terrain_level: 5
    debug_vis: false
  height_scanner:
    class_type: isaaclab.sensors.ray_caster.ray_caster:RayCaster
    prim_path: /World/envs/env_.*/Robot/base_link
    update_period: 0.02
    history_length: 0
    debug_vis: false
    mesh_prim_paths:
    - /World/ground
    offset:
      pos: !!python/tuple
      - 0.0
      - 0.0
      - 20.0
      rot: !!python/tuple
      - 1.0
      - 0.0
      - 0.0
      - 0.0
    attach_yaw_only: false
    ray_alignment: yaw
    pattern_cfg:
      func: isaaclab.sensors.ray_caster.patterns.patterns:grid_pattern
      resolution: 0.1
      size: !!python/tuple
      - 1.6
      - 1.0
      direction: !!python/tuple
      - 0.0
      - 0.0
      - -1.0
      ordering: xy
    max_distance: 1000000.0
    drift_range: !!python/tuple
    - 0.0
    - 0.0
    ray_cast_drift_range:
      x: !!python/tuple
      - 0.0
      - 0.0
      y: !!python/tuple
      - 0.0
      - 0.0
      z: !!python/tuple
      - 0.0
      - 0.0
    visualizer_cfg:
      prim_path: /Visuals/RayCaster
      markers:
        hit:
          func: isaaclab.sim.spawners.shapes.shapes:spawn_sphere
          visible: true
          semantic_tags: null
          copy_from_source: true
          mass_props: null
          rigid_props: null
          collision_props: null
          activate_contact_sensors: false
          visual_material_path: material
          visual_material:
            func: isaaclab.sim.spawners.materials.visual_materials:spawn_preview_surface
            diffuse_color: !!python/tuple
            - 1.0
            - 0.0
            - 0.0
            emissive_color: !!python/tuple
            - 0.0
            - 0.0
            - 0.0
            roughness: 0.5
            metallic: 0.0
            opacity: 1.0
          physics_material_path: material
          physics_material: null
          radius: 0.02
  height_scanner_base: null
  contact_forces:
    class_type: isaaclab.sensors.contact_sensor.contact_sensor:ContactSensor
    prim_path: /World/envs/env_.*/Robot/.*
    update_period: 0.005
    history_length: 3
    debug_vis: false
    track_pose: false
    track_contact_points: false
    max_contact_data_count_per_prim: 4
    track_air_time: true
    force_threshold: 1.0
    filter_prim_paths_expr: []
    visualizer_cfg:
      prim_path: /Visuals/ContactSensor
      markers:
        contact:
          func: isaaclab.sim.spawners.shapes.shapes:spawn_sphere
          visible: true
          semantic_tags: null
          copy_from_source: true
          mass_props: null
          rigid_props: null
          collision_props: null
          activate_contact_sensors: false
          visual_material_path: material
          visual_material:
            func: isaaclab.sim.spawners.materials.visual_materials:spawn_preview_surface
            diffuse_color: !!python/tuple
            - 1.0
            - 0.0
            - 0.0
            emissive_color: !!python/tuple
            - 0.0
            - 0.0
            - 0.0
            roughness: 0.5
            metallic: 0.0
            opacity: 1.0
          physics_material_path: material
          physics_material: null
          radius: 0.02
        no_contact:
          func: isaaclab.sim.spawners.shapes.shapes:spawn_sphere
          visible: false
          semantic_tags: null
          copy_from_source: true
          mass_props: null
          rigid_props: null
          collision_props: null
          activate_contact_sensors: false
          visual_material_path: material
          visual_material:
            func: isaaclab.sim.spawners.materials.visual_materials:spawn_preview_surface
            diffuse_color: !!python/tuple
            - 0.0
            - 1.0
            - 0.0
            emissive_color: !!python/tuple
            - 0.0
            - 0.0
            - 0.0
            roughness: 0.5
            metallic: 0.0
            opacity: 1.0
          physics_material_path: material
          physics_material: null
          radius: 0.02
  sky_light:
    class_type: null
    prim_path: /World/skyLight
    spawn:
      func: isaaclab.sim.spawners.lights.lights:spawn_light
      visible: true
      semantic_tags: null
      copy_from_source: true
      prim_type: DomeLight
      color: !!python/tuple
      - 1.0
      - 1.0
      - 1.0
      enable_color_temperature: false
      color_temperature: 6500.0
      normalize: false
      exposure: 0.0
      intensity: 750.0
      texture_file: http://omniverse-content-production.s3-us-west-2.amazonaws.com/Assets/Isaac/4.5/Isaac/Materials/Textures/Skies/PolyHaven/kloofendal_43d_clear_puresky_4k.hdr
      texture_format: automatic
      visible_in_primary_ray: true
    init_state:
      pos: !!python/tuple
      - 0.0
      - 0.0
      - 0.0
      rot: !!python/tuple
      - 1.0
      - 0.0
      - 0.0
      - 0.0
    collision_group: 0
    debug_vis: false
recorders:
  dataset_file_handler_class_type: isaaclab.utils.datasets.hdf5_dataset_file_handler:HDF5DatasetFileHandler
  dataset_export_dir_path: /tmp/isaaclab/logs
  dataset_filename: dataset
  dataset_export_mode:
    _value_: 1
    _name_: EXPORT_ALL
  export_in_record_pre_reset: true
observations:
  policy:
    concatenate_terms: true
    concatenate_dim: -1
    enable_corruption: true
    history_length: 5
    flatten_history_dim: true
    base_ang_vel:
      func: isaaclab.envs.mdp.observations:base_ang_vel
      params: {}
      modifiers: null
      noise:
        func: isaaclab.utils.noise.noise_model:uniform_noise
        operation: add
        n_min: -0.2
        n_max: 0.2
      clip: null
      scale: null
      history_length: 0
      flatten_history_dim: true
    projected_gravity:
      func: isaaclab.envs.mdp.observations:projected_gravity
      params: {}
      modifiers: null
      noise:
        func: isaaclab.utils.noise.noise_model:uniform_noise
        operation: add
        n_min: -0.05
        n_max: 0.05
      clip: null
      scale: null
      history_length: 0
      flatten_history_dim: true
    joint_pos:
      func: isaaclab.envs.mdp.observations:joint_pos
      params:
        asset_cfg:
          name: robot
          joint_names:
          - fr_hip_joint
          - fr_thigh_joint
          - fr_calf_joint
          - fl_hip_joint
          - fl_thigh_joint
          - fl_calf_joint
          - rr_hip_joint
          - rr_thigh_joint
          - rr_calf_joint
          - rl_hip_joint
          - rl_thigh_joint
          - rl_calf_joint
          joint_ids: !!python/object/apply:builtins.slice
          - null
          - null
          - null
          fixed_tendon_names: null
          fixed_tendon_ids: !!python/object/apply:builtins.slice
          - null
          - null
          - null
          body_names: null
          body_ids: !!python/object/apply:builtins.slice
          - null
          - null
          - null
          object_collection_names: null
          object_collection_ids: !!python/object/apply:builtins.slice
          - null
          - null
          - null
          preserve_order: true
      modifiers: null
      noise:
        func: isaaclab.utils.noise.noise_model:uniform_noise
        operation: add
        n_min: -0.01
        n_max: 0.01
      clip: null
      scale: null
      history_length: 0
      flatten_history_dim: true
    joint_vel:
      func: isaaclab.envs.mdp.observations:joint_vel
      params:
        asset_cfg:
          name: robot
          joint_names:
          - fr_hip_joint
          - fr_thigh_joint
          - fr_calf_joint
          - fl_hip_joint
          - fl_thigh_joint
          - fl_calf_joint
          - rr_hip_joint
          - rr_thigh_joint
          - rr_calf_joint
          - rl_hip_joint
          - rl_thigh_joint
          - rl_calf_joint
          joint_ids: !!python/object/apply:builtins.slice
          - null
          - null
          - null
          fixed_tendon_names: null
          fixed_tendon_ids: !!python/object/apply:builtins.slice
          - null
          - null
          - null
          body_names: null
          body_ids: !!python/object/apply:builtins.slice
          - null
          - null
          - null
          object_collection_names: null
          object_collection_ids: !!python/object/apply:builtins.slice
          - null
          - null
          - null
          preserve_order: true
      modifiers: null
      noise:
        func: isaaclab.utils.noise.noise_model:uniform_noise
        operation: add
        n_min: -1.5
        n_max: 1.5
      clip: null
      scale: null
      history_length: 0
      flatten_history_dim: true
    actions:
      func: robot_lab.tasks.manager_based.recovery.config.orix_frnet.mdp_v4:executed_delta_q
      params: {}
      modifiers: null
      noise: null
      clip: null
      scale: null
      history_length: 0
      flatten_history_dim: true
  critic:
    concatenate_terms: true
    concatenate_dim: -1
    enable_corruption: false
    history_length: 0
    flatten_history_dim: true
    base_ang_vel:
      func: isaaclab.envs.mdp.observations:base_ang_vel
      params: {}
      modifiers: null
      noise:
        func: isaaclab.utils.noise.noise_model:uniform_noise
        operation: add
        n_min: -0.2
        n_max: 0.2
      clip: null
      scale: null
      history_length: 0
      flatten_history_dim: true
    projected_gravity:
      func: isaaclab.envs.mdp.observations:projected_gravity
      params: {}
      modifiers: null
      noise:
        func: isaaclab.utils.noise.noise_model:uniform_noise
        operation: add
        n_min: -0.05
        n_max: 0.05
      clip: null
      scale: null
      history_length: 0
      flatten_history_dim: true
    joint_pos:
      func: isaaclab.envs.mdp.observations:joint_pos
      params:
        asset_cfg:
          name: robot
          joint_names:
          - fr_hip_joint
          - fr_thigh_joint
          - fr_calf_joint
          - fl_hip_joint
          - fl_thigh_joint
          - fl_calf_joint
          - rr_hip_joint
          - rr_thigh_joint
          - rr_calf_joint
          - rl_hip_joint
          - rl_thigh_joint
          - rl_calf_joint
          joint_ids: !!python/object/apply:builtins.slice
          - null
          - null
          - null
          fixed_tendon_names: null
          fixed_tendon_ids: !!python/object/apply:builtins.slice
          - null
          - null
          - null
          body_names: null
          body_ids: !!python/object/apply:builtins.slice
          - null
          - null
          - null
          object_collection_names: null
          object_collection_ids: !!python/object/apply:builtins.slice
          - null
          - null
          - null
          preserve_order: true
      modifiers: null
      noise:
        func: isaaclab.utils.noise.noise_model:uniform_noise
        operation: add
        n_min: -0.01
        n_max: 0.01
      clip: null
      scale: null
      history_length: 0
      flatten_history_dim: true
    joint_vel:
      func: isaaclab.envs.mdp.observations:joint_vel
      params:
        asset_cfg:
          name: robot
          joint_names:
          - fr_hip_joint
          - fr_thigh_joint
          - fr_calf_joint
          - fl_hip_joint
          - fl_thigh_joint
          - fl_calf_joint
          - rr_hip_joint
          - rr_thigh_joint
          - rr_calf_joint
          - rl_hip_joint
          - rl_thigh_joint
          - rl_calf_joint
          joint_ids: !!python/object/apply:builtins.slice
          - null
          - null
          - null
          fixed_tendon_names: null
          fixed_tendon_ids: !!python/object/apply:builtins.slice
          - null
          - null
          - null
          body_names: null
          body_ids: !!python/object/apply:builtins.slice
          - null
          - null
          - null
          object_collection_names: null
          object_collection_ids: !!python/object/apply:builtins.slice
          - null
          - null
          - null
          preserve_order: true
      modifiers: null
      noise:
        func: isaaclab.utils.noise.noise_model:uniform_noise
        operation: add
        n_min: -1.5
        n_max: 1.5
      clip: null
      scale: null
      history_length: 0
      flatten_history_dim: true
    actions:
      func: robot_lab.tasks.manager_based.recovery.config.orix_frnet.mdp_v4:executed_delta_q
      params: {}
      modifiers: null
      noise: null
      clip: null
      scale: null
      history_length: 0
      flatten_history_dim: true
    height_scan:
      func: isaaclab.envs.mdp.observations:height_scan
      params:
        sensor_cfg:
          name: height_scanner
          joint_names: null
          joint_ids: !!python/object/apply:builtins.slice
          - null
          - null
          - null
          fixed_tendon_names: null
          fixed_tendon_ids: !!python/object/apply:builtins.slice
          - null
          - null
          - null
          body_names: null
          body_ids: !!python/object/apply:builtins.slice
          - null
          - null
          - null
          object_collection_names: null
          object_collection_ids: !!python/object/apply:builtins.slice
          - null
          - null
          - null
          preserve_order: false
        offset: 0.0
      modifiers: null
      noise: null
      clip: null
      scale: null
      history_length: 0
      flatten_history_dim: true
    body_group_masses:
      func: robot_lab.tasks.manager_based.recovery.config.orix_frnet.mdp_v4:body_group_masses
      params: {}
      modifiers: null
      noise: null
      clip: null
      scale: null
      history_length: 0
      flatten_history_dim: true
    pd_gains:
      func: robot_lab.tasks.manager_based.recovery.config.orix_frnet.mdp_v4:pd_gains
      params: {}
      modifiers: null
      noise: null
      clip: null
      scale: null
      history_length: 0
      flatten_history_dim: true
    base_com_xy:
      func: robot_lab.tasks.manager_based.recovery.config.orix_frnet.mdp_v4:base_com_xy
      params: {}
      modifiers: null
      noise: null
      clip: null
      scale: null
      history_length: 0
      flatten_history_dim: true
    body_contacts:
      func: robot_lab.tasks.manager_based.recovery.config.orix_frnet.mdp_v4:body_contacts
      params: {}
      modifiers: null
      noise: null
      clip: null
      scale: null
      history_length: 0
      flatten_history_dim: true
    foot_contact_forces:
      func: robot_lab.tasks.manager_based.recovery.config.orix_frnet.mdp_v4:foot_contact_forces
      params: {}
      modifiers: null
      noise: null
      clip: null
      scale: null
      history_length: 0
      flatten_history_dim: true
    foot_friction:
      func: robot_lab.tasks.manager_based.recovery.config.orix_frnet.mdp_v4:foot_friction
      params: {}
      modifiers: null
      noise: null
      clip: null
      scale: null
      history_length: 0
      flatten_history_dim: true
  mcp_targets:
    concatenate_terms: true
    concatenate_dim: -1
    enable_corruption: false
    history_length: null
    flatten_history_dim: true
    body_group_masses:
      func: robot_lab.tasks.manager_based.recovery.config.orix_frnet.mdp_v4:body_group_masses
      params: {}
      modifiers: null
      noise: null
      clip: null
      scale: null
      history_length: 0
      flatten_history_dim: true
    body_contact_binary:
      func: robot_lab.tasks.manager_based.recovery.config.orix_frnet.mdp_v4:body_contacts
      params: {}
      modifiers: null
      noise: null
      clip: null
      scale: null
      history_length: 0
      flatten_history_dim: true
actions:
  joint_pos:
    class_type: isaaclab.envs.mdp.actions.joint_actions:JointPositionAction
    asset_name: robot
    debug_vis: false
    clip:
      fr_hip_joint: !!python/tuple
      - -0.9450000000000001
      - 0.9450000000000001
      fr_thigh_joint: !!python/tuple
      - -2.8877963267948967
      - 1.6662036732051035
      fr_calf_joint: !!python/tuple
      - 0.4849999999999999
      - 2.015
      fl_hip_joint: !!python/tuple
      - -0.9450000000000001
      - 0.9450000000000001
      fl_thigh_joint: !!python/tuple
      - -1.6662036732051035
      - 2.8877963267948967
      fl_calf_joint: !!python/tuple
      - -2.015
      - -0.4849999999999999
      rr_hip_joint: !!python/tuple
      - -0.9450000000000001
      - 0.9450000000000001
      rr_thigh_joint: !!python/tuple
      - -2.8877963267948967
      - 1.6662036732051035
      rr_calf_joint: !!python/tuple
      - 0.4849999999999999
      - 2.015
      rl_hip_joint: !!python/tuple
      - -0.9450000000000001
      - 0.9450000000000001
      rl_thigh_joint: !!python/tuple
      - -1.6662036732051035
      - 2.8877963267948967
      rl_calf_joint: !!python/tuple
      - -2.015
      - -0.4849999999999999
    joint_names:
    - fr_hip_joint
    - fr_thigh_joint
    - fr_calf_joint
    - fl_hip_joint
    - fl_thigh_joint
    - fl_calf_joint
    - rr_hip_joint
    - rr_thigh_joint
    - rr_calf_joint
    - rl_hip_joint
    - rl_thigh_joint
    - rl_calf_joint
    scale:
      .*_hip_joint: 0.2
      .*_(thigh|calf)_joint: 0.5
    offset: 0.0
    preserve_order: true
    use_default_offset: true
events:
  randomize_rigid_body_material:
    func: isaaclab.envs.mdp.events:randomize_rigid_body_material
    params:
      asset_cfg:
        name: robot
        joint_names: null
        joint_ids: !!python/object/apply:builtins.slice
        - null
        - null
        - null
        fixed_tendon_names: null
        fixed_tendon_ids: !!python/object/apply:builtins.slice
        - null
        - null
        - null
        body_names: .*
        body_ids: !!python/object/apply:builtins.slice
        - null
        - null
        - null
        object_collection_names: null
        object_collection_ids: !!python/object/apply:builtins.slice
        - null
        - null
        - null
        preserve_order: false
      static_friction_range: !!python/tuple
      - 0.3
      - 1.0
      dynamic_friction_range: !!python/tuple
      - 0.3
      - 0.8
      restitution_range: !!python/tuple
      - 0.0
      - 0.5
      num_buckets: 64
    mode: startup
    interval_range_s: null
    is_global_time: false
    min_step_count_between_reset: 0
  randomize_rigid_body_mass_base:
    func: isaaclab.envs.mdp.events:randomize_rigid_body_mass
    params:
      asset_cfg:
        name: robot
        joint_names: null
        joint_ids: !!python/object/apply:builtins.slice
        - null
        - null
        - null
        fixed_tendon_names: null
        fixed_tendon_ids: !!python/object/apply:builtins.slice
        - null
        - null
        - null
        body_names:
        - base_link
        body_ids: !!python/object/apply:builtins.slice
        - null
        - null
        - null
        object_collection_names: null
        object_collection_ids: !!python/object/apply:builtins.slice
        - null
        - null
        - null
        preserve_order: false
      mass_distribution_params: !!python/tuple
      - 0.9
      - 1.1
      operation: scale
      recompute_inertia: true
    mode: startup
    interval_range_s: null
    is_global_time: false
    min_step_count_between_reset: 0
  randomize_rigid_body_mass_others:
    func: isaaclab.envs.mdp.events:randomize_rigid_body_mass
    params:
      asset_cfg:
        name: robot
        joint_names: null
        joint_ids: !!python/object/apply:builtins.slice
        - null
        - null
        - null
        fixed_tendon_names: null
        fixed_tendon_ids: !!python/object/apply:builtins.slice
        - null
        - null
        - null
        body_names:
        - ^(?!.*base_link).*
        body_ids: !!python/object/apply:builtins.slice
        - null
        - null
        - null
        object_collection_names: null
        object_collection_ids: !!python/object/apply:builtins.slice
        - null
        - null
        - null
        preserve_order: false
      mass_distribution_params: !!python/tuple
      - 0.9
      - 1.1
      operation: scale
      recompute_inertia: true
    mode: startup
    interval_range_s: null
    is_global_time: false
    min_step_count_between_reset: 0
  randomize_com_positions: null
  randomize_apply_external_force_torque: null
  randomize_reset_joints:
    func: isaaclab.envs.mdp.events:reset_joints_by_scale
    params:
      position_range: !!python/tuple
      - 1.0
      - 1.0
      velocity_range: !!python/tuple
      - 0.0
      - 0.0
    mode: reset
    interval_range_s: null
    is_global_time: false
    min_step_count_between_reset: 0
  randomize_actuator_gains:
    func: isaaclab.envs.mdp.events:randomize_actuator_gains
    params:
      asset_cfg:
        name: robot
        joint_names: .*
        joint_ids: !!python/object/apply:builtins.slice
        - null
        - null
        - null
        fixed_tendon_names: null
        fixed_tendon_ids: !!python/object/apply:builtins.slice
        - null
        - null
        - null
        body_names: null
        body_ids: !!python/object/apply:builtins.slice
        - null
        - null
        - null
        object_collection_names: null
        object_collection_ids: !!python/object/apply:builtins.slice
        - null
        - null
        - null
        preserve_order: false
      stiffness_distribution_params: !!python/tuple
      - 0.8
      - 1.2
      damping_distribution_params: !!python/tuple
      - 0.8
      - 1.2
      operation: scale
      distribution: uniform
    mode: reset
    interval_range_s: null
    is_global_time: false
    min_step_count_between_reset: 0
  randomize_reset_base:
    func: robot_lab.tasks.manager_based.recovery.config.orix_frnet.mdp_v5:reset_paper_fallen
    params:
      asset_cfg:
        name: robot
        joint_names: null
        joint_ids: !!python/object/apply:builtins.slice
        - null
        - null
        - null
        fixed_tendon_names: null
        fixed_tendon_ids: !!python/object/apply:builtins.slice
        - null
        - null
        - null
        body_names: null
        body_ids: !!python/object/apply:builtins.slice
        - null
        - null
        - null
        object_collection_names: null
        object_collection_ids: !!python/object/apply:builtins.slice
        - null
        - null
        - null
        preserve_order: false
    mode: reset
    interval_range_s: null
    is_global_time: false
    min_step_count_between_reset: 0
  randomize_push_robot: null
rerender_on_reset: false
wait_for_textures: true
xr: null
teleop_devices:
  devices: {}
export_io_descriptors: false
log_dir: logs/rsl_rl/orix_frnet_flat_paper_v5/2026-11-12_20-10-14_orix_headless_v5_eps025_t17_scratch_2500
is_finite_horizon: false
episode_length_s: 7.0
rewards:
  base_orientation:
    func: robot_lab.tasks.manager_based.recovery.config.orix_frnet.rewards_v4:gravity_xy_squared
    params:
      asset_cfg:
        name: robot
        joint_names:
        - fr_hip_joint
        - fr_thigh_joint
        - fr_calf_joint
        - fl_hip_joint
        - fl_thigh_joint
        - fl_calf_joint
        - rr_hip_joint
        - rr_thigh_joint
        - rr_calf_joint
        - rl_hip_joint
        - rl_thigh_joint
        - rl_calf_joint
        joint_ids: !!python/object/apply:builtins.slice
        - null
        - null
        - null
        fixed_tendon_names: null
        fixed_tendon_ids: !!python/object/apply:builtins.slice
        - null
        - null
        - null
        body_names: null
        body_ids: !!python/object/apply:builtins.slice
        - null
        - null
        - null
        object_collection_names: null
        object_collection_ids: !!python/object/apply:builtins.slice
        - null
        - null
        - null
        preserve_order: true
    weight: -0.5
  upright:
    func: robot_lab.tasks.manager_based.recovery.config.orix_frnet.rewards_v4:upright_gaussian
    params:
      asset_cfg:
        name: robot
        joint_names:
        - fr_hip_joint
        - fr_thigh_joint
        - fr_calf_joint
        - fl_hip_joint
        - fl_thigh_joint
        - fl_calf_joint
        - rr_hip_joint
        - rr_thigh_joint
        - rr_calf_joint
        - rl_hip_joint
        - rl_thigh_joint
        - rl_calf_joint
        joint_ids: !!python/object/apply:builtins.slice
        - null
        - null
        - null
        fixed_tendon_names: null
        fixed_tendon_ids: !!python/object/apply:builtins.slice
        - null
        - null
        - null
        body_names: null
        body_ids: !!python/object/apply:builtins.slice
        - null
        - null
        - null
        object_collection_names: null
        object_collection_ids: !!python/object/apply:builtins.slice
        - null
        - null
        - null
        preserve_order: true
      epsilon: 0.25
    weight: 6.0
  target_posture:
    func: robot_lab.tasks.manager_based.recovery.config.orix_frnet.rewards_v4:target_posture
    params:
      asset_cfg:
        name: robot
        joint_names:
        - fr_hip_joint
        - fr_thigh_joint
        - fr_calf_joint
        - fl_hip_joint
        - fl_thigh_joint
        - fl_calf_joint
        - rr_hip_joint
        - rr_thigh_joint
        - rr_calf_joint
        - rl_hip_joint
        - rl_thigh_joint
        - rl_calf_joint
        joint_ids: !!python/object/apply:builtins.slice
        - null
        - null
        - null
        fixed_tendon_names: null
        fixed_tendon_ids: !!python/object/apply:builtins.slice
        - null
        - null
        - null
        body_names: null
        body_ids: !!python/object/apply:builtins.slice
        - null
        - null
        - null
        object_collection_names: null
        object_collection_ids: !!python/object/apply:builtins.slice
        - null
        - null
        - null
        preserve_order: true
      epsilon: 0.1
    weight: 4.0
  foot_contact:
    func: robot_lab.tasks.manager_based.recovery.config.orix_frnet.rewards_v4:foot_contact_count
    params:
      sensor_cfg:
        name: contact_forces
        joint_names: null
        joint_ids: !!python/object/apply:builtins.slice
        - null
        - null
        - null
        fixed_tendon_names: null
        fixed_tendon_ids: !!python/object/apply:builtins.slice
        - null
        - null
        - null
        body_names:
        - fr_foot_Link
        - fl_foot_Link
        - rr_foot_Link
        - rl_foot_Link
        body_ids: !!python/object/apply:builtins.slice
        - null
        - null
        - null
        object_collection_names: null
        object_collection_ids: !!python/object/apply:builtins.slice
        - null
        - null
        - null
        preserve_order: false
    weight: 0.3
  body_contact:
    func: robot_lab.tasks.manager_based.recovery.config.orix_frnet.rewards_v4:body_contact_binary
    params:
      sensor_cfg:
        name: contact_forces
        joint_names: null
        joint_ids: !!python/object/apply:builtins.slice
        - null
        - null
        - null
        fixed_tendon_names: null
        fixed_tendon_ids: !!python/object/apply:builtins.slice
        - null
        - null
        - null
        body_names:
        - base_link
        - battery_guide_link
        - battery_pack_trial_link
        - fr_hip_Link
        - fl_hip_Link
        - rr_hip_Link
        - rl_hip_Link
        - fr_thigh_Link
        - fl_thigh_Link
        - rr_thigh_Link
        - rl_thigh_Link
        - fr_calf_Link
        - fl_calf_Link
        - rr_calf_Link
        - rl_calf_Link
        body_ids: !!python/object/apply:builtins.slice
        - null
        - null
        - null
        object_collection_names: null
        object_collection_ids: !!python/object/apply:builtins.slice
        - null
        - null
        - null
        preserve_order: false
    weight: -0.2
  knee_horizontal_force:
    func: robot_lab.tasks.manager_based.recovery.config.orix_frnet.rewards_v4:horizontal_contact_force
    params:
      sensor_cfg:
        name: contact_forces
        joint_names: null
        joint_ids: !!python/object/apply:builtins.slice
        - null
        - null
        - null
        fixed_tendon_names: null
        fixed_tendon_ids: !!python/object/apply:builtins.slice
        - null
        - null
        - null
        body_names:
        - fr_calf_Link
        - fl_calf_Link
        - rr_calf_Link
        - rl_calf_Link
        body_ids: !!python/object/apply:builtins.slice
        - null
        - null
        - null
        object_collection_names: null
        object_collection_ids: !!python/object/apply:builtins.slice
        - null
        - null
        - null
        preserve_order: false
    weight: -0.01
  body_xy_displacement:
    func: robot_lab.tasks.manager_based.recovery.config.orix_frnet.rewards_v4:body_xy_displacement
    params:
      asset_cfg:
        name: robot
        joint_names:
        - fr_hip_joint
        - fr_thigh_joint
        - fr_calf_joint
        - fl_hip_joint
        - fl_thigh_joint
        - fl_calf_joint
        - rr_hip_joint
        - rr_thigh_joint
        - rr_calf_joint
        - rl_hip_joint
        - rl_thigh_joint
        - rl_calf_joint
        joint_ids: !!python/object/apply:builtins.slice
        - null
        - null
        - null
        fixed_tendon_names: null
        fixed_tendon_ids: !!python/object/apply:builtins.slice
        - null
        - null
        - null
        body_names: null
        body_ids: !!python/object/apply:builtins.slice
        - null
        - null
        - null
        object_collection_names: null
        object_collection_ids: !!python/object/apply:builtins.slice
        - null
        - null
        - null
        preserve_order: true
    weight: -0.1
  joint_position_limits:
    func: robot_lab.tasks.manager_based.recovery.config.orix_frnet.rewards_v4:hard_joint_limit_violations
    params:
      asset_cfg:
        name: robot
        joint_names:
        - fr_hip_joint
        - fr_thigh_joint
        - fr_calf_joint
        - fl_hip_joint
        - fl_thigh_joint
        - fl_calf_joint
        - rr_hip_joint
        - rr_thigh_joint
        - rr_calf_joint
        - rl_hip_joint
        - rl_thigh_joint
        - rl_calf_joint
        joint_ids: !!python/object/apply:builtins.slice
        - null
        - null
        - null
        fixed_tendon_names: null
        fixed_tendon_ids: !!python/object/apply:builtins.slice
        - null
        - null
        - null
        body_names: null
        body_ids: !!python/object/apply:builtins.slice
        - null
        - null
        - null
        object_collection_names: null
        object_collection_ids: !!python/object/apply:builtins.slice
        - null
        - null
        - null
        preserve_order: true
    weight: -1.0
  joint_velocity_limits:
    func: robot_lab.tasks.manager_based.recovery.config.orix_frnet.rewards_v4:excess_joint_velocity
    params:
      asset_cfg:
        name: robot
        joint_names:
        - fr_hip_joint
        - fr_thigh_joint
        - fr_calf_joint
        - fl_hip_joint
        - fl_thigh_joint
        - fl_calf_joint
        - rr_hip_joint
        - rr_thigh_joint
        - rr_calf_joint
        - rl_hip_joint
        - rl_thigh_joint
        - rl_calf_joint
        joint_ids: !!python/object/apply:builtins.slice
        - null
        - null
        - null
        fixed_tendon_names: null
        fixed_tendon_ids: !!python/object/apply:builtins.slice
        - null
        - null
        - null
        body_names: null
        body_ids: !!python/object/apply:builtins.slice
        - null
        - null
        - null
        object_collection_names: null
        object_collection_ids: !!python/object/apply:builtins.slice
        - null
        - null
        - null
        preserve_order: true
      threshold: 0.8
    weight: -0.1
  joint_acceleration:
    func: robot_lab.tasks.manager_based.recovery.config.orix_frnet.rewards_v4:joint_acceleration_squared
    params:
      asset_cfg:
        name: robot
        joint_names:
        - fr_hip_joint
        - fr_thigh_joint
        - fr_calf_joint
        - fl_hip_joint
        - fl_thigh_joint
        - fl_calf_joint
        - rr_hip_joint
        - rr_thigh_joint
        - rr_calf_joint
        - rl_hip_joint
        - rl_thigh_joint
        - rl_calf_joint
        joint_ids: !!python/object/apply:builtins.slice
        - null
        - null
        - null
        fixed_tendon_names: null
        fixed_tendon_ids: !!python/object/apply:builtins.slice
        - null
        - null
        - null
        body_names: null
        body_ids: !!python/object/apply:builtins.slice
        - null
        - null
        - null
        object_collection_names: null
        object_collection_ids: !!python/object/apply:builtins.slice
        - null
        - null
        - null
        preserve_order: true
    weight: -2.5e-06
  joint_velocity:
    func: robot_lab.tasks.manager_based.recovery.config.orix_frnet.rewards_v4:joint_velocity_squared
    params:
      asset_cfg:
        name: robot
        joint_names:
        - fr_hip_joint
        - fr_thigh_joint
        - fr_calf_joint
        - fl_hip_joint
        - fl_thigh_joint
        - fl_calf_joint
        - rr_hip_joint
        - rr_thigh_joint
        - rr_calf_joint
        - rl_hip_joint
        - rl_thigh_joint
        - rl_calf_joint
        joint_ids: !!python/object/apply:builtins.slice
        - null
        - null
        - null
        fixed_tendon_names: null
        fixed_tendon_ids: !!python/object/apply:builtins.slice
        - null
        - null
        - null
        body_names: null
        body_ids: !!python/object/apply:builtins.slice
        - null
        - null
        - null
        object_collection_names: null
        object_collection_ids: !!python/object/apply:builtins.slice
        - null
        - null
        - null
        preserve_order: true
    weight: -0.01
  action_smoothness:
    func: robot_lab.tasks.manager_based.recovery.config.orix_frnet.rewards_v4:action_delta_squared
    params: {}
    weight: -0.01
  joint_torque:
    func: robot_lab.tasks.manager_based.recovery.config.orix_frnet.rewards_v4:applied_torque_squared
    params:
      asset_cfg:
        name: robot
        joint_names:
        - fr_hip_joint
        - fr_thigh_joint
        - fr_calf_joint
        - fl_hip_joint
        - fl_thigh_joint
        - fl_calf_joint
        - rr_hip_joint
        - rr_thigh_joint
        - rr_calf_joint
        - rl_hip_joint
        - rl_thigh_joint
        - rl_calf_joint
        joint_ids: !!python/object/apply:builtins.slice
        - null
        - null
        - null
        fixed_tendon_names: null
        fixed_tendon_ids: !!python/object/apply:builtins.slice
        - null
        - null
        - null
        body_names: null
        body_ids: !!python/object/apply:builtins.slice
        - null
        - null
        - null
        object_collection_names: null
        object_collection_ids: !!python/object/apply:builtins.slice
        - null
        - null
        - null
        preserve_order: true
    weight: -0.0005
  recovery_diagnostics:
    func: robot_lab.tasks.manager_based.recovery.config.orix_frnet.metrics_v5:paper_recovery_diagnostics
    params: {}
    weight: 1.0
terminations:
  time_out:
    func: isaaclab.envs.mdp.terminations:time_out
    params: {}
    time_out: true
  terrain_out_of_bounds:
    func: robot_lab.tasks.manager_based.locomotion.velocity.mdp.terminations:terrain_out_of_bounds
    params:
      asset_cfg:
        name: robot
        joint_names: null
        joint_ids: !!python/object/apply:builtins.slice
        - null
        - null
        - null
        fixed_tendon_names: null
        fixed_tendon_ids: !!python/object/apply:builtins.slice
        - null
        - null
        - null
        body_names: null
        body_ids: !!python/object/apply:builtins.slice
        - null
        - null
        - null
        object_collection_names: null
        object_collection_ids: !!python/object/apply:builtins.slice
        - null
        - null
        - null
        preserve_order: false
      distance_buffer: 3.0
    time_out: true
  illegal_contact: null
curriculum:
  terrain_levels: null
  disturbance_levels: null
  mass_randomization_levels: null
  com_randomization_levels: null
  command_levels: null
  recovery: null
  paper_evaluation:
    func: robot_lab.tasks.manager_based.recovery.config.orix_frnet.metrics_v5:paper_episode_metrics
    params: {}
commands:
  base_velocity:
    class_type: robot_lab.tasks.manager_based.locomotion.velocity.mdp.commands:UniformThresholdVelocityCommand
    resampling_time_range: !!python/tuple
    - 10.0
    - 10.0
    debug_vis: true
    asset_name: robot
    heading_command: true
    heading_control_stiffness: 0.5
    rel_standing_envs: 0.02
    rel_heading_envs: 1.0
    ranges:
      lin_vel_x: !!python/tuple
      - 0.0
      - 0.0
      lin_vel_y: !!python/tuple
      - 0.0
      - 0.0
      ang_vel_z: !!python/tuple
      - 0.0
      - 0.0
      heading: !!python/tuple
      - -3.141592653589793
      - 3.141592653589793
    goal_vel_visualizer_cfg:
      prim_path: /Visuals/Command/velocity_goal
      markers:
        arrow:
          func: isaaclab.sim.spawners.from_files.from_files:spawn_from_usd
          visible: true
          semantic_tags: null
          copy_from_source: true
          mass_props: null
          deformable_props: null
          rigid_props: null
          collision_props: null
          activate_contact_sensors: false
          scale: !!python/tuple
          - 0.5
          - 0.5
          - 0.5
          articulation_props: null
          fixed_tendons_props: null
          spatial_tendons_props: null
          joint_drive_props: null
          visual_material_path: material
          visual_material:
            func: isaaclab.sim.spawners.materials.visual_materials:spawn_preview_surface
            diffuse_color: !!python/tuple
            - 0.0
            - 1.0
            - 0.0
            emissive_color: !!python/tuple
            - 0.0
            - 0.0
            - 0.0
            roughness: 0.5
            metallic: 0.0
            opacity: 1.0
          usd_path: http://omniverse-content-production.s3-us-west-2.amazonaws.com/Assets/Isaac/4.5/Isaac/Props/UIElements/arrow_x.usd
          variants: null
    current_vel_visualizer_cfg:
      prim_path: /Visuals/Command/velocity_current
      markers:
        arrow:
          func: isaaclab.sim.spawners.from_files.from_files:spawn_from_usd
          visible: true
          semantic_tags: null
          copy_from_source: true
          mass_props: null
          deformable_props: null
          rigid_props: null
          collision_props: null
          activate_contact_sensors: false
          scale: !!python/tuple
          - 0.5
          - 0.5
          - 0.5
          articulation_props: null
          fixed_tendons_props: null
          spatial_tendons_props: null
          joint_drive_props: null
          visual_material_path: material
          visual_material:
            func: isaaclab.sim.spawners.materials.visual_materials:spawn_preview_surface
            diffuse_color: !!python/tuple
            - 0.0
            - 0.0
            - 1.0
            emissive_color: !!python/tuple
            - 0.0
            - 0.0
            - 0.0
            roughness: 0.5
            metallic: 0.0
            opacity: 1.0
          usd_path: http://omniverse-content-production.s3-us-west-2.amazonaws.com/Assets/Isaac/4.5/Isaac/Props/UIElements/arrow_x.usd
          variants: null
base_link_name: base_link
foot_link_name: .*_foot_Link
