Kitjesen/orix/(commit log)

2026-10-15 Publish ORIX V67 robot assets and R6 training snapshot
    [SD-V67_continuous_head_tail.SLDASM, SD-V67_continuous_head_tail.step, base_link.STL, battery_guide_trial.STL, black_visor.SLDPRT, black_visor.step, black_visor.stl, body_editable_master.SLDPRT]
2026-11-12 Publish headless V67 asset with revised recovery joint limits
    [smalldog_v67.urdf]
2026-11-12 Rebuild the headless asset with consistent actuator limits
